aiex718/CCTV3.0-F407/MDK/CCTV3_F407_MDK_REV200/Web/img/constructive_bg_03.jpg

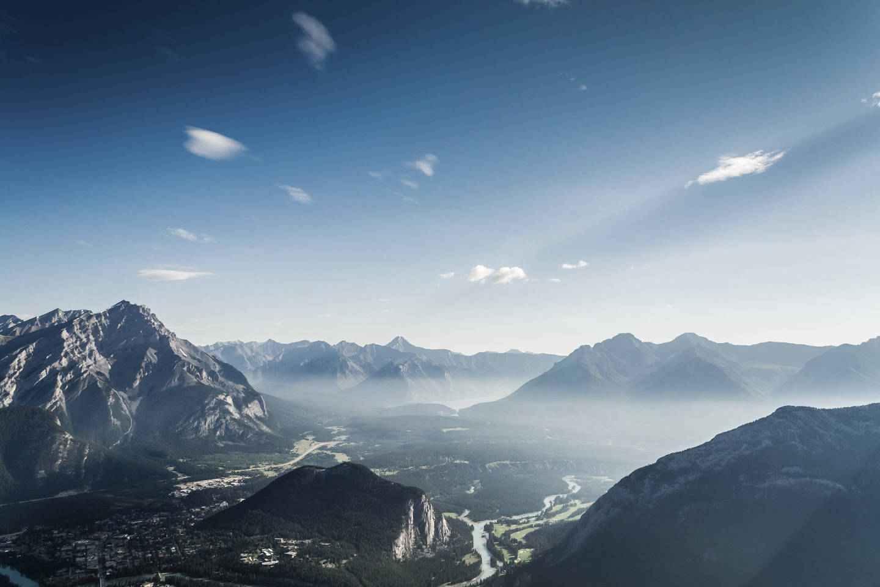
MDK/CCTV3_F407_MDK_REV200/Web/img/constructive_bg_03.jpg
