aiex718/CCTV3.0-F407/PCB/CCTV3_F407_REV200/CubeMX/CCTV3_F407_REV200.pdf

25/10/2022

CCTV3_F407_REV200 Project
Configuration Report

## 1. Description

### 1.1. Project

Project Name | CCTV3_F407_REV200
Board Name | custom
Generated with: | STM32CubeMX 6.5.0
Date | 10/25/2022

### 1.2. MCU

MCU Series | STM32F4
MCU Line | STM32F407/417
MCU name | STM32F407VETx
MCU Package | LQFP100
MCU Pin number | 100

### 1.3. Core(s) information

Core(s) | Arm Cortex-M4

## 2. Pinout Configuration

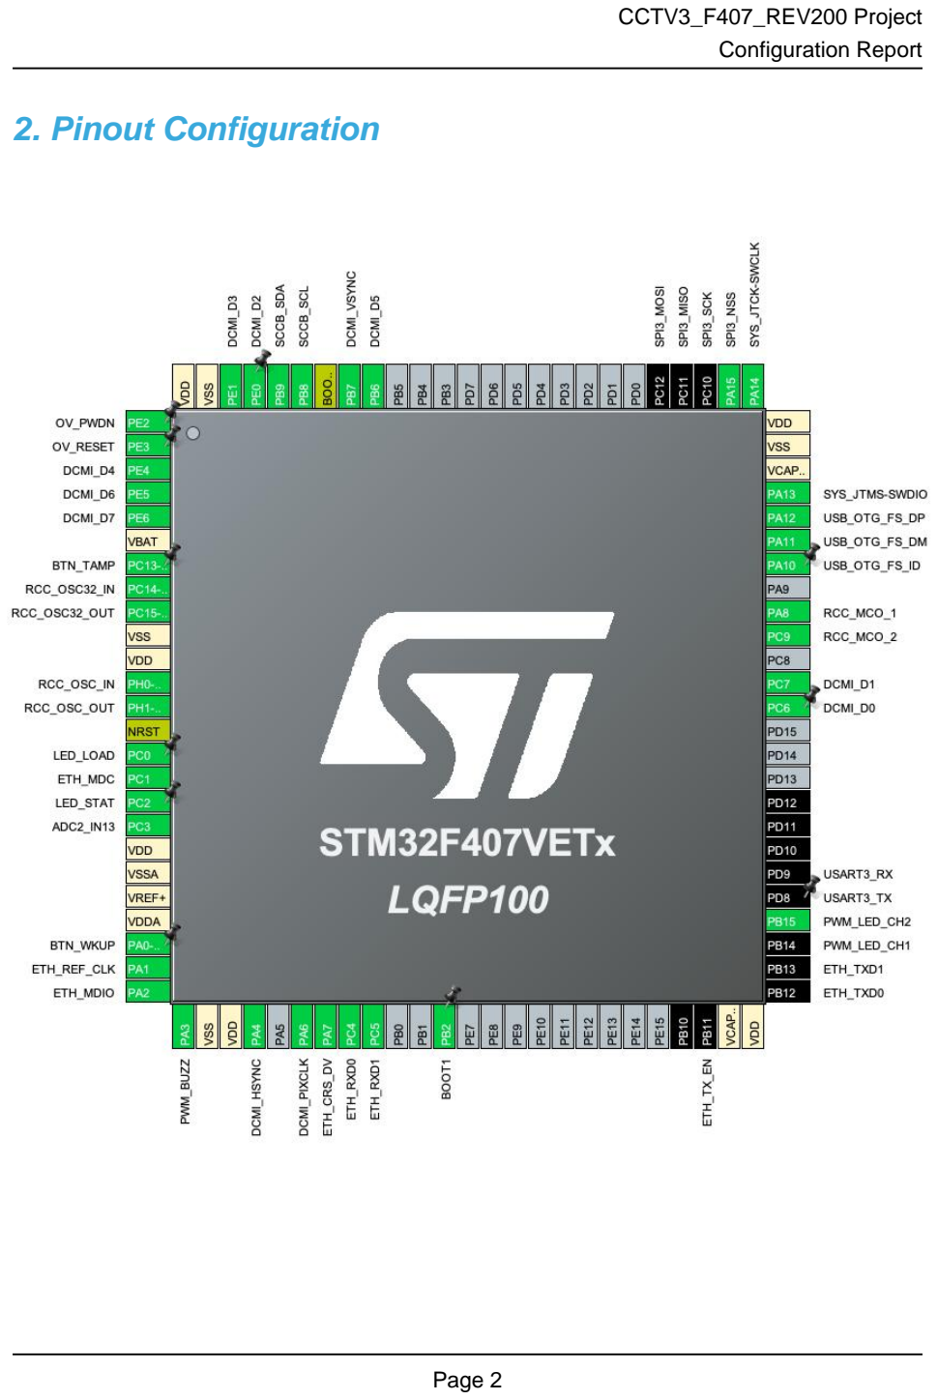
[picture p4: page 3]

## 3. Pins Configuration

Pin Number LQFP100 | Pin Name (function after reset) | Pin Type | Alternate Function(s) | Label
1 | PE2 * | I/O | GPIO_Output | OV_PWDN
2 | PE3 * | I/O | GPIO_Output | OV_RESET
3 | PE4 | I/O | DCMI_D4
4 | PE5 | I/O | DCMI_D6
5 | PE6 | I/O | DCMI_D7
6 | VBAT | Power
7 | PC13-ANTI_TAMP * | I/O | GPIO_Input | BTN_TAMP
8 | PC14-OSC32_IN | I/O | RCC_OSC32_IN
9 | PC15-OSC32_OUT | I/O | RCC_OSC32_OUT
10 | VSS | Power
11 | VDD | Power
12 | PH0-OSC_IN | I/O | RCC_OSC_IN
13 | PH1-OSC_OUT | I/O | RCC_OSC_OUT
14 | NRST | Reset
15 | PC0 * | I/O | GPIO_Output | LED_LOAD
16 | PC1 | I/O | ETH_MDC
17 | PC2 * | I/O | GPIO_Output | LED_STAT
18 | PC3 | I/O | ADC2_IN13
19 | VDD | Power
20 | VSSA | Power
21 | VREF+ | Power
22 | VDDA | Power
23 | PA0-WKUP * | I/O | GPIO_Input | BTN_WKUP
24 | PA1 | I/O | ETH_REF_CLK
25 | PA2 | I/O | ETH_MDIO
26 | PA3 | I/O | TIM9_CH2 | PWM_BUZZ
27 | VSS | Power
28 | VDD | Power
29 | PA4 | I/O | DCMI_HSYNC
31 | PA6 | I/O | DCMI_PIXCLK
32 | PA7 | I/O | ETH_CRS_DV
33 | PC4 | I/O | ETH_RXD0
34 | PC5 | I/O | ETH_RXD1
37 | PB2 * | I/O | GPIO_Input | BOOT1
48 | PB11 | I/O | ETH_TX_EN
49 | VCAP_1 | Power

Pin Number LQFP100 | Pin Name (function after reset) | Pin Type | Alternate Function(s) | Label
50 | VDD | Power
51 | PB12 | I/O | ETH_TXD0
52 | PB13 | I/O | ETH_TXD1
53 | PB14 | I/O | TIM12_CH1 | PWM_LED_CH1
54 | PB15 | I/O | TIM12_CH2 | PWM_LED_CH2
55 | PD8 | I/O | USART3_TX
56 | PD9 | I/O | USART3_RX
63 | PC6 | I/O | DCMI_D0
64 | PC7 | I/O | DCMI_D1
66 | PC9 | I/O | RCC_MCO_2
67 | PA8 | I/O | RCC_MCO_1
69 | PA10 * | I/O | GPIO_Input | USB_OTG_FS_ID
70 | PA11 | I/O | USB_OTG_FS_DM
71 | PA12 | I/O | USB_OTG_FS_DP
72 | PA13 | I/O | SYS_JTMS-SWDIO
73 | VCAP_2 | Power
74 | VSS | Power
75 | VDD | Power
76 | PA14 | I/O | SYS_JTCK-SWCLK
77 | PA15 | I/O | SPI3_NSS
78 | PC10 | I/O | SPI3_SCK
79 | PC11 | I/O | SPI3_MISO
80 | PC12 | I/O | SPI3_MOSI
92 | PB6 | I/O | DCMI_D5
93 | PB7 | I/O | DCMI_VSYNC
94 | BOOT0 | Boot
95 | PB8 | I/O | I2C1_SCL | SCCB_SCL
96 | PB9 | I/O | I2C1_SDA | SCCB_SDA
97 | PE0 | I/O | DCMI_D2
98 | PE1 | I/O | DCMI_D3
99 | VSS | Power
100 | VDD | Power

* The pin is affected with an I/O function

## 4. Clock Tree Configuration

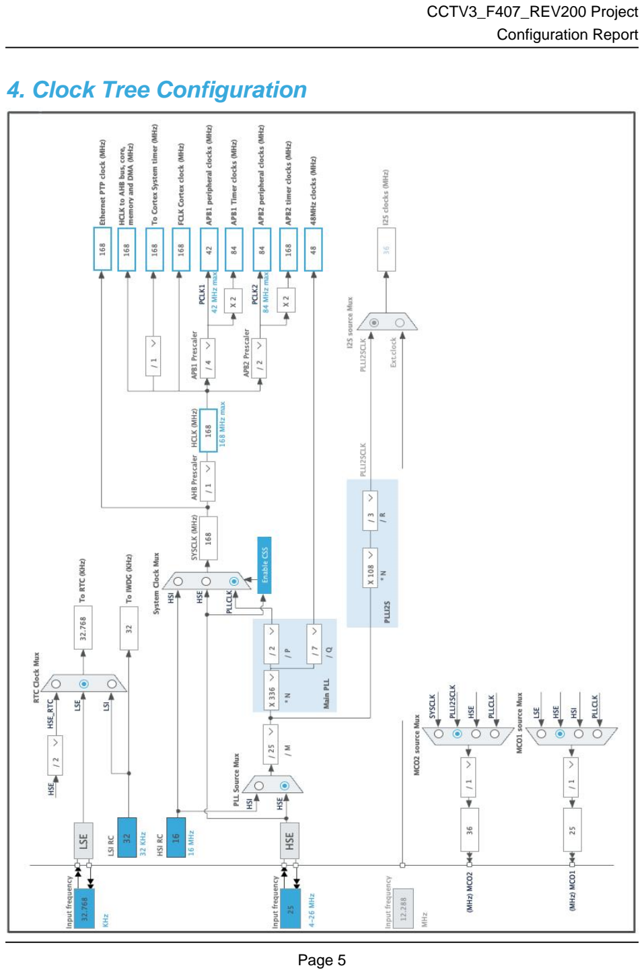
[picture p5: page 6]

## 5. Software Project

### 5.1. Project Settings

Name | Value
Project Name | CCTV3_F407_REV200
Project Folder | /Users/aiex718/Private/Workspace/CCTV3.0-
Toolchain / IDE | EWARM V8.50
Firmware Package Name and Version | STM32Cube FW_F4 V1.27.1
Application Structure | Advanced
Generate Under Root | No
Do not generate the main() | No
Minimum Heap Size | 0x200
Minimum Stack Size | 0x400

### 5.2. Code Generation Settings

Name | Value
STM32Cube MCU packages and embedded software | Copy all used libraries into the project folder
Generate peripheral initialization as a pair of '.c/.h' files | No
Backup previously generated files when re-generating | No
Keep User Code when re-generating | Yes
Delete previously generated files when not re-generated | Yes
Set all free pins as analog (to optimize the power consumption) | No
Enable Full Assert | No

### 5.3. Advanced Settings - Generated Function Calls

Rank | Function Name | Peripheral Instance Name
1 | SystemClock_Config | RCC
2 | MX_GPIO_Init | GPIO
3 | MX_ADC1_Init | ADC1
4 | MX_ADC2_Init | ADC2
5 | MX_DCMI_Init | DCMI
6 | MX_ETH_Init | ETH
7 | MX_I2C1_Init | I2C1
8 | MX_IWDG_Init | IWDG
9 | MX_RNG_Init | RNG
10 | MX_RTC_Init | RTC
11 | MX_SPI3_Init | SPI3

Rank | Function Name | Peripheral Instance Name
12 | MX_TIM9_Init | TIM9
13 | MX_TIM12_Init | TIM12
14 | MX_USART3_UART_Init | USART3
15 | MX_FATFS_Init | FATFS
16 | MX_USB_DEVICE_Init | USB_DEVICE

## 6. Power Consumption Calculator report

### 6.1. Microcontroller Selection

Series | STM32F4
Line | STM32F407/417
MCU | STM32F407VETx
Datasheet | DS8626_Rev8

### 6.2. Parameter Selection

Temperature | 25
Vdd | 3.3

### 6.3. Battery Selection

Battery | Li-SOCL2(A3400)
Capacity | 3400.0 mAh
Self Discharge | 0.08 %/month
Nominal Voltage | 3.6 V
Max Cont Current | 100.0 mA
Max Pulse Current | 200.0 mA
Cells in series | 1
Cells in parallel | 1

### 6.4. Sequence

Step | Step1 | Step2
Mode | RUN | STOP
Vdd | 3.3 | 3.3
Voltage Source | Battery | Battery
Range | Scale1-High | No Scale
Fetch Type | FLASH | n/a
CPU Frequency | 168 MHz | 0 Hz
Clock Configuration | HSE PLL | Regulator_LP Flash-PwrDwn
Clock Source Frequency | 4 MHz | 0 Hz
Peripherals
Additional Cons. | 0 mA | 0 mA
Average Current | 46 mA | 280 µA
Duration | 0.1 ms | 0.9 ms
DMIPS | 210.0 | 0.0
Ta Max | 98.47 | 104.96
Category | In DS Table | In DS Table

### 6.5. Results

Sequence Time | 1 ms | Average Current | 4.85 mA
Battery Life | 29 days, 4 hours | Average DMIPS | 210.0 DMIPS

### 6.6. Chart

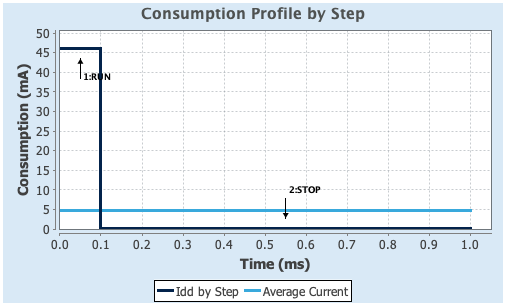
[picture p6: figure]

## 7. Peripherals and Middlewares Configuration

### 7.1. ADC1

mode: Temperature Sensor Channel
7.1.1. Parameter Settings:

ADCs_Common_Settings:

Mode | Independent mode
ADC_Settings:
Clock Prescaler | PCLK2 divided by 4
Resolution | 12 bits (15 ADC Clock cycles)
Data Alignment | Right alignment
Scan Conversion Mode | Disabled
Continuous Conversion Mode | Disabled
Discontinuous Conversion Mode | Disabled
DMA Continuous Requests | Disabled
End Of Conversion Selection | EOC flag at the end of single channel conversion
ADC_Regular_ConversionMode:
Number Of Conversion | 1
External Trigger Conversion Source | Regular Conversion launched by software
External Trigger Conversion Edge | None
Rank | 1
Channel | Channel Temperature Sensor
Sampling Time | 3 Cycles
ADC_Injected_ConversionMode:
Number Of Conversions | 0
WatchDog:
Enable Analog WatchDog Mode | false

### 7.2. ADC2

mode: IN13
7.2.1. Parameter Settings:

ADCs_Common_Settings:

Mode | Independent mode
ADC_Settings:
Clock Prescaler | PCLK2 divided by 4
Resolution | 12 bits (15 ADC Clock cycles)
Data Alignment | Right alignment

Scan Conversion Mode | Disabled
Continuous Conversion Mode | Disabled
Discontinuous Conversion Mode | Disabled
DMA Continuous Requests | Disabled
End Of Conversion Selection | EOC flag at the end of single channel conversion
ADC_Regular_ConversionMode:
Number Of Conversion | 1
External Trigger Conversion Source | Regular Conversion launched by software
External Trigger Conversion Edge | None
Rank | 1
Channel | Channel 13
Sampling Time | 3 Cycles
ADC_Injected_ConversionMode:
Number Of Conversions | 0
WatchDog:
Enable Analog WatchDog Mode | false

### 7.3. DCMI

DCMI: Slave 8 bits External Synchro
7.3.1. Parameter Settings:

Mode Config:

Pixel clock polarity | Active on Falling edge
Vertical synchronization polarity | Active Low
Horizontal synchronization polarity | Active Low
Frequency of frame capture | All frames are captured
JPEG mode | Disabled

### 7.4. ETH

Mode: RMII
7.4.1. Parameter Settings:

General : Ethernet Configuration:

Ethernet MAC Address | 00:80:E1:00:00:00
Rx Buffers Length | 1524
Ethernet Basic Configuration:
Rx Mode | Polling Mode

7.4.2. Advanced Parameters:

External PHY Configuration:

PHY | LAN8742A_PHY_ADDRESS
PHY Reset delay these values are based on a 1 ms Systick interrupt | 0x000000FF *
PHY Configuration delay | 0x00000FFF *
PHY Read TimeOut | 0x0000FFFF *
PHY Write TimeOut | 0x0000FFFF *
Common : External PHY Configuration:
Transceiver Basic Control Register | 0x00 *
Transceiver Basic Status Register | 0x01 *
PHY Reset | 0x8000 *
Select loop-back mode | 0x4000 *
Set the full-duplex mode at 100 Mb/s | 0x2100 *
Set the half-duplex mode at 100 Mb/s | 0x2000 *
Set the full-duplex mode at 10 Mb/s | 0x0100 *
Set the half-duplex mode at 10 Mb/s | 0x0000 *
Enable auto-negotiation function | 0x1000 *
Restart auto-negotiation function | 0x0200 *
Select the power down mode | 0x0800 *
Isolate PHY from MII | 0x0400 *
Auto-Negotiation process completed | 0x0020 *
Valid link established | 0x0004 *
Jabber condition detected | 0x0002 *
Extended : External PHY Configuration:
PHY special control/status register Offset | 0x10 *
PHY Speed mask | 0x0002 *
PHY Duplex mask | 0x0004 *
PHY Interrupt Source Flag register Offset | 0x001D *
PHY Link down inturrupt | 0x000B *

### 7.5. I2C1

I2C: I2C
7.5.1. Parameter Settings:

Master Features:

I2C Speed Mode | Standard Mode
I2C Clock Speed (Hz) | 100000
Slave Features:
Clock No Stretch Mode | Disabled
Primary Address Length selection | 7-bit
Dual Address Acknowledged | Disabled
Primary slave address | 0
General Call address detection | Disabled

### 7.6. IWDG

mode: Activated
7.6.1. Parameter Settings:

Clocking:

IWDG counter clock prescaler | 4
IWDG down-counter reload value | 4095

### 7.7. RCC

High Speed Clock (HSE): Crystal/Ceramic Resonator Low Speed Clock (LSE) : Crystal/Ceramic Resonator mode: Master Clock Output 1
mode: Master Clock Output 2
7.7.1. Parameter Settings:

System Parameters:

VDD voltage (V) | 3.3
Instruction Cache | Enabled
Prefetch Buffer | Enabled
Data Cache | Enabled
Flash Latency(WS) | 5 WS (6 CPU cycle)
RCC Parameters:
HSI Calibration Value | 16

HSE Startup Timout Value (ms) | 100
LSE Startup Timout Value (ms) | 5000
Power Parameters:
Power Regulator Voltage Scale | Power Regulator Voltage Scale 1

### 7.8. RNG

mode: Activated

### 7.9. RTC

mode: Activate Clock Source
7.9.1. Parameter Settings:

General:

Hour Format | Hourformat 24
Asynchronous Predivider value | 127
Synchronous Predivider value | 255

### 7.10. SPI3

Mode: Full-Duplex Master
Hardware NSS Signal: Hardware NSS Output Signal
7.10.1. Parameter Settings:

Basic Parameters:

Frame Format | Motorola
Data Size | 8 Bits
First Bit | MSB First
Clock Parameters:
Prescaler (for Baud Rate) | 2
Baud Rate | 21.0 MBits/s *
Clock Polarity (CPOL) | Low
Clock Phase (CPHA) | 1 Edge
Advanced Parameters:
CRC Calculation | Disabled
NSS Signal Type | Output Hardware

### 7.11. SYS

Debug: Serial Wire
Timebase Source: SysTick

### 7.12. TIM9

Channel2: PWM Generation CH2
7.12.1. Parameter Settings:

Counter Settings:

Prescaler (PSC - 16 bits value) | 0
Counter Mode | Up
Counter Period (AutoReload Register - 16 bits value ) | 65535
Internal Clock Division (CKD) | No Division
auto-reload preload | Disable
PWM Generation Channel 2:
Mode | PWM mode 1
Pulse (16 bits value) | 0
Output compare preload | Enable
Fast Mode | Disable
CH Polarity | High

### 7.13. TIM12

Channel1: PWM Generation CH1 Channel2: PWM Generation CH2
7.13.1. Parameter Settings:

Counter Settings:

Prescaler (PSC - 16 bits value) | 0
Counter Mode | Up
Counter Period (AutoReload Register - 16 bits value ) | 65535
Internal Clock Division (CKD) | No Division
auto-reload preload | Disable
PWM Generation Channel 1:
Mode | PWM mode 1
Pulse (16 bits value) | 0
Output compare preload | Enable
Fast Mode | Disable

CH Polarity | High
PWM Generation Channel 2:
Mode | PWM mode 1
Pulse (16 bits value) | 0
Output compare preload | Enable
Fast Mode | Disable
CH Polarity | High

### 7.14. USART3

Mode: Asynchronous
7.14.1. Parameter Settings:

Basic Parameters:

Baud Rate | 115200
Word Length | 8 Bits (including Parity)
Parity | None
Stop Bits | 1
Advanced Parameters:
Data Direction | Receive and Transmit
Over Sampling | 16 Samples

### 7.15. USB_OTG_FS

Mode: Device_Only
7.15.1. Parameter Settings:
Speed | Device Full Speed 12MBit/s
Low power | Disabled
Link Power Management | Disabled
VBUS sensing | Disabled
Signal start of frame | Disabled

### 7.16. FATFS

mode: User-defined
7.16.1. Set Defines:

Version:

FATFS version | R0.12c
Function Parameters:
FS_READONLY (Read-only mode) | Disabled
FS_MINIMIZE (Minimization level) | Disabled
USE_STRFUNC (String functions) | Enabled with LF -> CRLF conversion
USE_FIND (Find functions) | Disabled
USE_MKFS (Make filesystem function) | Enabled
USE_FASTSEEK (Fast seek function) | Enabled
USE_EXPAND (Use f_expand function) | Disabled
USE_CHMOD (Change attributes function) | Disabled
USE_LABEL (Volume label functions) | Disabled
USE_FORWARD (Forward function) | Disabled
Locale and Namespace Parameters:
CODE_PAGE (Code page on target) | Latin 1
USE_LFN (Use Long Filename) | Disabled
MAX_LFN (Max Long Filename) | 255
LFN_UNICODE (Enable Unicode) | ANSI/OEM
STRF_ENCODE (Character encoding) | UTF-8
FS_RPATH (Relative Path) | Disabled
Physical Drive Parameters:
VOLUMES (Logical drives) | 1
MAX_SS (Maximum Sector Size) | 512
MIN_SS (Minimum Sector Size) | 512
MULTI_PARTITION (Volume partitions feature) | Disabled
USE_TRIM (Erase feature) | Disabled
FS_NOFSINFO (Force full FAT scan) | 0
System Parameters:
FS_TINY (Tiny mode) | Disabled
FS_EXFAT (Support of exFAT file system) | Disabled
FS_NORTC (Timestamp feature) | Dynamic timestamp
FS_REENTRANT (Re-Entrancy) | Disabled
FS_TIMEOUT (Timeout ticks) | 1000
FS_LOCK (Number of files opened simultaneously) | 2

### 7.17. USB_DEVICE

Class For FS IP: Mass Storage Class
7.17.1. Parameter Settings:

Basic Parameters:

USBD_MAX_NUM_INTERFACES (Maximum number of supported interfaces) | 1

USBD_MAX_NUM_CONFIGURATION (Maximum number of supported configuration) | 1
USBD_MAX_STR_DESC_SIZ (Maximum size for the string descriptors) | 512
USBD_SELF_POWERED (Enabled self power) | Enabled
USBD_DEBUG_LEVEL (USBD Debug Level) | 0: No debug message
Class Parameters:
MSC_MEDIA_PACKET (Media I/O buffer Size) | 512
7.17.2. Device Descriptor:

Device Descriptor:

VID (Vendor IDentifier) | 1155
LANGID_STRING (Language Identifier) | English(United States)
MANUFACTURER_STRING (Manufacturer Identifier) | STMicroelectronics
Device Descriptor FS:
PID (Product IDentifier) | 22314
PRODUCT_STRING (Product Identifier) | STM32 Mass Storage
CONFIGURATION_STRING (Configuration Identifier) | MSC Config
INTERFACE_STRING (Interface Identifier) | MSC Interface

* User modified value

## 8. System Configuration

### 8.1. GPIO configuration

IP | Pin | Signal | GPIO mode | GPIO pull/up pull down

Max
Speed

User Label

ADC2 | PC3 | ADC2_IN13 | Analog mode | No pull-up and no pull-down | n/a
DCMI | PE4 | DCMI_D4 | Alternate Function Push Pull | No pull-up and no pull-down | Low
| PE5 | DCMI_D6 | Alternate Function Push Pull | No pull-up and no pull-down | Low
| PE6 | DCMI_D7 | Alternate Function Push Pull | No pull-up and no pull-down | Low
PA4 | DCMI_HSYNC Alternate Function Push Pull | No pull-up and no pull-down | Low
PA6 | DCMI_PIXCLK Alternate Function Push Pull | No pull-up and no pull-down | Low
| PC6 | DCMI_D0 | Alternate Function Push Pull | No pull-up and no pull-down | Low
| PC7 | DCMI_D1 | Alternate Function Push Pull | No pull-up and no pull-down | Low
| PB6 | DCMI_D5 | Alternate Function Push Pull | No pull-up and no pull-down | Low
PB7 | DCMI_VSYNC Alternate Function Push Pull | No pull-up and no pull-down | Low
| PE0 | DCMI_D2 | Alternate Function Push Pull | No pull-up and no pull-down | Low
| PE1 | DCMI_D3 | Alternate Function Push Pull | No pull-up and no pull-down | Low
ETH | PC1 | ETH_MDC | Alternate Function Push Pull | No pull-up and no pull-down | Very High
*
PA1 | ETH_REF_CLK Alternate Function Push Pull | No pull-up and no pull-down | Very High
*
| PA2 | ETH_MDIO | Alternate Function Push Pull | No pull-up and no pull-down | Very High
*
PA7 | ETH_CRS_DV Alternate Function Push Pull | No pull-up and no pull-down | Very High
*
| PC4 | ETH_RXD0 | Alternate Function Push Pull | No pull-up and no pull-down | Very High
*
| PC5 | ETH_RXD1 | Alternate Function Push Pull | No pull-up and no pull-down | Very High
*
| PB11 | ETH_TX_EN | Alternate Function Push Pull | No pull-up and no pull-down | Very High
*
| PB12 | ETH_TXD0 | Alternate Function Push Pull | No pull-up and no pull-down | Very High
*
| PB13 | ETH_TXD1 | Alternate Function Push Pull | No pull-up and no pull-down | Very High
*
I2C1 | PB8 | I2C1_SCL | Alternate Function Open Drain | No pull-up and no pull-down | Very High
*

SCCB_SCL

| PB9 | I2C1_SDA | Alternate Function Open Drain | No pull-up and no pull-down | Very High
*

SCCB_SDA

IP | Pin | Signal | GPIO mode | GPIO pull/up pull down

Max
Speed

User Label

RCC | PC14-
OSC32_IN
RCC_OSC32_IN | n/a | n/a | n/a

PC15-
OSC32_OU
T
RCC_OSC32_O UT | n/a | n/a | n/a

PH0-
OSC_IN
| | RCC_OSC_IN | n/a | n/a | n/a
| PH1- OSC_OUT | RCC_OSC_OUT | n/a | n/a | n/a
| PC9 | RCC_MCO_2 | Alternate Function Push Pull | No pull-up and no pull-down | Low
| PA8 | RCC_MCO_1 | Alternate Function Push Pull | No pull-up and no pull-down | Low
SPI3 | PA15 | SPI3_NSS | Alternate Function Push Pull | No pull-up and no pull-down | Very High
*
| PC10 | SPI3_SCK | Alternate Function Push Pull | No pull-up and no pull-down | Very High
*
| PC11 | SPI3_MISO | Alternate Function Push Pull | No pull-up and no pull-down | Very High
*
| PC12 | SPI3_MOSI | Alternate Function Push Pull | No pull-up and no pull-down | Very High
*
SYS | PA13 | SYS_JTMS- SWDIO | n/a | n/a | n/a
| PA14 | SYS_JTCK- SWCLK | n/a | n/a | n/a
TIM9 | PA3 | TIM9_CH2 | Alternate Function Push Pull | No pull-up and no pull-down | Low | PWM_BUZZ
TIM12 | PB14 | TIM12_CH1 | Alternate Function Push Pull | No pull-up and no pull-down | Low | PWM_LED_CH1
| PB15 | TIM12_CH2 | Alternate Function Push Pull | No pull-up and no pull-down | Low | PWM_LED_CH2
USART3 | PD8 | USART3_TX | Alternate Function Push Pull | No pull-up and no pull-down | Very High
*
| PD9 | USART3_RX | Alternate Function Push Pull | No pull-up and no pull-down | Very High
*
USB_OTG_ FS | PA11 | USB_OTG_FS_ DM | Alternate Function Push Pull | No pull-up and no pull-down | Very High
*
| PA12 | USB_OTG_FS_ DP | Alternate Function Push Pull | No pull-up and no pull-down | Very High
*
GPIO | PE2 | GPIO_Output | Output Push Pull | No pull-up and no pull-down | Low | OV_PWDN
| PE3 | GPIO_Output | Output Push Pull | No pull-up and no pull-down | Low | OV_RESET
| PC13- ANTI_TAMP | GPIO_Input | Input mode | No pull-up and no pull-down | n/a | BTN_TAMP
| PC0 | GPIO_Output | Output Push Pull | No pull-up and no pull-down | Low | LED_LOAD
| PC2 | GPIO_Output | Output Push Pull | No pull-up and no pull-down | Low | LED_STAT

IP | Pin | Signal | GPIO mode | GPIO pull/up pull down | Max Speed | User Label
| PA0-WKUP | GPIO_Input | Input mode | No pull-up and no pull-down | n/a | BTN_WKUP
| PB2 | GPIO_Input | Input mode | No pull-up and no pull-down | n/a | BOOT1
| PA10 | GPIO_Input | Input mode | No pull-up and no pull-down | n/a | USB_OTG_FS_ID

### 8.2. DMA configuration

nothing configured in DMA service

### 8.3. NVIC configuration

8.3.1. NVIC
Interrupt Table | Enable | Preenmption Priority | SubPriority
Non maskable interrupt | true | 0 | 0
Hard fault interrupt | true | 0 | 0
Memory management fault | true | 0 | 0
Pre-fetch fault, memory access fault | true | 0 | 0
Undefined instruction or illegal state | true | 0 | 0
System service call via SWI instruction | true | 0 | 0
Debug monitor | true | 0 | 0
Pendable request for system service | true | 0 | 0
System tick timer | true | 15 | 0
USB On The Go FS global interrupt | true | 0 | 0
PVD interrupt through EXTI line 16 | | unused
Flash global interrupt | | unused
RCC global interrupt | | unused
ADC1, ADC2 and ADC3 global interrupts | | unused
TIM1 break interrupt and TIM9 global interrupt | | unused
I2C1 event interrupt | | unused
I2C1 error interrupt | | unused
USART3 global interrupt | | unused
TIM8 break interrupt and TIM12 global interrupt | | unused
SPI3 global interrupt | | unused
Ethernet global interrupt | | unused
Ethernet wake-up interrupt through EXTI line 19 | | unused
DCMI global interrupt | | unused
HASH and RNG global interrupts | | unused
FPU global interrupt | | unused
8.3.2. NVIC Code generation

Enabled interrupt Table Select for init
sequence ordering
| | Generate IRQ
| | handler | Call HAL handler
Non maskable interrupt | false | true | false
Hard fault interrupt | false | true | false
Memory management fault | false | true | false
Pre-fetch fault, memory access fault | false | true | false
Undefined instruction or illegal state | false | true | false
System service call via SWI instruction | false | true | false
Debug monitor | false | true | false
Pendable request for system service | false | true | false

Enabled interrupt Table | Select for init sequence ordering | Generate IRQ handler | Call HAL handler
System tick timer | false | true | true
USB On The Go FS global interrupt | false | true | true

* User modified value

## 9. System Views

9.1. Category view
9.1.1. Current

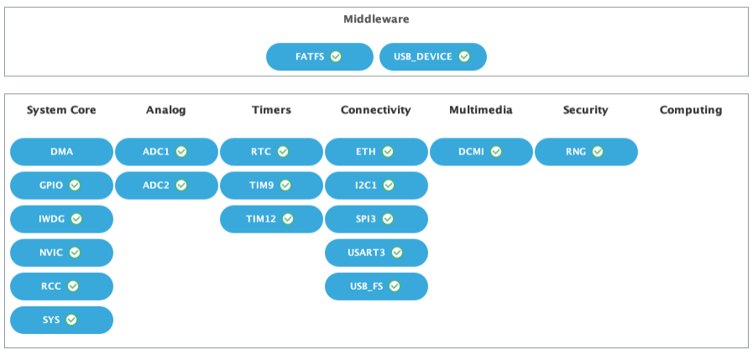
[picture p7: figure]

## 10. Docs & Resources

Type | Link
Presentations | https://www.st.com/resource/en/product_presentation/stm32-stm8_embedded_software_solutions.pdf
Presentations | https://www.st.com/resource/en/product_presentation/stm32_eval-tools_portfolio.pdf
Presentations | https://www.st.com/resource/en/product_presentation/stm32_stm8_functi onal-safety-packages.pdf
Presentations | https://www.st.com/resource/en/product_presentation/stm32-stm8_software_development_tools.pdf
Training Material | https://www.st.com/resource/en/sales_guide/sg_sc2154.pdf
Flyers | https://www.st.com/resource/en/flyer/flnucleolrwan.pdf
Flyers | https://www.st.com/resource/en/flyer/flstm32nucleo.pdf
Flyers | https://www.st.com/resource/en/flyer/flstmcsuite.pdf
Flyers | https://www.st.com/resource/en/flyer/flstm32trust.pdf
Product Certifications | https://www.st.com/resource/en/certification_document/stm32_authentication_can.pdf
Application Notes | https://www.st.com/resource/en/application_note/an1181-electrostatic-discharge-sensitivity-measurement-stmicroelectronics.pdf
Application Notes | https://www.st.com/resource/en/application_note/an1709-emc-design-guide-for-stm8-stm32-and-legacy-mcus-stmicroelectronics.pdf
Application Notes | https://www.st.com/resource/en/application_note/an2606-stm32-microcontroller-system-memory-boot-mode-stmicroelectronics.pdf
Application Notes | https://www.st.com/resource/en/application_note/an2639-soldering-recommendations-and-package-information-for-leadfree-ecopack-mcus-and-mpus-stmicroelectronics.pdf
Application Notes | https://www.st.com/resource/en/application_note/an2834-how-to-get-the-best-adc-accuracy-in-stm32-microcontrollers-stmicroelectronics.pdf
Application Notes | https://www.st.com/resource/en/application_note/an2867-oscillator-design-guide-for-stm8afals-stm32-mcus-and-mpus-stmicroelectronics.pdf
Application Notes | https://www.st.com/resource/en/application_note/an2945-stm8s-and-

| stm32-mcus-a-consistent-832bit-product-line-for-painless-migration-stmicroelectronics.pdf
Application Notes | https://www.st.com/resource/en/application_note/an3070-managing-the-driver-enable-signal-for-rs485-and-iolink-communications-with-the-stm32s-usart-stmicroelectronics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
Application Notes | https://www.st.com/resource/en/application_note/an3126-audio-and-waveform-generation-using-the-dac-in-stm32-products-stmicroelectronics.pdf
Application Notes | https://www.st.com/resource/en/application_note/an3154-can-protocol-used-in-the-stm32-bootloader-stmicroelectronics.pdf
Application Notes | https://www.st.com/resource/en/application_note/an3155-usart-protocol-used-in-the-stm32-bootloader-stmicroelectronics.pdf
Application Notes | https://www.st.com/resource/en/application_note/an3156-usb-dfu-protocol-used-in-the-stm32-bootloader-stmicroelectronics.pdf
Application Notes | https://www.st.com/resource/en/application_note/an3364-migration-and-compatibility-guidelines-for-stm32-microcontroller-applications-stmicroelectronics.pdf
Application Notes | https://www.st.com/resource/en/application_note/an3371-using-the-hardware-realtime-clock-rtc-in-stm32-f0-f2-f3-f4-and-l1-series-of-mcus-stmicroelectronics.pdf
Application Notes | https://www.st.com/resource/en/application_note/an3997-audio-playback-and-recording-using-the-stm32f4discovery-stmicroelectronics.pdf
Application Notes | https://www.st.com/resource/en/application_note/an3998-pdm-audio-software-decoding-on-stm32-microcontrollers-stmicroelectronics.pdf
Application Notes | https://www.st.com/resource/en/application_note/an4013-stm32-crossseries-timer-overview-stmicroelectronics.pdf
Application Notes | https://www.st.com/resource/en/application_note/an4031-using-the-stm32f2-stm32f4-and-stm32f7-series-dma-controller-stmicroelectronics.pdf
Application Notes | https://www.st.com/resource/en/application_note/an4073-how-to-improve-adc-accuracy-when-using-stm32f2xx-and-stm32f4xx-microcontrollers-stmicroelectronics.pdf
Application Notes | https://www.st.com/resource/en/application_note/an4076-two-or-three-

| shunt-resistor-based-current-sensing-circuit-design-in-3phase-inverters-stmicroelectronics.pdf
Application Notes | https://www.st.com/resource/en/application_note/an4221-i2c-protocol-used-in-the-stm32-bootloader-stmicroelectronics.pdf
Application Notes | https://www.st.com/resource/en/application_note/an4229-how-to-implement-a-vocoder-solution-using-stm32-microcontrollers-stmicroelectronics.pdf
Application Notes | https://www.st.com/resource/en/application_note/an4230-stm32-microcontroller-random-number-generation-validation-using-the-nist-statistical-test-suite-stmicroelectro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
Application Notes | https://www.st.com/resource/en/application_note/an4277-using-stm32-device-pwm-shutdown-features-for-motor-control-and-digital-power-conversion-stmicroelectronics.pdf
Application Notes | https://www.st.com/resource/en/application_note/an4286-spi-protocol-used-in-the-stm32-bootloader-stmicroelectronics.pdf
Application Notes | https://www.st.com/resource/en/application_note/an4488-getting-started-with-stm32f4xxxx-mcu-hardware-development-stmicroelectronics.pdf
Application Notes | https://www.st.com/resource/en/application_note/an4547-migrating-from-stm32f407xx417xx-to-stm32f427xx429xx437xx439xx-stmicroelectronics.pdf
Application Notes | https://www.st.com/resource/en/application_note/an4566-extending-the-dac-performance-of-stm32-microcontrollers-stmicroelectronics.pdf
Application Notes | https://www.st.com/resource/en/application_note/an4640-peripherals-interconnections-on-stm32f4057xx-stm32f4157xx-stm32f42xxx-stm32f43xxx-stm32f446xx-and-stm32f469479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
Application Notes | https://www.st.com/resource/en/application_note/an4655-virtually-increasing-the-number-of-serial-communication-peripherals-in-stm32-applications-stmicroelectronics.p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
Application Notes | https://www.st.com/resource/en/application_note/an4739-stm32cube-firmware-examples-for-stm32f4-series-stmicroelectronics.pdf
Application Notes | https://www.st.com/resource/en/application_note/an4750-handling-of-soft-errors-in-stm32-applications-stmicroelectronics.pdf
Application Notes | https://www.st.com/resource/en/application_note/an4759-using-the-

| hardware-realtime-clock-rtc-and-the-tamper-management-unit-tamp-with-stm32-microcontrollers-stmicroelectronics.pdf
Application Notes | https://www.st.com/resource/en/application_note/an4776-generalpurpose-timer-cookbook-for-stm32-microcontrollers-stmicroelectronics.pdf
Application Notes | https://www.st.com/resource/en/application_note/an4803-highspeed-si-simulations-using-ibis-and-boardlevel-simulations-using-hyperlynx-si-on-stm32-mcus-and-mpus-stmic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
Application Notes | https://www.st.com/resource/en/application_note/an4821-migrating-from-stm32f405415-line-and-stm32f407417-line-to-stm32l4-series-and-stm32l4-series-microcontrollers-s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
Application Notes | https://www.st.com/resource/en/application_note/an4838-managing-memory-protection-unit-in-stm32-mcus-stmicroelectronics.pdf
Application Notes | https://www.st.com/resource/en/application_note/an4850-stm32-mcus-spreadspectrum-clock-generation-principles-properties-and-implementation-stmicroelectronics.pdf
Application Notes | https://www.st.com/resource/en/application_note/an4879-usb-hardware-and-pcb-guidelines-using-stm32-mcus-stmicroelectronics.pdf
Application Notes | https://www.st.com/resource/en/application_note/an4908-stm32-usart-automatic-baud-rate-detection-stmicroelectronics.pdf
Application Notes | https://www.st.com/resource/en/application_note/an4989-stm32-microcontroller-debug-toolbox-stmicroelectronics.pdf
Application Notes | https://www.st.com/resource/en/application_note/an4995-using-an-electromyogram-technique-to-detect-muscle-activity-stmicroelectronics.pdf
Application Notes | https://www.st.com/resource/en/application_note/an5020-digital-camera-interface-dcmi-on-stm32-mcus-stmicroelectronics.pdf
Application Notes | https://www.st.com/resource/en/application_note/an5027-interfacing-pdm-digital-microphones-using-stm32-mcus-and-mpus-stmicroelectronics.pdf
Application Notes | https://www.st.com/resource/en/application_note/an5036-thermal-management-guidelines-for-stm32-applications-stmicroelectronics.pdf
Application Notes | https://www.st.com/resource/en/application_note/an5073-receiving-spdif-audio-stream-with-the-stm32f4f7h7-series-stmicroelectronics.pdf
Application Notes | https://www.st.com/resource/en/application_note/an5156-introduction-to-

| stm32-microcontrollers-security-stmicroelectronics.pdf
Application Notes | https://www.st.com/resource/en/application_note/an5225-usb-typec-power-delivery-using-stm32-mcus-and-mpus-stmicroelectronics.pdf
Application Notes | https://www.st.com/resource/en/application_note/an5543-enhanced-methods-to-handle-spi-communication-on-stm32-devices-stmicroelectronics.pdf
Application Notes | https://www.st.com/resource/en/application_note/an4899-stm32-microcontroller-gpio-hardware-settings-and-lowpower-consumption-stmicroelectronics.pdf
Application Notes for related Tools & Software | https://www.st.com/resource/en/application_note/an1202_freertos_guide-freertos-guide-stmicroelectronics.pdf
Application Notes for related Tools & Software | https://www.st.com/resource/en/application_note/an1602_semihosting_in_truestudio-how-to-do-semihosting-in-truestudio-stmicroelectronics.pdf
Application Notes for related Tools & Software | https://www.st.com/resource/en/application_note/an1801_stm32cubeprogrammer_in_truestudio-installing-stm32cubeprogrammer-in-truestudio-stmicroelectronics.pdf
Application Notes for related Tools & Software | https://www.st.com/resource/en/application_note/atollic_editing_keyboard_shortcuts-atollic-editing-keyboard-shortcuts-stmicroelectronics.pdf
Application Notes for related Tools & Software | https://www.st.com/resource/en/application_note/iar_to_atollic_truestudio_migration_guide-truestudio-for-arm-migration-guide-iar-embedded-workbench-to-truestudio-stm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
Application Notes for related Tools & Software | https://www.st.com/resource/en/application_note/stm32cubemx_installation_in_truestudio-stm32cubemx-installation-in-truestudio-stmicroelectronics.pdf
Application Notes for related Tools & Software | https://www.st.com/resource/en/application_note/an2656-stm32f10xxx-lcd-glass-driver-firmware-stmicroelectronics.pdf
Application Notes for related Tools & Software | https://www.st.com/resource/en/application_note/an2790-tft-lcd-interfacing-with-the-highdensity-stm32f10xxx-fsmc-stmicroelectronics.pdf
Application Notes | https://www.st.com/resource/en/application_note/an3078-stm32-

for related Tools & Software | inapplication-programming-over-the-ic-bus-stmicroelectronics.pdf
Application Notes for related Tools & Software | https://www.st.com/resource/en/application_note/an3116-stm32s-adc-modes-and-their-applications-stmicroelectronics.pdf
Application Notes for related Tools & Software | https://www.st.com/resource/en/application_note/an3174-implementing-receivers-for-infrared-remote-control-protocols-using-stm32f10xxx-microcontrollers-stmicroelectro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
Application Notes for related Tools & Software | https://www.st.com/resource/en/application_note/an3241-qvga-tftlcd-direct-drive-using-the-stm32f10xx-fsmc-peripheral-stmicroelectronics.pdf
Application Notes for related Tools & Software | https://www.st.com/resource/en/application_note/an3307-guidelines-for-obtaining-iec-60335-class-b-certification-for-any-stm32-application-stmicroelectronics.pdf
Application Notes for related Tools & Software | https://www.st.com/resource/en/application_note/an3364-migration-and-compatibility-guidelines-for-stm32-microcontroller-applications-stmicroelectronics.pdf
Application Notes for related Tools & Software | https://www.st.com/resource/en/application_note/an3965-stm32f40xstm32f41x-inapplication-programming-using-the-usart-stmicroelectronics.pdf
Application Notes for related Tools & Software | https://www.st.com/resource/en/application_note/an3966-lwip-tcpip-stack-demonstration-for-stm32f4x7-microcontrollers-stmicroelectronics.pdf
Application Notes for related Tools & Software | https://www.st.com/resource/en/application_note/an3968-stm32f407stm32f417-inapplication-programming-iap-over-ethernet-stmicroelectronics.pdf
Application Notes for related Tools & Software | https://www.st.com/resource/en/application_note/an3969-eeprom-emulation-in-stm32f40xstm32f41x-microcontrollers-stmicroelectronics.pdf
Application Notes for related Tools & Software | https://www.st.com/resource/en/application_note/an3988-clock-configuration-tool-for-stm32f40xx41xx427x437x-microcontrollers-stmicroelectronics.pdf

Application Notes
for related Tools

https://www.st.com/resource/en/application_note/an3990-upgradingstm32f4discovery-board-firmware-using-a-usb-key-stmicroelectronics.pdf

& Software
Application Notes for related Tools & Software | https://www.st.com/resource/en/application_note/an3997-audio-playback-and-recording-using-the-stm32f4discovery-stmicroelectronics.pdf
Application Notes for related Tools & Software | https://www.st.com/resource/en/application_note/an3998-pdm-audio-software-decoding-on-stm32-microcontrollers-stmicroelectronics.pdf
Application Notes for related Tools & Software | https://www.st.com/resource/en/application_note/an4044-floating-point-unit-demonstration-on-stm32-microcontrollers-stmicroelectronics.pdf
Application Notes for related Tools & Software | https://www.st.com/resource/en/application_note/an4187-using-the-crc-peripheral-in-the-stm32-family-stmicroelectronics.pdf
Application Notes for related Tools & Software | https://www.st.com/resource/en/application_note/an4323-getting-started-with-stemwin-library-stmicroelectronics.pdf
Application Notes for related Tools & Software | https://www.st.com/resource/en/application_note/an4365-using-stm32f4-mcu-power-modes-with-best-dynamic-efficiency-stmicroelectronics.pdf
Application Notes for related Tools & Software | https://www.st.com/resource/en/application_note/an4435-guidelines-for-obtaining-ulcsaiec-607301603351-class-b-certification-in-any-stm32-application-stmicroelectroni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
Application Notes for related Tools & Software | https://www.st.com/resource/en/application_note/an4457-implementing-an-emulated-uart-on-stm32f4-microcontrollers-stmicroelectronics.pdf
Application Notes for related Tools & Software | https://www.st.com/resource/en/application_note/an4499-stm32--nrf51822-bluetooth-low-energy-system-solution-stmicroelectronics.pdf
Application Notes for related Tools & Software | https://www.st.com/resource/en/application_note/an4502-stm32-smbuspmbus-embedded-software-expansion-for-stm32cube-stmicroelectronics.pdf
Application Notes for related Tools & Software | https://www.st.com/resource/en/application_note/an4657-stm32-inapplication-programming-iap-using-the-usart-stmicroelectronics.pdf

Application Notes for related Tools & Software | https://www.st.com/resource/en/application_note/an4666-parallel-synchronous-transmission-using-gpio-and-dma-stmicroelectronics.pdf
Application Notes for related Tools & Software | https://www.st.com/resource/en/application_note/an4678-full-duplex-spi-emulation-for-stm32f4-microcontrollers-stmicroelectronics.pdf
Application Notes for related Tools & Software | https://www.st.com/resource/en/application_note/an4701-proprietary-code-readout-protection-on-microcontrollers-of-the-stm32f4-series-stmicroelectronics.pdf
Application Notes for related Tools & Software | https://www.st.com/resource/en/application_note/an4739-stm32cube-firmware-examples-for-stm32f4-series-stmicroelectronics.pdf
Application Notes for related Tools & Software | https://www.st.com/resource/en/application_note/an4758-proprietary-code-readout-protection-on-stm32l4-stm32l4-stm32g4-and-stm32wb-series-mcus-stmicroelectronics.pdf
Application Notes for related Tools & Software | https://www.st.com/resource/en/application_note/an4759-using-the-hardware-realtime-clock-rtc-and-the-tamper-management-unit-tamp-with-stm32-microcontrollers-stmicroe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
Application Notes for related Tools & Software | https://www.st.com/resource/en/application_note/an4841-digital-signal-processing-for-stm32-microcontrollers-using-cmsis-stmicroelectronics.pdf
Application Notes for related Tools & Software | https://www.st.com/resource/en/application_note/an4968-proprietary-code-read-out-protection-pcrop-on-stm32f72xxx-and-stm32f73xxx-microcontrollers-stmicroelectronics.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
Application Notes for related Tools & Software | https://www.st.com/resource/en/application_note/an5054-secure-programming-using-stm32cubeprogrammer-stmicroelectronics.pdf
Application Notes for related Tools & Software | https://www.st.com/resource/en/application_note/an5056-integration-guide-for-the-xcubesbsfu-stm32cube-expansion-package-stmicroelectronics.pdf
Application Notes for related Tools & Software | https://www.st.com/resource/en/application_note/an5360-getting-started-with-projects-based-on-the-stm32mp1-series-in-stm32cubeide-stmicroelectronics.pdf
Application Notes | https://www.st.com/resource/en/application_note/an5361-getting-started-

for related Tools & Software | with-projects-based-on-dualcore-stm32h7-microcontrollers-in-stm32cubeide-stmicroelectronics.pdf
Application Notes for related Tools & Software | https://www.st.com/resource/en/application_note/an5394-getting-started-with-projects-based-on-the-stm32l5-series-in-stm32cubeide-stmicroelectronics.pdf
Application Notes for related Tools & Software | https://www.st.com/resource/en/application_note/an5418-how-to-build-a-simple-usbpd-sink-application-with-stm32cubemx-stmicroelectronics.pdf
Application Notes for related Tools & Software | https://www.st.com/resource/en/application_note/an5426-migrating-graphics-middleware-projects-from-stm32cubemx-540-to-stm32cubemx-550-stmicroelectronics.pdf
Application Notes for related Tools & Software | https://www.st.com/resource/en/application_note/an5464-position-control-of-a-threephase-permanent-magnet-motor-using-xcubemcsdk-or-xcubemcsdkful-stmicroelectronics.p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
Application Notes for related Tools & Software | https://www.st.com/resource/en/application_note/an5564-getting-started-with-projects-based-on-dualcore-stm32wl-microcontrollers-in-stm32cubeide-stmicroelectronics.pd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
Application Notes for related Tools & Software | https://www.st.com/resource/en/application_note/an5698-adapting-the-xcubestl-functional-safety-package-for-stm32-iec-61508-compliant-to-other-safety-standards-stmicr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
Application Notes for related Tools & Software | https://www.st.com/resource/en/application_note/an5731-stm32cubemx-and-stm32cubeide-threadsafe-solution-stmicroelectronics.pdf
Errata Sheets | https://www.st.com/resource/en/errata_sheet/es0182-stm32f405407xx-and-stm32f415417xx-device-limitations-stmicroelectronics.pdf
Datasheet | https://www.st.com/resource/en/datasheet/dm00037051.pdf
Programming Manuals | https://www.st.com/resource/en/programming_manual/pm0214-stm32-cortexm4-mcus-and-mpus-programming-manual-stmicroelectronics.pdf
Reference Manuals | https://www.st.com/resource/en/reference_manual/rm0090-stm32f405415-stm32f407417-stm32f427437-and-stm32f429439-advanced-armbased-32bit-mcus-stmicroelectronics.pdf
Technical Notes & Articles | https://www.st.com/resource/en/technical_note/tn0516-overview-of-the-stm32f0xf100xxf103xx-and-stm32f2xxf30xf4xx-mcus-pmsm-singledual-foc-sdk-v40-stmicroelectronics.p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

Technical Notes & Articles | https://www.st.com/resource/en/technical_note/tn1163-description-of-wlcsp-for-microcontrollers-and-recommendations-for-its-use-stmicroelectronics.pdf
Technical Notes & Articles | https://www.st.com/resource/en/technical_note/tn1204-tape-and-reel-shipping-media-for-stm32-microcontrollers-in-bga-packages-stmicroelectronics.pdf
Technical Notes & Articles | https://www.st.com/resource/en/technical_note/tn1205-tape-and-reel-shipping-media-for-stm8-and-stm32-microcontrollers-in-fpn-packages-stmicroelectronics.pdf
Technical Notes & Articles | https://www.st.com/resource/en/technical_note/tn1206-tape-and-reel-shipping-media-for-stm8-and-stm32-microcontrollers-in-qfp-packages-stmicroelectronics.pdf
Technical Notes & Articles | https://www.st.com/resource/en/technical_note/tn1207-tape-and-reel-shipping-media-for-stm8-and-stm32-microcontrollers-in-so-packages-stmicroelectronics.pdf
Technical Notes & Articles | https://www.st.com/resource/en/technical_note/tn1208-tape-and-reel-shipping-media-for-stm8-and-stm32-microcontrollers-in-tssop-and-ssop-packages-stmicroelectronics.p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
