aiex718/CCTV3.0-F407/PCB/CCTV3_POE_REV100/Note/eurofast_m12_conn.png

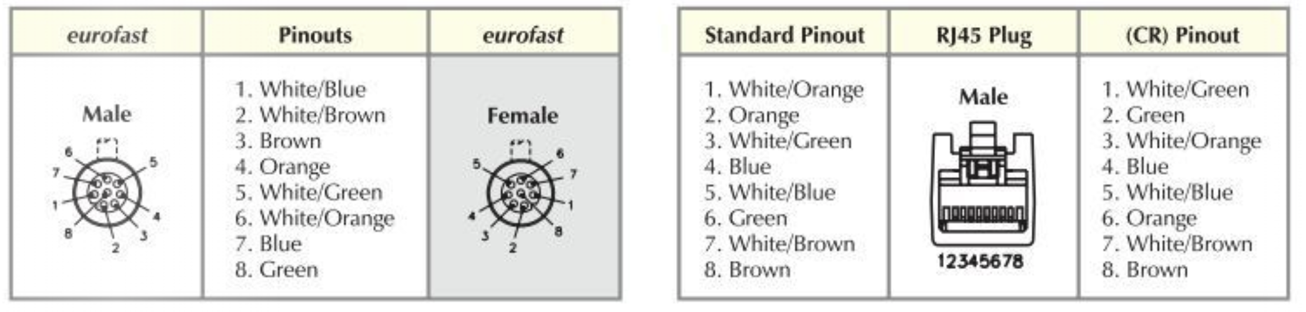
PCB/CCTV3_POE_REV100/Note/eurofast_m12_conn.png
