aiex718/CCTV3.0-F407/PCB/CCTV3_POE_REV100/Note/M12_8p_3d.jpg

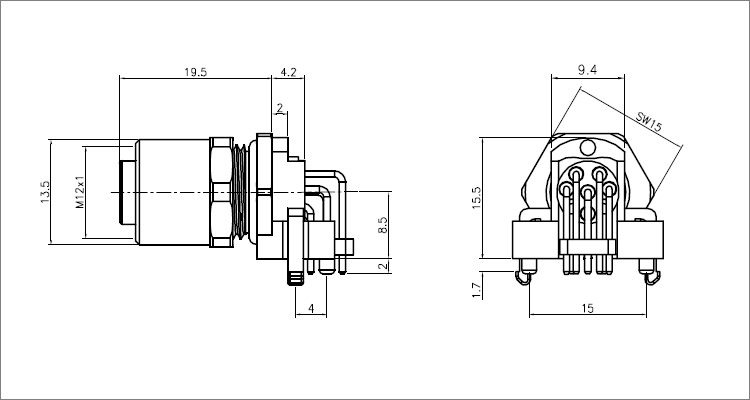
PCB/CCTV3_POE_REV100/Note/M12_8p_3d.jpg
