aiex718/CCTV3.0-F407/PCB/CCTV3_POE_REV100/Note/m12_eth_pinout.png

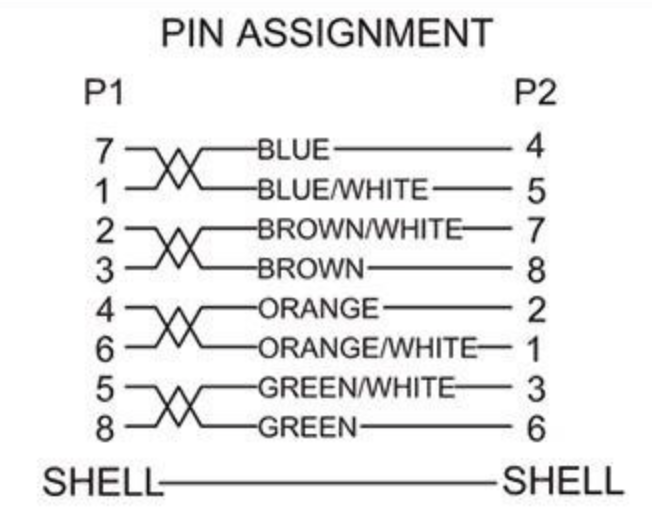
PCB/CCTV3_POE_REV100/Note/m12_eth_pinout.png
