aiex718/CCTV3.0-F407/PCB/CCTV3_F407_REV200/CCTV3_F407_REV200.pdf

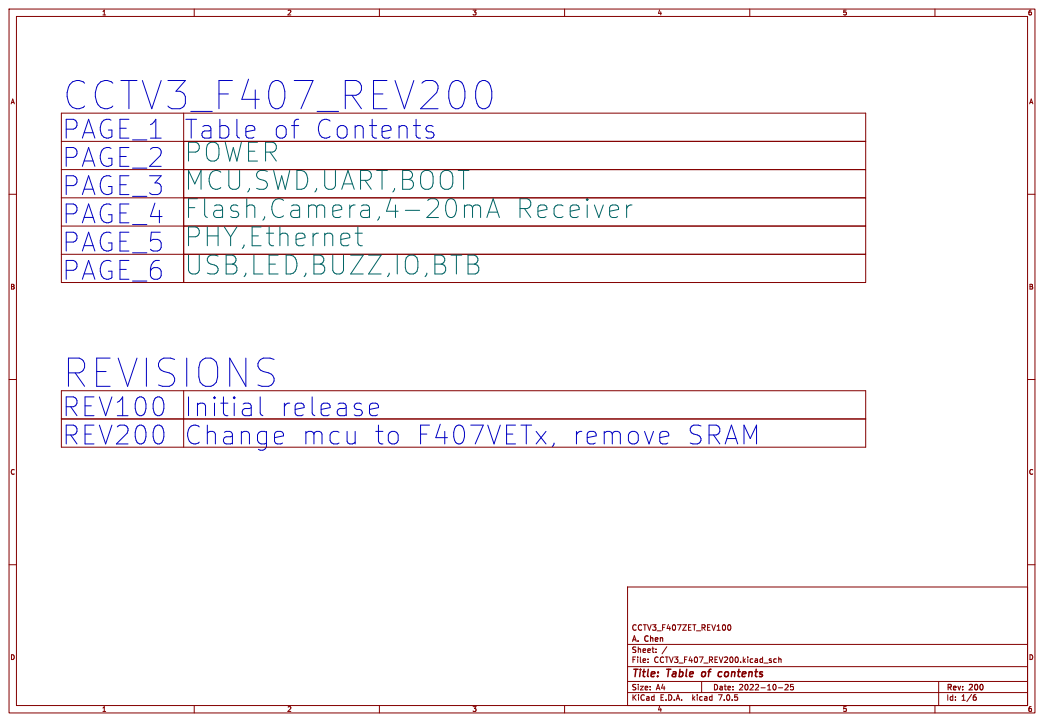
[picture p16: page 1]

PAGE_1
PAGE_2 | POWER
PAGE_3 | MCU,SWD,UART,BOOT
PAGE_4
PAGE_5
PAGE_6

PHY,Ethernet
USB,LED,BUZZ,IO,BTB

REV100
REV200

Id: 1/6 Title: Table of contents

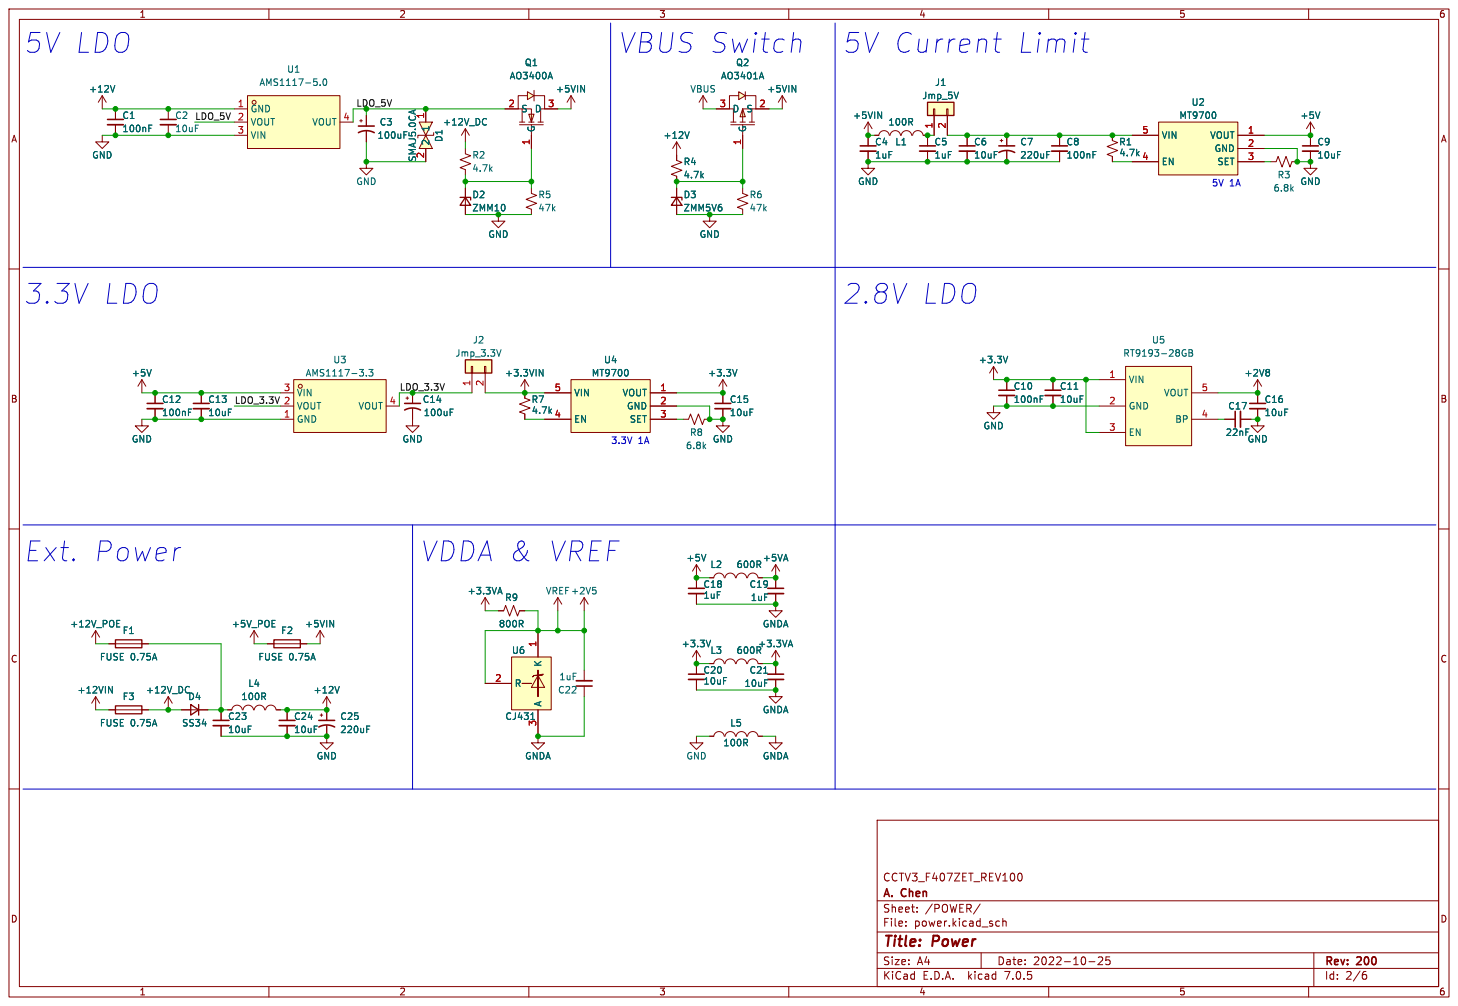
[picture p17: page 2]

Id: 2/6 Title: Power File: power.kicad_sch Sheet: /POWER/ A. Chen CCTV3_F407ZET_REV100

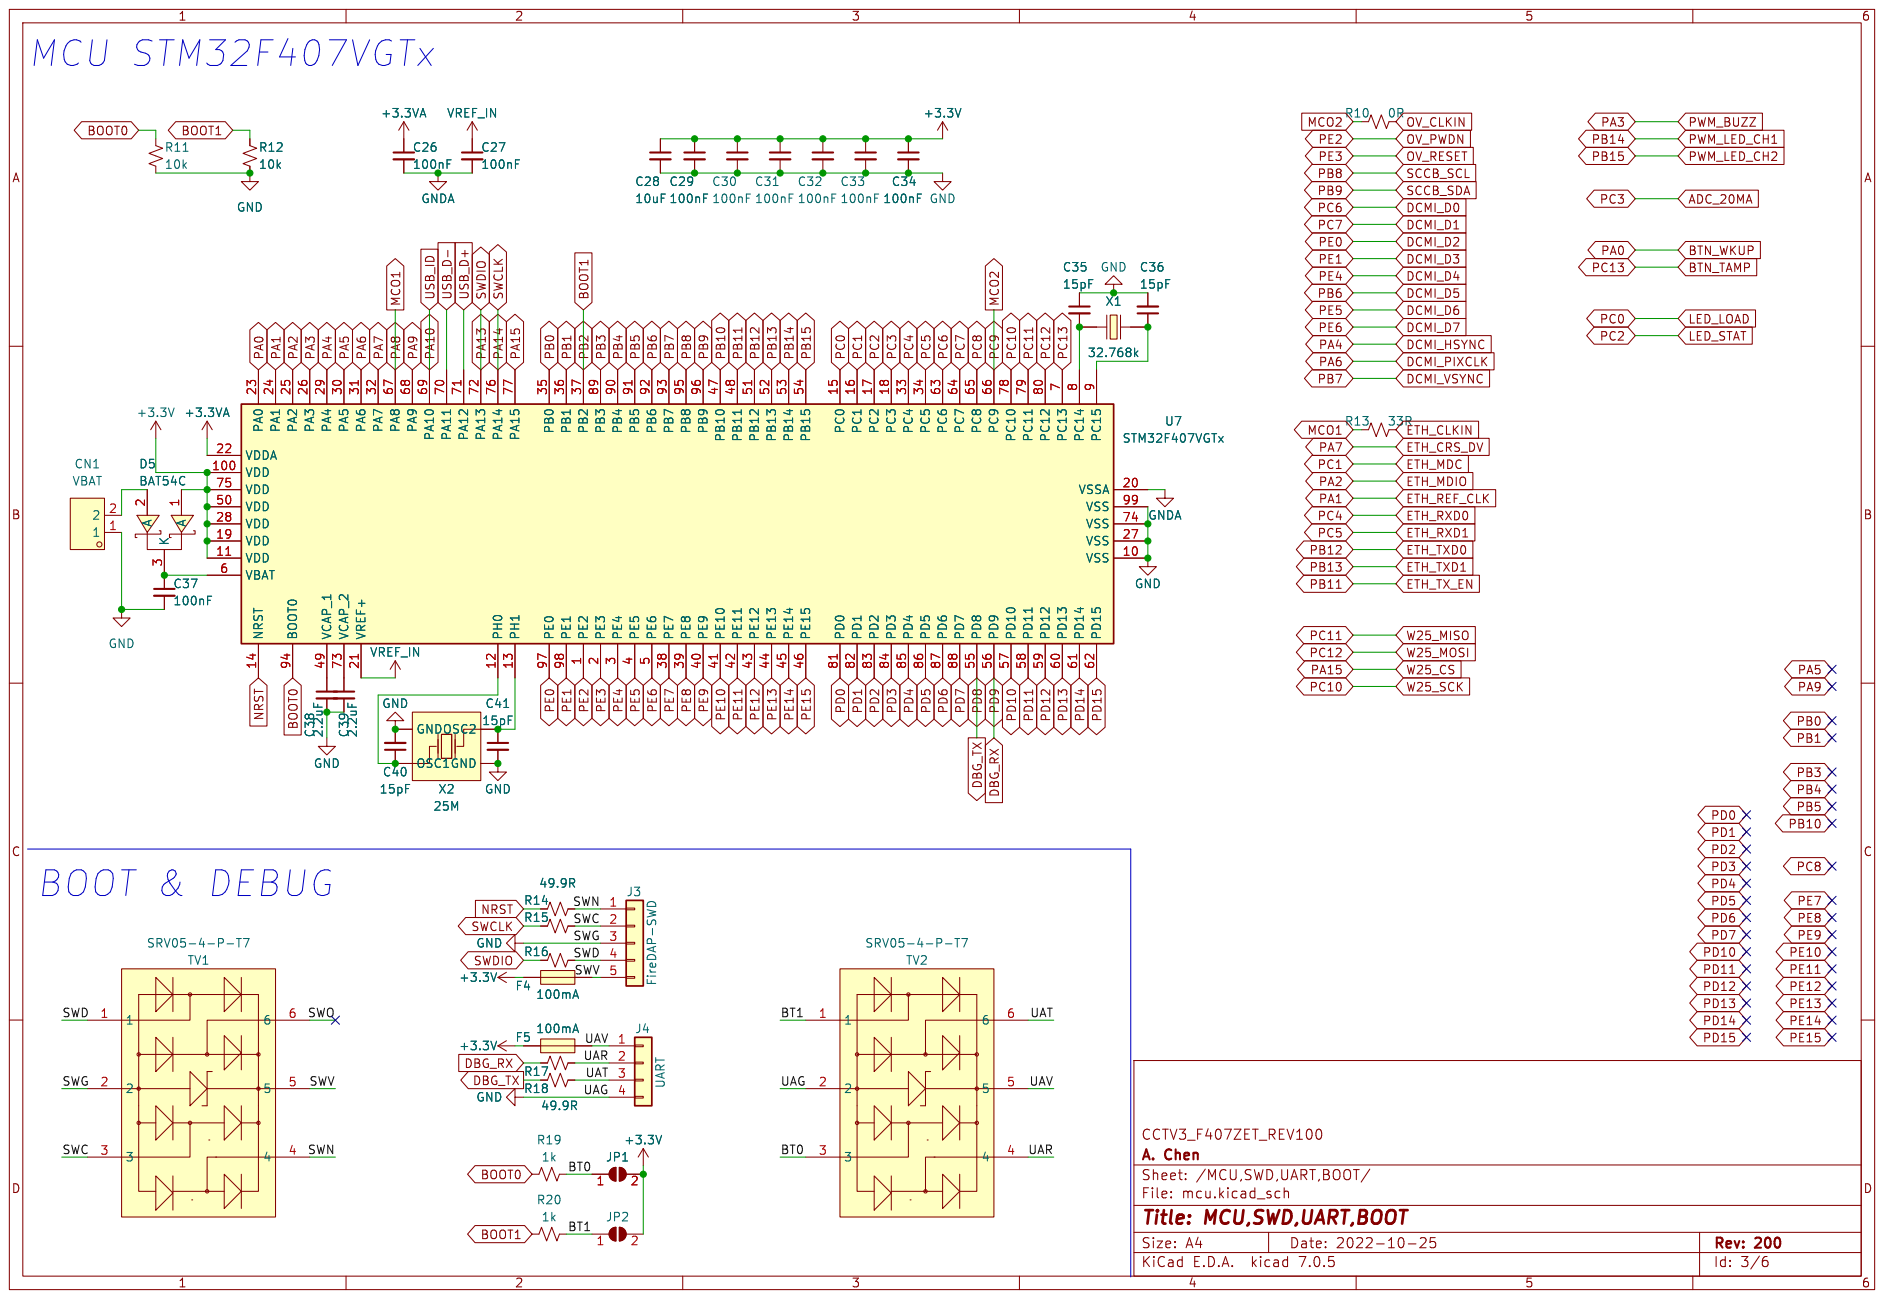
[picture p18: page 3]

1 VSS 10 VDD 100 VDD 11 PH0 12 PH1 13 NRST 14 PC0 15 PC1 16 PC2 17 PC3 18

2 VSSA 20 VREF+ 21 VDDA 22 PA0 23 PA1 24 PA2 25 PA3 26 VSS 27 VDD 28 PA4 29 PE4

File: mcu.kicad_sch Sheet: /MCU,SWD,UART,BOOT/ A. Chen CCTV3_F407ZET_REV100 C40

Id: 3/6 Title: MCU,SWD,UART,BOOT

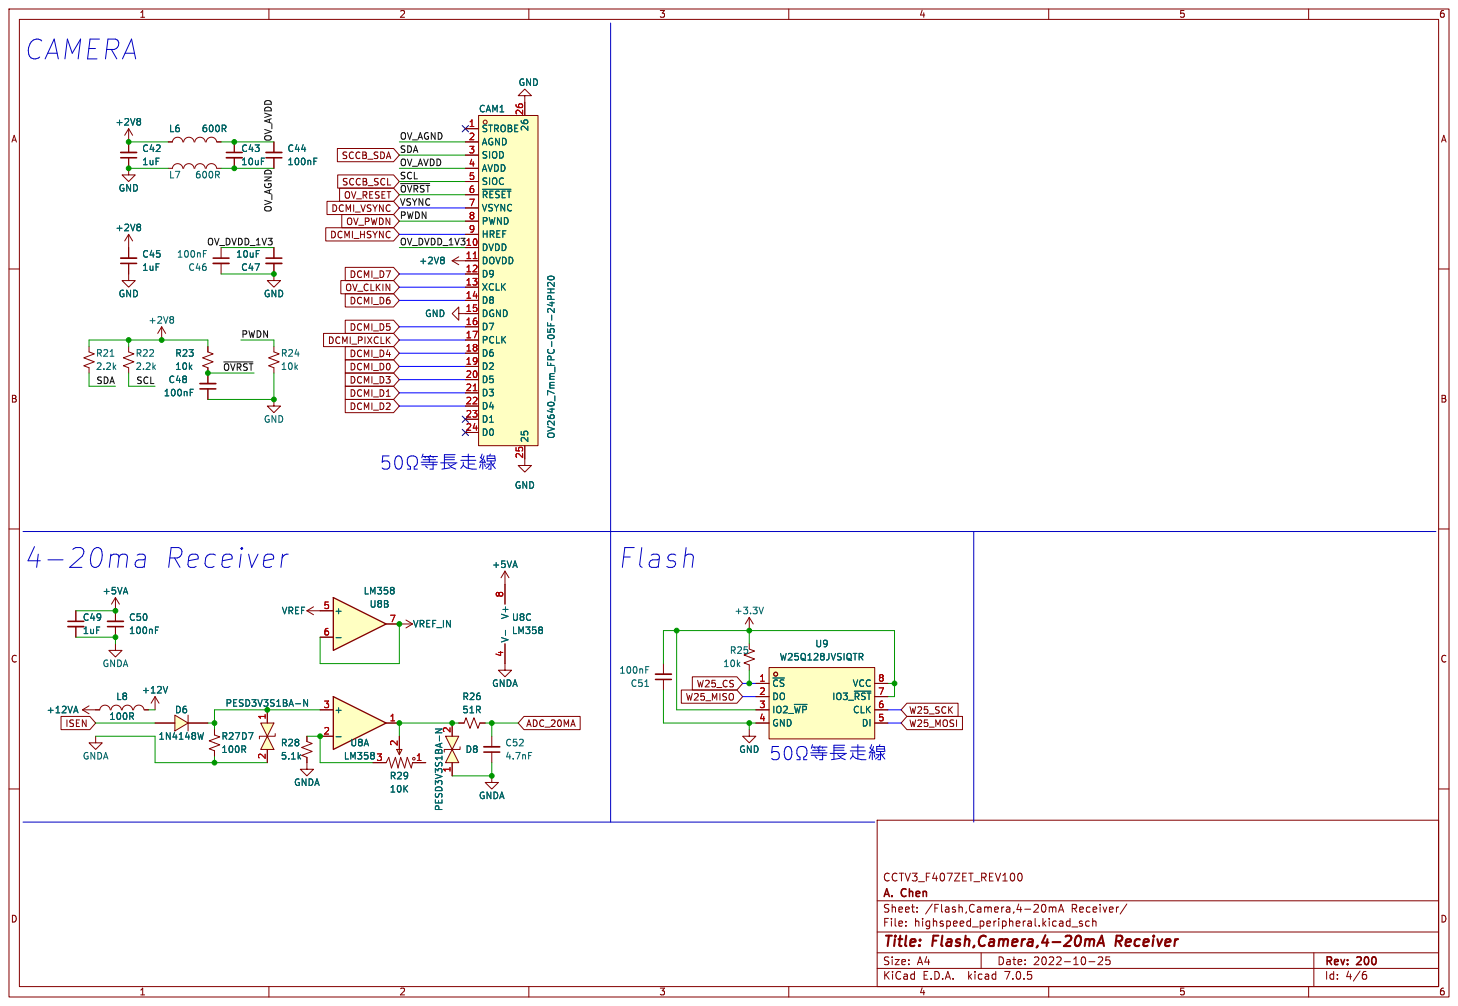
[picture p19: page 4]

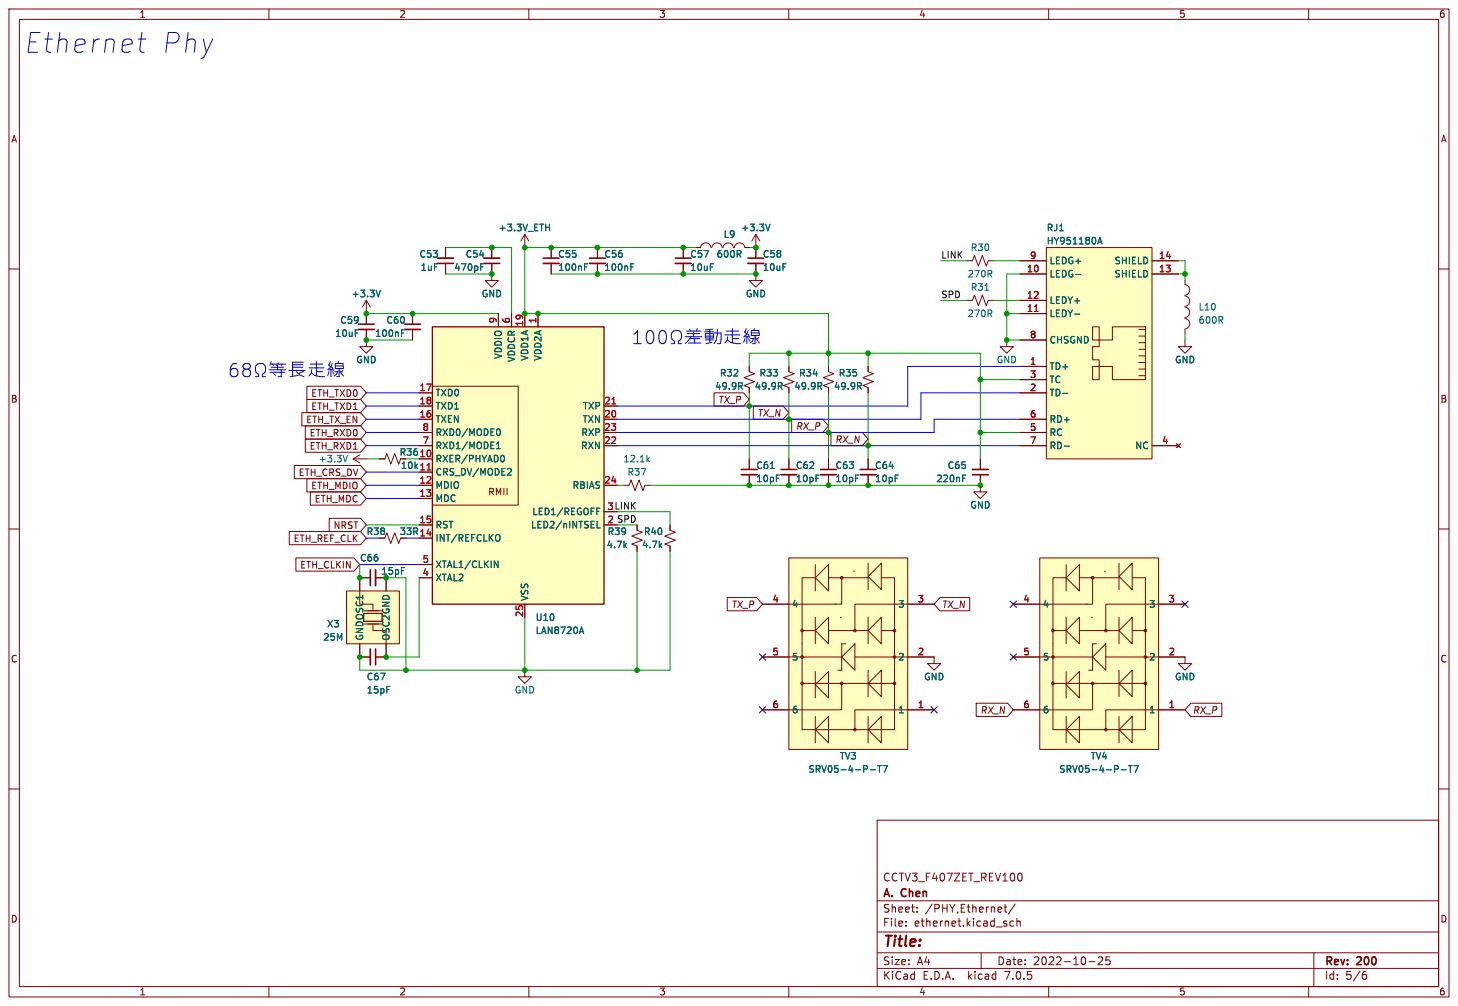
[picture p20: page 5]

Id: 5/6 Title: File: ethernet.kicad_sch Sheet: /PHY,Ethernet/ A. Chen CCTV3_F407ZET_REV100

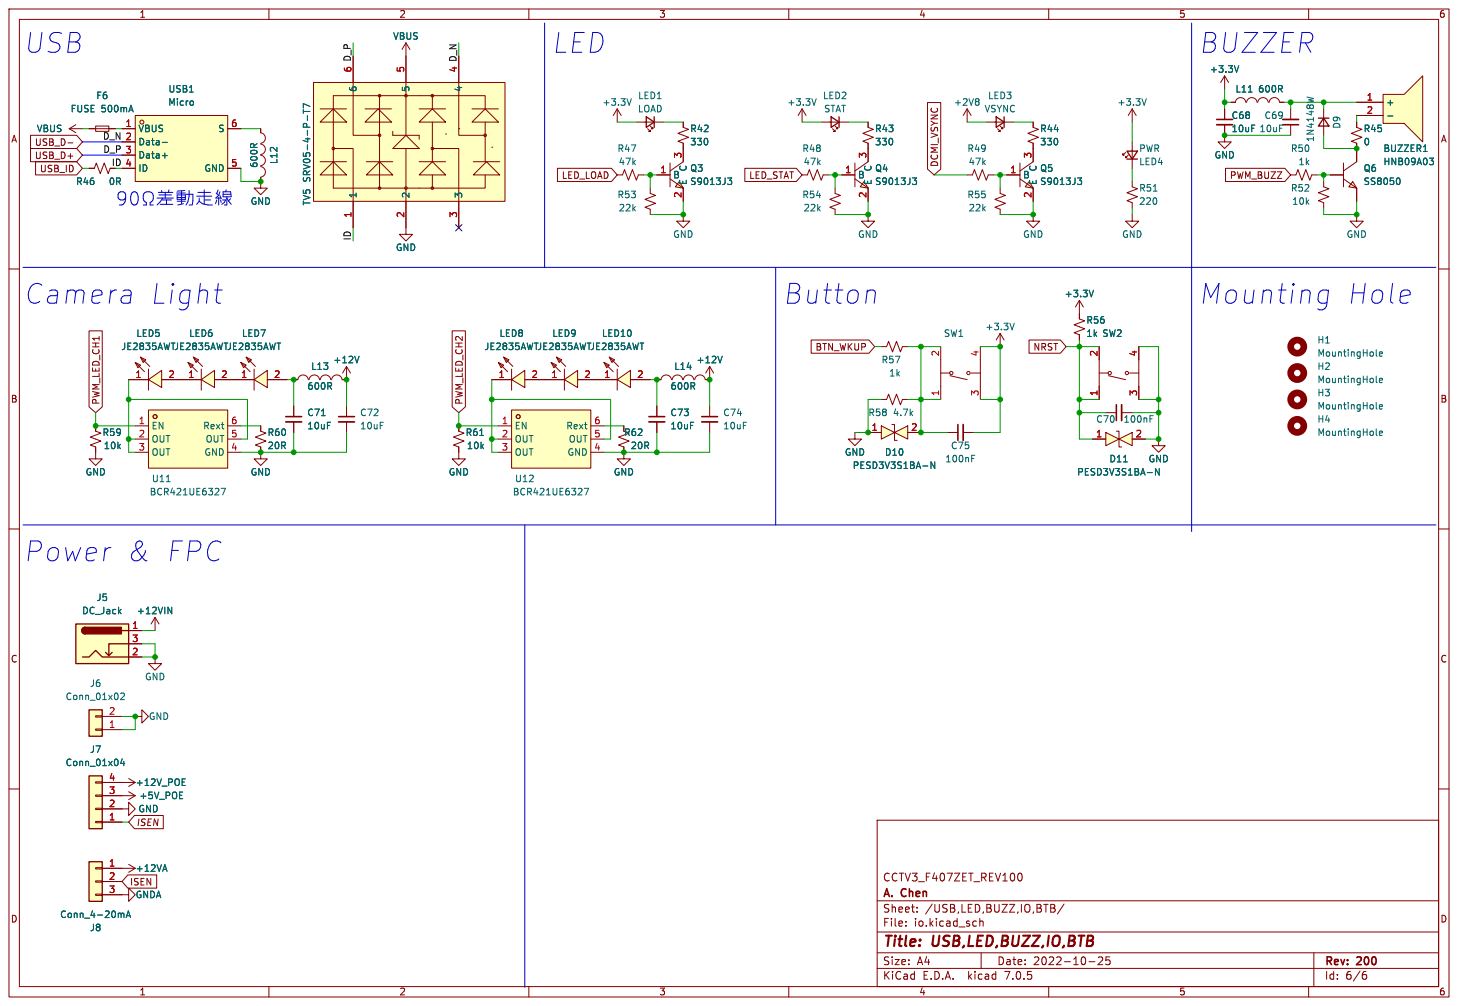
[picture p21: page 6]

File: io.kicad_sch Sheet: /USB,LED,BUZZ,IO,BTB/ A. Chen CCTV3_F407ZET_REV100

Id: 6/6 Title: USB,LED,BUZZ,IO,BTB
