aiex718/CCTV3.0-F407/PCB/CCTV3_POE_REV100/CCTV3_POE_REV100.pdf

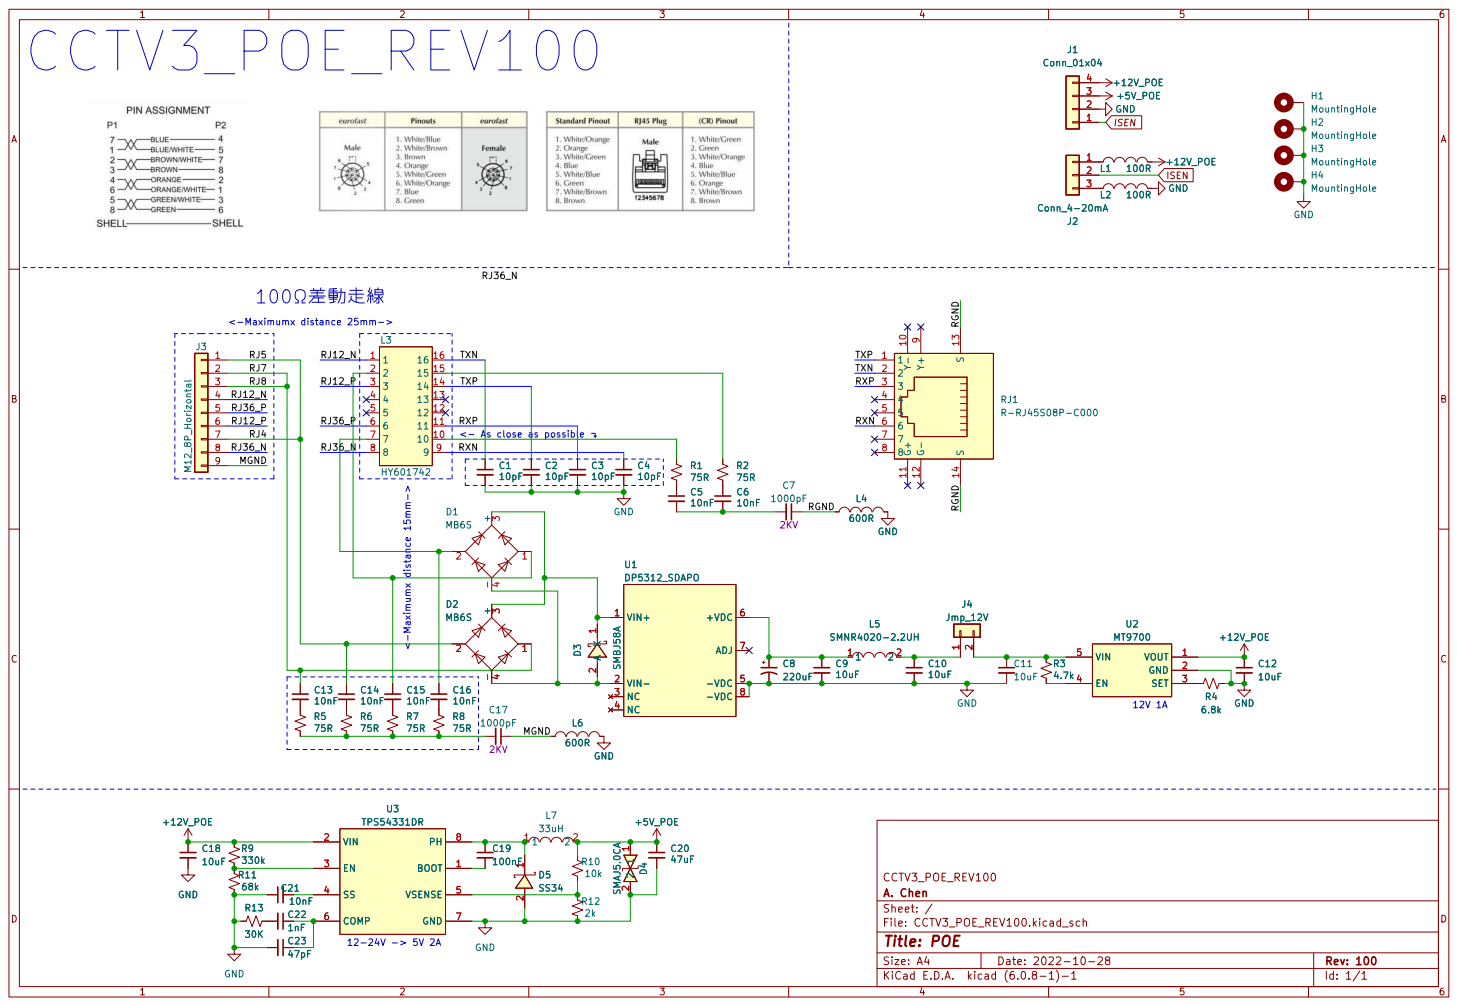
[picture p22: page 1]
