aiex718/CCTV3.0-F407/PCB/CCTV3_F407_REV200/CCTV3_F407_REV200.kicad_pcb

## KiCad design PCB/CCTV3_F407_REV200/CCTV3_F407_REV200.kicad_pcb (continued)

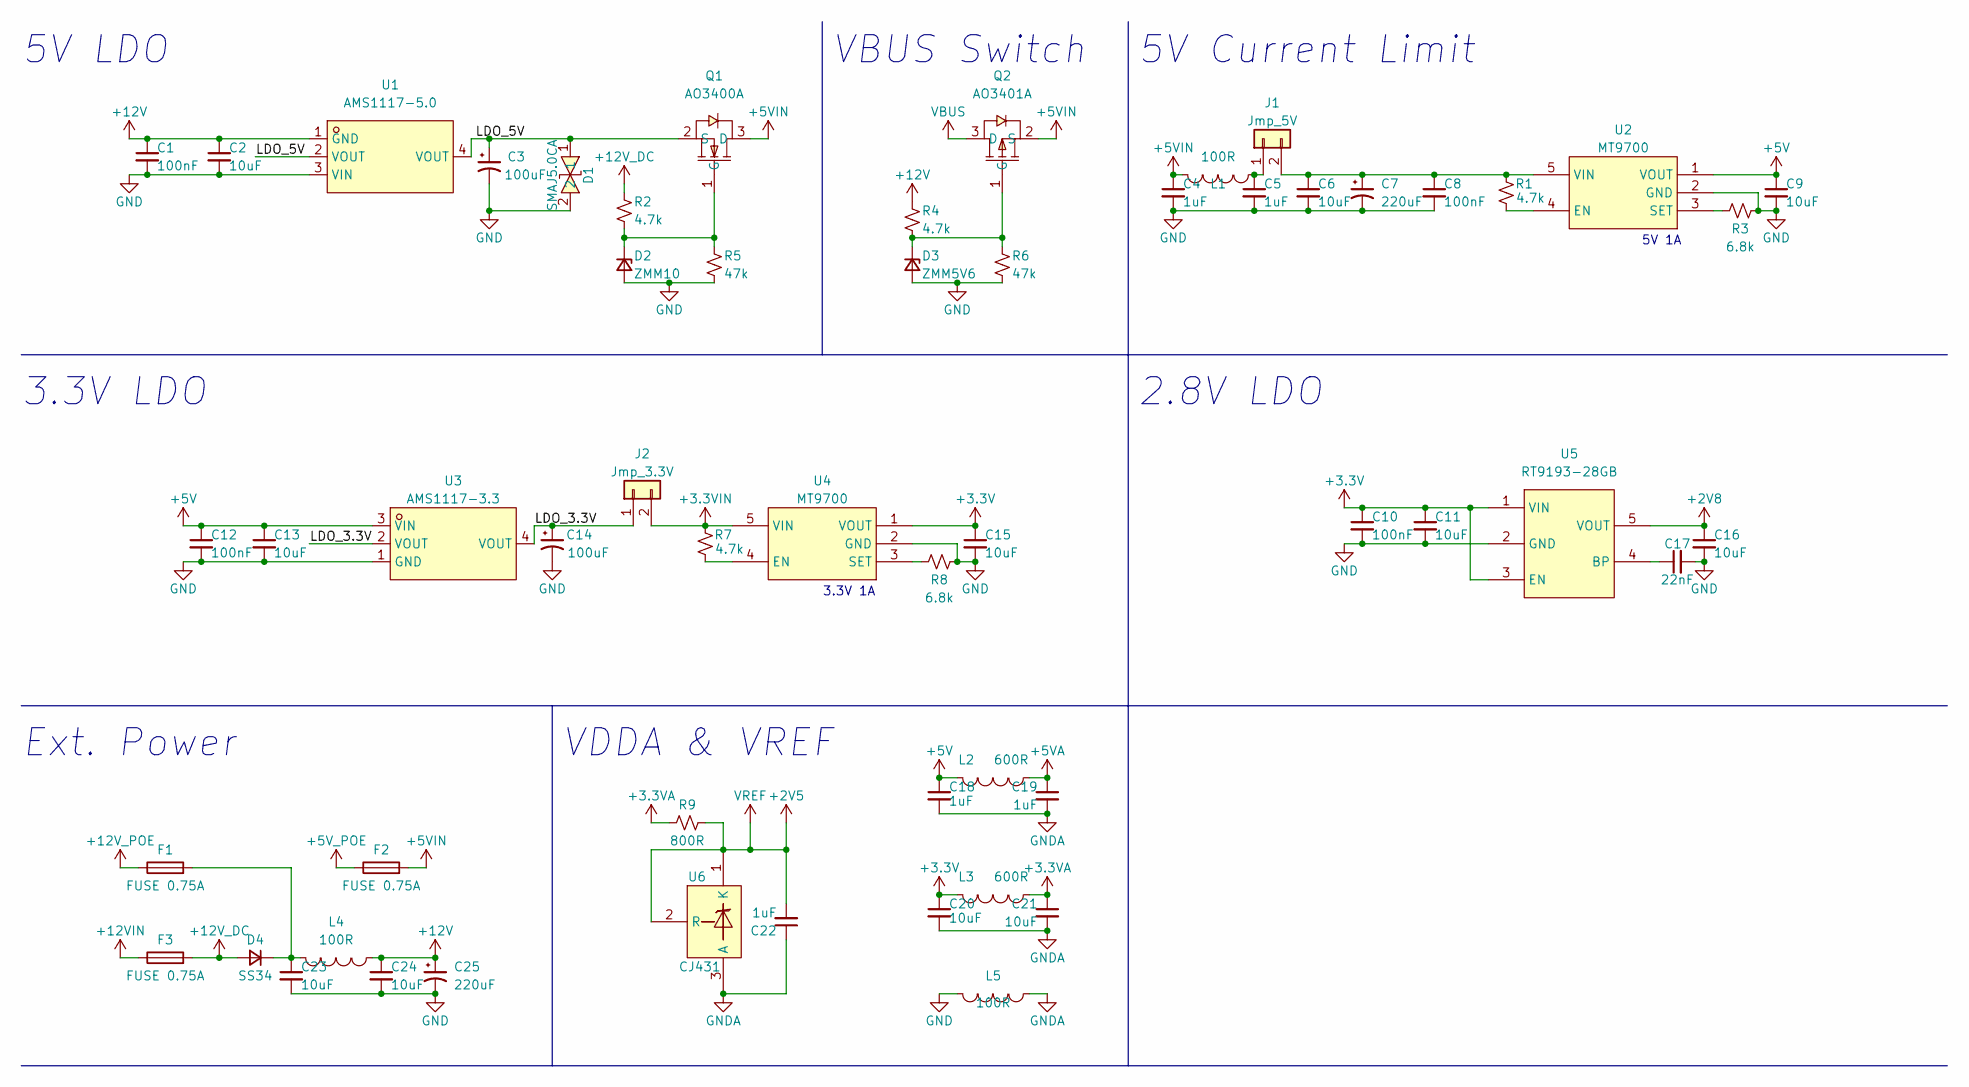
[picture p28: schematic power.kicad_sch]

Parts:
C1, C8, C12: 100nF; C_0603_1608Metric; Voltage 50V; LCSC Part TBD
C2, C6, C9, C13, C15: 10uF; C_0603_1608Metric; Voltage 25V; LCSC Part TBD
C3, C14: 100uF; CAP-SMD_L3.5-W2.8; Voltage 6.3V Tantalum; LCSC Part TBD
C4, C5: 1uF; C_0603_1608Metric; Voltage 25V; LCSC Part TBD
C7, C25: 220uF; CAP-SMD_BD6.3-L6.6-W6.6-LS7.2-R-RD; Voltage 25V; LCSC Part C371974
C10: 100nF; C_0402_1005Metric; Voltage 16V; LCSC Part TBD
C11, C16: 10uF; C_0402_1005Metric; Voltage 6.3V; LCSC Part TBD
C17: 22nF; C_0402_1005Metric; Voltage 50V; LCSC Part TBD
C18, C19: 1uF; C_0402_1005Metric; Voltage 50V; LCSC Part TBD
C20, C21: 10uF; C_0402_1005Metric; Voltage 50V; LCSC Part TBD
C22: 1uF; C_0603_1608Metric; Voltage 16V; LCSC Part TBD
C23, C24: 10uF; C_1206_3216Metric; Voltage 50V; LCSC Part TBD
D1: SMAJ5.0CA; D_SMA; LCSC Part C83324
D2: ZMM10; LL-34_L3.5-W1.5-RD; LCSC Part C707201
D3: ZMM5V6; LL-34_L3.5-W1.5-RD; LCSC Part C8062
D4: SS34; D_SMA; LCSC Part C8678
F1, F2, F3: FUSE 0.75A; Fuse_1812_4532Metric; Voltage 33V
J1: Jmp_5V; PinHeader_2x01_P2.54mm_Vertical
J2: Jmp_3.3V; PinHeader_2x01_P2.54mm_Vertical
L1, L4, L5: 100R; L_0805_2012Metric; LCSC Part C1015
L2, L3: 600R; L_0603_1608Metric; LCSC Part C1002
Q1: AO3400A; SOT-23-3_L2.9-W1.6-P1.90-LS2.8-BR; LCSC Part C20917
Q2: AO3401A; SOT-23_L2.9-W1.3-P1.90-LS2.4-BR; LCSC Part C15127
R1, R7: 4.7k; R_0402_1005Metric; LCSC Part TBD
R2, R4: 4.7k; R_0603_1608Metric; LCSC Part TBD
R3, R8: 6.8k; R_0402_1005Metric; LCSC Part TBD
R5, R6: 47k; R_0603_1608Metric; LCSC Part TBD
R9: 800R; R_0603_1608Metric; LCSC Part TBD
U1: AMS1117-5.0; SOT-223_L6.5-W3.5-P2.30-LS7.0-BR; LCSC Part C6187
U2, U4: MT9700; SOT-23-5_L3.0-W1.7-P0.95-LS2.8-BR; LCSC Part C89855
U3: AMS1117-3.3; SOT-223-3_L6.5-W3.4-P2.30-LS7.0-BR; LCSC Part C6186
U5: RT9193-28GB; SOT-23-5_L3.0-W1.7-P0.95-LS2.8-BR; LCSC Part C56731
U6: CJ431; SOT-23-3_L2.9-W1.6-P1.90-LS2.8-BR; LCSC Part C3113

Connections:
+2V5: C22.2, R9.1, U6.1 (K), U6.2 (R); also elsewhere on the board
+2V8: C16.1, U5.5 (VOUT); also elsewhere on the board
+3.3V: C10.1, C11.1, C15.1, C20.1, L3.1, U4.1 (VOUT), U5.1 (VIN), U5.3 (EN); also elsewhere on the board
+3.3VA: C21.1, L3.2, R9.2; also elsewhere on the board
+3.3VIN: J2.2, R7.1, U4.5 (VIN)
+5V: C9.1, C12.1, C13.1, C18.1, L2.1, U2.1 (VOUT), U3.3 (VIN)
+5VA: C19.1, L2.2; also elsewhere on the board
+5VIN: C4.1, F2.2, L1.1, Q1.3 (D), Q2.2 (S)
+5V_POE: F2.1; also elsewhere on the board
+12V: C1.1, C2.1, C24.1, C25.1, L4.2, R4.2, U1.1 (GND); also elsewhere on the board
+12VIN: F3.1; also elsewhere on the board
+12V_DC: D4.2 (A), F3.2, R2.2
+12V_POE: F1.1; also elsewhere on the board
/POWER/LDO_3.3V: C14.1, J2.1, U3.2 (VOUT), U3.4 (VOUT)
/POWER/LDO_5V: C3.1, D1.1, Q1.2 (S), U1.2 (VOUT), U1.4 (VOUT)
GND: C1.2, C2.2, C3.2, C4.2, C5.2, C6.2, C7.2, C8.2, C9.2, C10.2, C11.2, C12.2, C13.2, C14.2, C15.2, C16.2, C17.2, C23.2, C24.2, C25.2, D1.2, D2.2 (A), D3.2 (A), L5.1, R3.2, R5.1, R6.1, R8.2, U1.3 (VIN), U2.2 (GND), U3.1 (GND), U4.2 (GND), U5.2 (GND); also elsewhere on the board
GNDA: C18.2, C19.2, C20.2, C21.2, C22.1, L5.2, U6.3 (A); also elsewhere on the board
unnamed: C5.1, J1.1, L1.2
unnamed: C6.1, C7.1, C8.1, J1.2, R1.1, U2.5 (VIN)
unnamed: C17.1, U5.4 (BP)
unnamed: C23.1, D4.1 (K), F1.2, L4.1
unnamed: D2.1 (K), Q1.1 (G), R2.1, R5.2
unnamed: D3.1 (K), Q2.1 (G), R4.1, R6.2
unnamed: R1.2, U2.4 (EN)
unnamed: R3.1, U2.3 (SET)
unnamed: R7.2, U4.4 (EN)
unnamed: R8.1, U4.3 (SET)
VBUS: Q2.3 (D); also elsewhere on the board

Notes on the sheet:
5V Current Limit
2.8V LDO
3.3V 1A
5V LDO
VBUS Switch
VDDA & VREF
3.3V LDO
Ext. Power
5V 1A

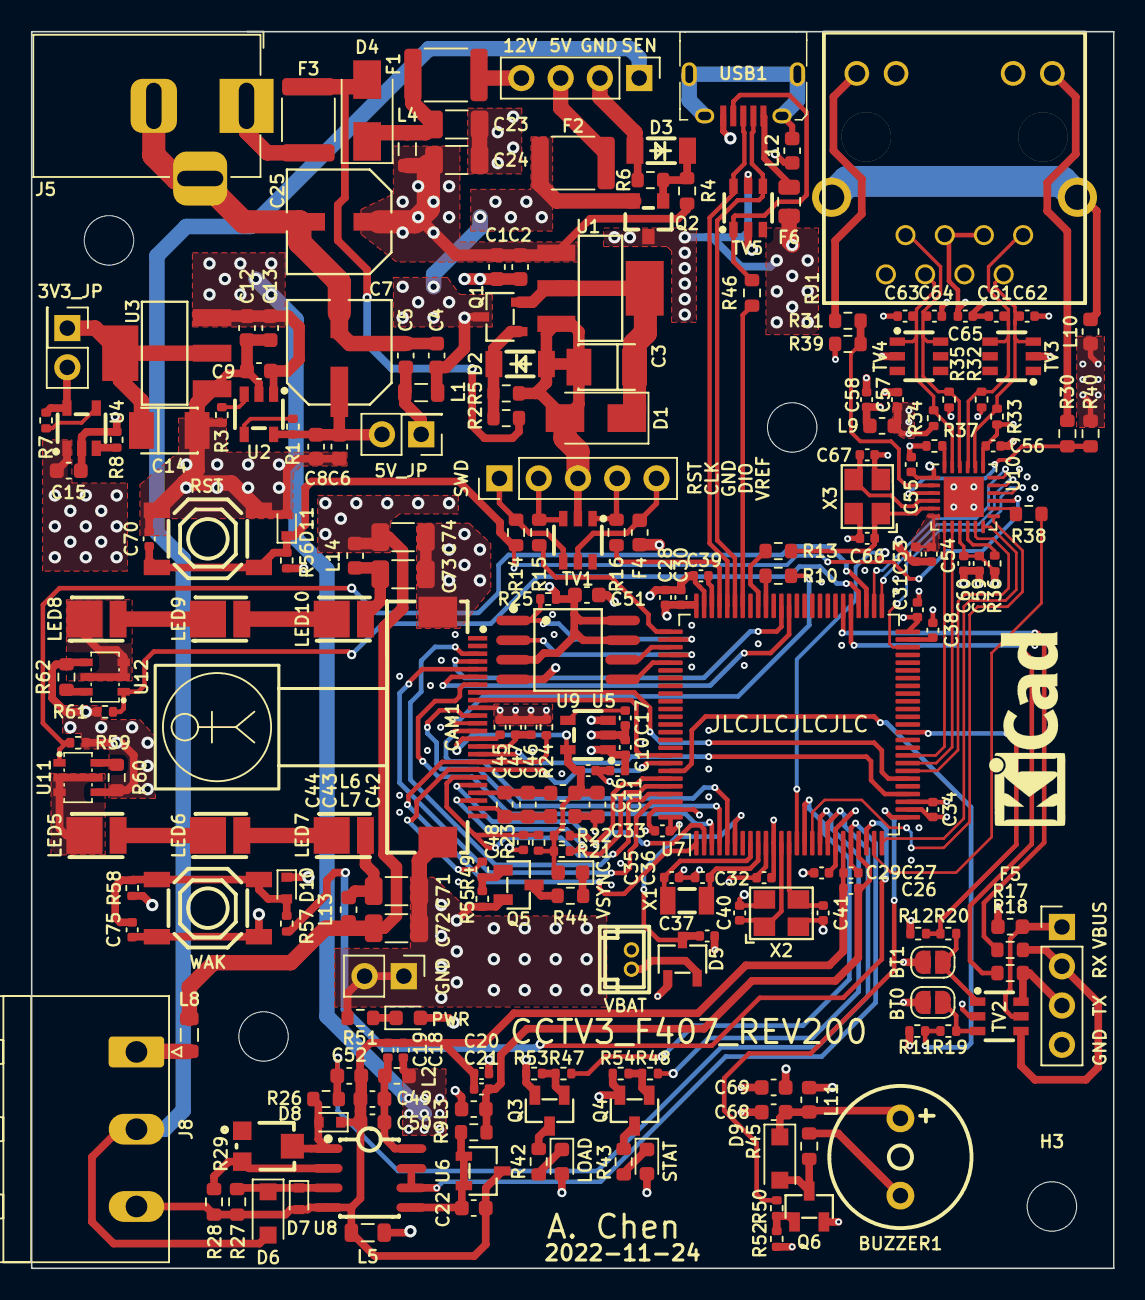
[picture p29: board CCTV3_F407_REV200.kicad_pcb from above]

Board: 4 copper layers, 70.0 x 80.0 mm, 224 parts (0 on the bottom side), 146 nets.
