aiex718/CCTV3.0-F407/PCB/CCTV3_F407_REV100/CCTV3_F407_REV100.kicad_pcb

## KiCad design PCB/CCTV3_F407_REV100/CCTV3_F407_REV100.kicad_pcb (2023-03-06, an earlier design)

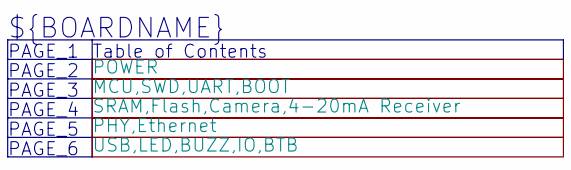
[picture p30: schematic CCTV3_F407_REV100.kicad_sch, Table of contents]

Notes on the sheet:
PAGE_5
PAGE_1
PAGE_2
PAGE_3
${BOARDNAME}
Table of Contents
PAGE_6
PAGE_4

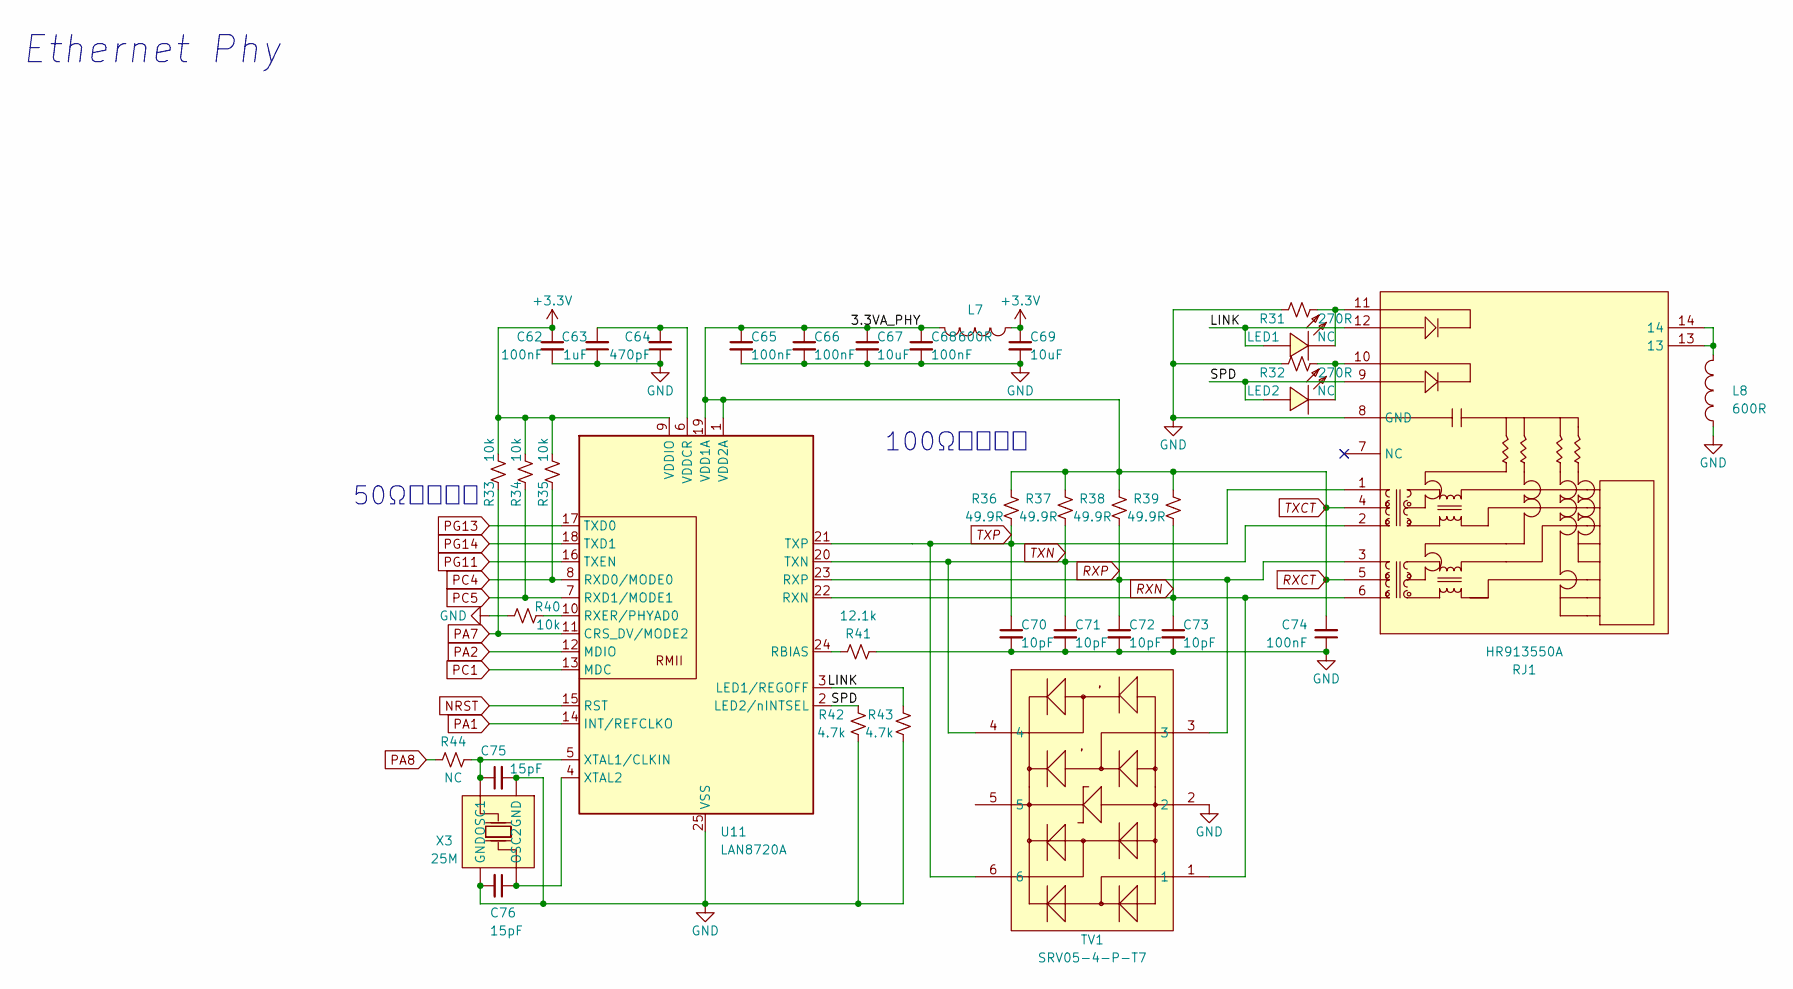
[picture p31: schematic ethernet.kicad_sch]

Parts:
C62, C65, C66, C68, C74: 100nF; C0603; Voltage 50V; LCSC Part TBD
C63: 1uF; C0603; Voltage 50V; LCSC Part TBD
C64: 470pF; C0603; Voltage 50V; LCSC Part TBD
C67, C69: 10uF; C0603; Voltage 25V; LCSC Part TBD
C70, C71, C72, C73: 10pF; C0603; Voltage 50V; LCSC Part TBD
C75, C76: 15pF; C0603; Voltage 50V; LCSC Part TBD
L7, L8: 600R; L0603; LCSC Part C1002
LED1, LED2: NC; LED0603-R-RD_WHITE
R31, R32: 270R; R0603; LCSC Part TBD
R33, R34, R35, R40: 10k; R0603; Tolerance 1%; LCSC Part TBD
R36, R37, R38, R39: 49.9R; R0603; LCSC Part TBD
R41: 12.1k; R0603; Tolerance 1%; LCSC Part TBD
R42, R43: 4.7k; R0603; LCSC Part TBD
R44: NC; R0603; LCSC Part TBD
RJ1: HR913550A; RJ45-TH_HR913550A; LCSC Part C163507
TV1: SRV05-4-P-T7; SOT-23-6_L2.9-W1.6-P0.95-LS2.8-BR; LCSC Part C85364
U11: LAN8720A; QFN-24-1EP_4x4mm_P0.5mm_EP2.6x2.6mm
X3: 25M; OSC-SMD_4P-L3.2-W2.5-BL; LCSC Part C9006

Connections:
+3.3V: C62.1, C69.1, L7.2, R33.1, R34.1, R35.1, U11.9 (VDDIO); also elsewhere on the board
/PHY,Ethernet/LINK: LED1.1 (A), R43.2, RJ1.12, U11.3 (LED1/REGOFF)
/PHY,Ethernet/SPD: LED2.1 (A), R42.2, RJ1.9, U11.2 (LED2/nINTSEL)
GND: C62.2, C63.1, C64.1, C65.2, C66.2, C67.2, C68.2, C69.2, C70.2, C71.2, C72.2, C73.2, C74.1, C75.2, C76.2, L8.2, R31.2, R32.2, R40.2, R41.1, R42.1, R43.1, RJ1.8 (GND), TV1.2, U11.25 (VSS), X3.2 (GND), X3.4 (GND); also elsewhere on the board
MCO1: R44.1; also elsewhere on the board
NRST: U11.15 (RST); also elsewhere on the board
unnamed: C63.2, C64.2, U11.6 (VDDCR)
unnamed: C75.1, R44.2, U11.5 (XTAL1/CLKIN), X3.1 (OSC1)
unnamed: C76.1, U11.4 (XTAL2), X3.3 (OSC2)
unnamed: L8.1, RJ1.13, RJ1.14
unnamed: LED1.2 (K), R31.1, RJ1.11
unnamed: LED2.2 (K), R32.1, RJ1.10
unnamed: R40.1, U11.10 (RXER/PHYAD0)
unnamed: R41.2, U11.24 (RBIAS)
PA1: U11.14 (INT/REFCLKO); also elsewhere on the board
PA2: U11.12 (MDIO); also elsewhere on the board
PA7: R33.2, U11.11 (CRS_DV/MODE2); also elsewhere on the board
PC1: U11.13 (MDC); also elsewhere on the board
PC4: R35.2, U11.8 (RXD0/MODE0); also elsewhere on the board
PC5: R34.2, U11.7 (RXD1/MODE1); also elsewhere on the board
PG11: U11.16 (TXEN); also elsewhere on the board
PG13: U11.17 (TXD0); also elsewhere on the board
PG14: U11.18 (TXD1); also elsewhere on the board
RXCT: C65.1, C66.1, C67.1, C68.1, C74.2, L7.1, R36.1, R37.1, R38.1, R39.1, RJ1.4, RJ1.5, U11.1 (VDD2A), U11.19 (VDD1A); also elsewhere on the board
RXN: C73.1, R39.2, RJ1.6, TV1.1, U11.22 (RXN); also elsewhere on the board
RXP: C72.1, R38.2, RJ1.3, TV1.3, U11.23 (RXP); also elsewhere on the board
TXN: C71.1, R37.2, RJ1.2, TV1.4, U11.20 (TXN); also elsewhere on the board
TXP: C70.1, R36.2, RJ1.1, TV1.6, U11.21 (TXP); also elsewhere on the board

Notes on the sheet:
Ethernet Phy
100Ω差動走線
50Ω等長走線

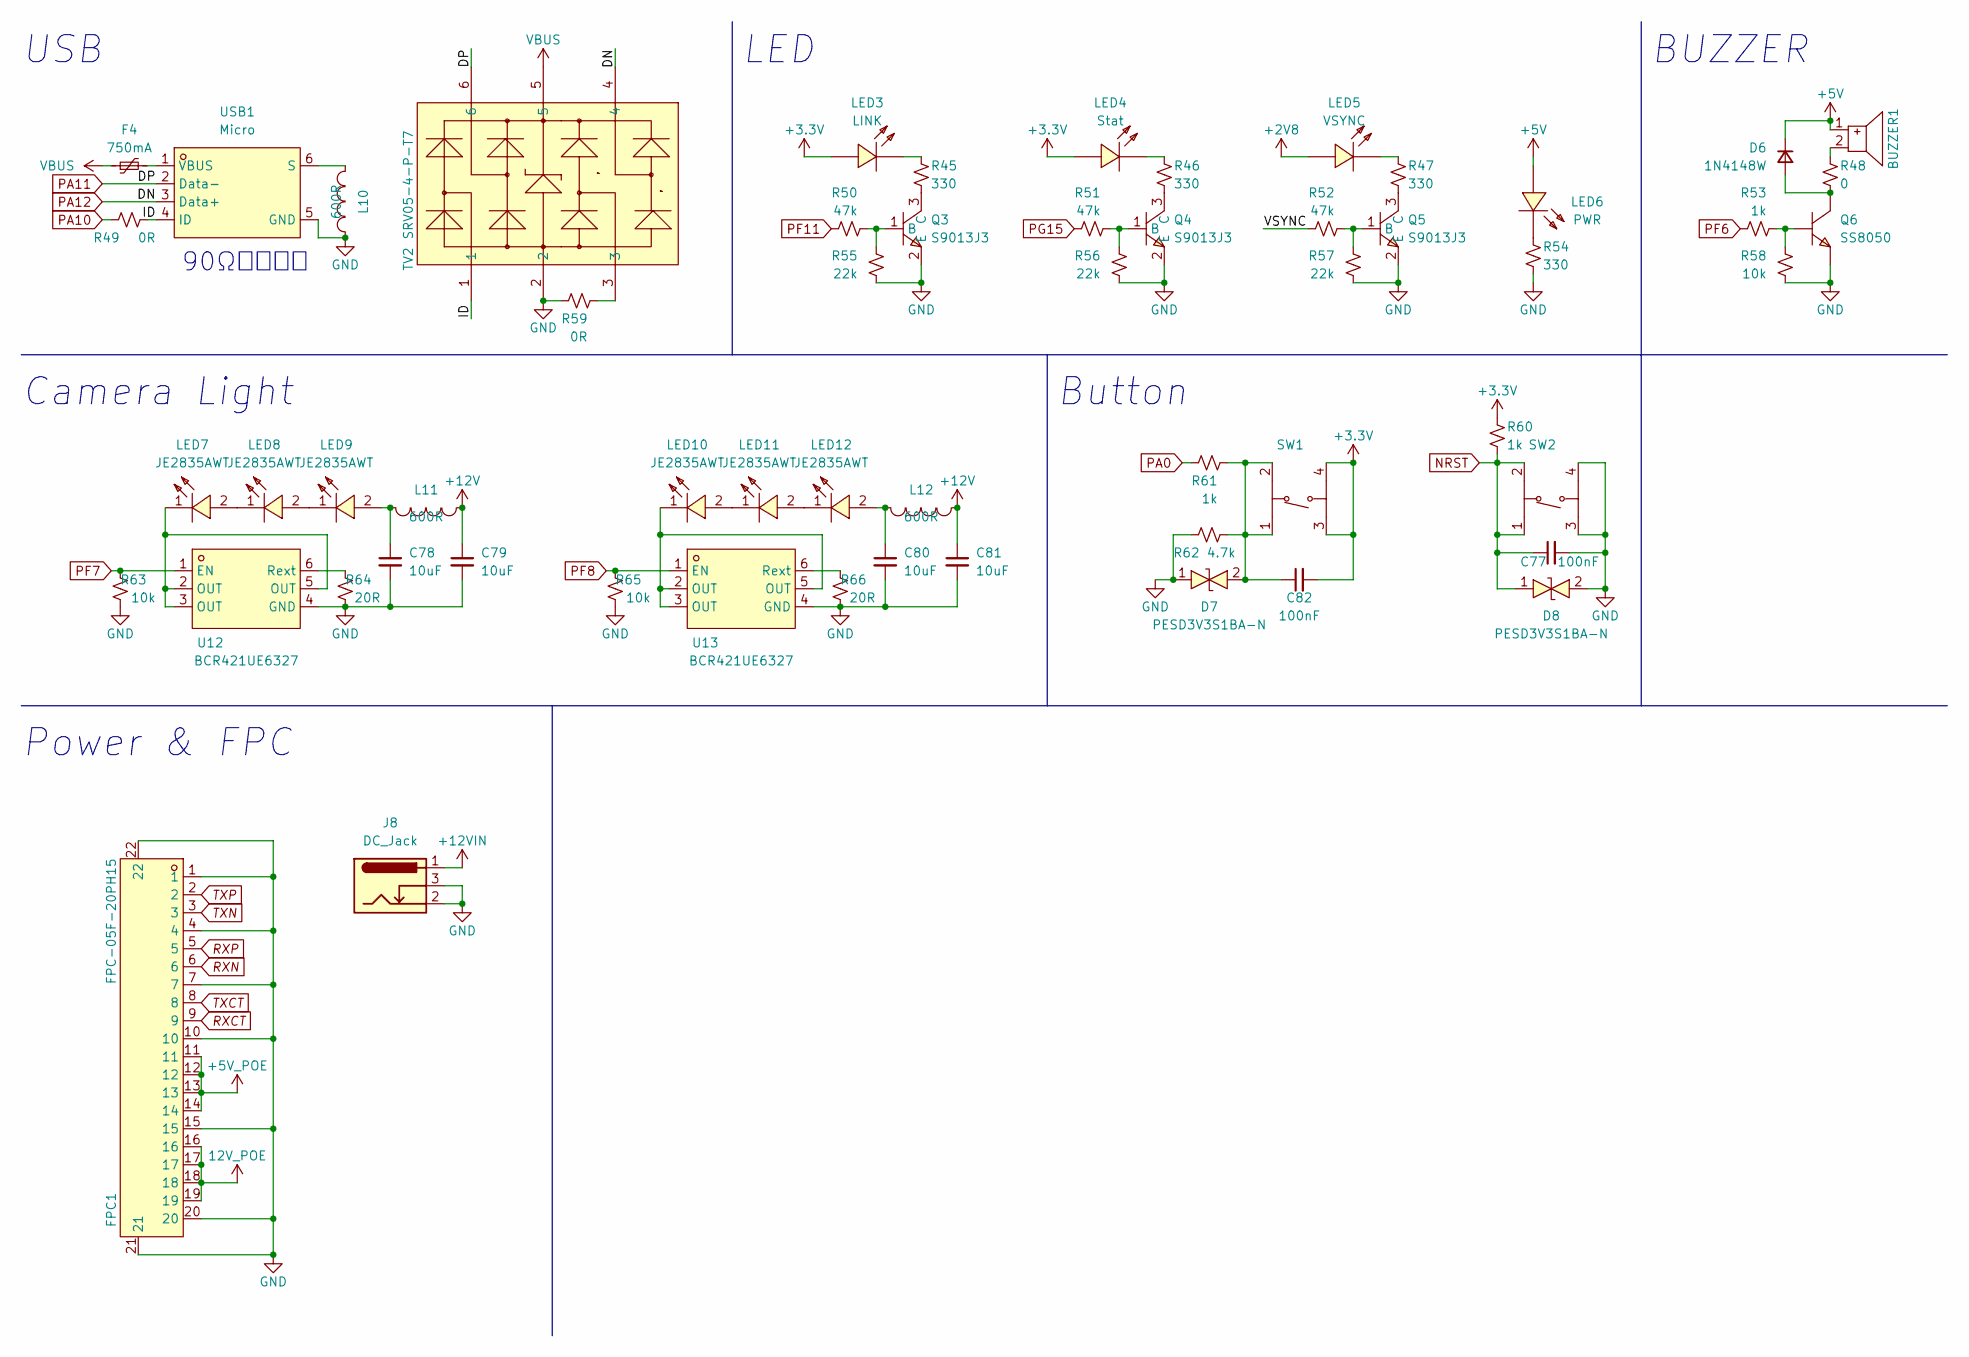
[picture p32: schematic io.kicad_sch, USB,LED,BUZZ,IO,BTB]

Parts:
BUZZER1: HNB09A05; BUZ-TH_BD9.6-P5.00-D0.7-FD; LCSC Part C96493
C77, C82: 100nF; C0603; Voltage 50V; LCSC Part TBD
C78, C79, C80, C81: 10uF; C1206; Voltage 50V; LCSC Part TBD
D6: 1N4148W; SOD-123F_L2.7-W1.6-LS3.8-RD; LCSC Part C81598
D7, D8: PESD3V3S1BA-N; SOD-523_L1.2-W0.8-LS1.6-BI; LCSC Part C316037
F4: 750mA; F1812; LCSC Part C151170
FPC1: FPC-05F-20PH15; FPC-SMD_20P-P0.50_XUNPU_FPC-05F-20PH15; LCSC Part C2856820
J8: DC_Jack; BarrelJack_Horizontal
L10, L11, L12: 600R; L0603; LCSC Part C1002
LED3, LED4, LED5, LED6: 0603; LED0603-R-RD_WHITE; LCSC Part TBD
LED7, LED8, LED9, LED10, LED11, LED12: JE2835AWT; LED-SMD_L3.3-W2.8-RD; LCSC Part TBD
Q3, Q4, Q5: S9013J3; SOT-23-3_L2.9-W1.3-P1.90-LS2.4-BR; LCSC Part C6749
Q6: SS8050; SOT-23-3_L2.9-W1.3-P1.90-LS2.4-BR; LCSC Part C2150
R45, R46, R47, R54: 330; R0603; LCSC Part TBD
R48: 0; R0603; LCSC Part TBD
R49, R59: 0R; R0603; LCSC Part TBD
R50, R51, R52: 47k; R0603; LCSC Part TBD
R53, R60, R61: 1k; R0603; LCSC Part TBD
R55, R56, R57: 22k; R0603; LCSC Part TBD
R58, R63, R65: 10k; R0603; LCSC Part TBD
R62: 4.7k; R0603; LCSC Part TBD
R64, R66: 20R; R0603; Tolerance 1%; LCSC Part TBD
SW1, SW2: BTN-TS-1187A-B-A-B; SW-SMD_4P-L5.1-W5.1-P3.70-LS6.5-TL-2; LCSC Part C318884
TV2: SRV05-4-P-T7; SOT-23-6_L2.9-W1.6-P0.95-LS2.8-BR; LCSC Part C85364
U12, U13: BCR421UE6327; SC-74-6_L2.9-W1.6-P0.95-LS2.5-BR; LCSC Part C112923
USB1: Micro; MICRO-USB-SMD_10118194-0001LF; LCSC Part C132563

Connections:
+2V8: LED5.1 (A); also elsewhere on the board
+3.3V: C82.2, LED3.1 (A), LED4.1 (A), R60.1, SW1.3 (C), SW1.4 (D); also elsewhere on the board
/USB,LED,BUZZ,IO,BTB/ID: R49.2, TV2.1, USB1.4 (ID)
/USB,LED,BUZZ,IO,BTB/VSYNC: R52.1
GND: C77.2, C78.2, C79.2, C80.2, C81.2, D7.1, D8.2, FPC1.1, FPC1.4, FPC1.7, FPC1.10, FPC1.15, FPC1.20, FPC1.21, FPC1.22, J8.2, J8.3, L10.2, Q3.2 (E), Q4.2 (E), Q5.2 (E), Q6.2 (E), R54.2, R55.1, R56.1, R57.1, R58.1, R59.1, R62.1, R63.1, R64.1, R65.1, R66.1, SW2.3 (C), SW2.4 (D), TV2.2, U12.4 (GND), U13.4 (GND), USB1.5 (GND); also elsewhere on the board
NRST: C77.1, D8.1, R60.2, SW2.1 (A), SW2.2 (B); also elsewhere on the board
unnamed: BUZZER1.2, R48.1
unnamed: C78.1, L11.1, LED9.2 (A)
unnamed: C80.1, L12.1, LED12.2 (A)
unnamed: C82.1, D7.2, R61.2, R62.2, SW1.1 (A), SW1.2 (B)
unnamed: D6.2 (A), Q6.3 (C), R48.2
unnamed: F4.2, USB1.1 (VBUS)
unnamed: L10.1, USB1.6 (S)
unnamed: LED3.2 (K), R45.1
unnamed: LED4.2 (K), R46.1
unnamed: LED5.2 (K), R47.1
unnamed: LED6.2 (K), R54.1
unnamed: LED7.1 (K), U12.2 (OUT), U12.3 (OUT), U12.5 (OUT)
unnamed: LED7.2 (A), LED8.1 (K)
unnamed: LED8.2 (A), LED9.1 (K)
unnamed: LED10.1 (K), U13.2 (OUT), U13.3 (OUT), U13.5 (OUT)
unnamed: LED10.2 (A), LED11.1 (K)
unnamed: LED11.2 (A), LED12.1 (K)
unnamed: Q3.1 (B), R50.2, R55.2
unnamed: Q3.3 (C), R45.2
unnamed: Q4.1 (B), R51.2, R56.2
unnamed: Q4.3 (C), R46.2
unnamed: Q5.1 (B), R52.2, R57.2
unnamed: Q5.3 (C), R47.2
unnamed: Q6.1 (B), R53.2, R58.2
unnamed: R59.2, TV2.3
unnamed: R64.2, U12.6 (Rext)
unnamed: R66.2, U13.6 (Rext)
PA0: R61.1; also elsewhere on the board
PA10: R49.1; also elsewhere on the board
PA11: TV2.6, USB1.2 (Data-); also elsewhere on the board
PA12: TV2.4, USB1.3 (Data+); also elsewhere on the board
PF6: R53.1; also elsewhere on the board
PF7: R63.2, U12.1 (EN); also elsewhere on the board
PF8: R65.2, U13.1 (EN); also elsewhere on the board
PF11: R50.1; also elsewhere on the board
PG15: R51.1; also elsewhere on the board
RXCT: FPC1.8, FPC1.9; also elsewhere on the board
RXN: FPC1.6; also elsewhere on the board
RXP: FPC1.5; also elsewhere on the board
TXN: FPC1.3; also elsewhere on the board
TXP: FPC1.2; also elsewhere on the board
VBUS: F4.1, TV2.5; also elsewhere on the board

Notes on the sheet:
90Ω差動走線
BUZZER
Button
Camera Light
Power & FPC
LED
USB

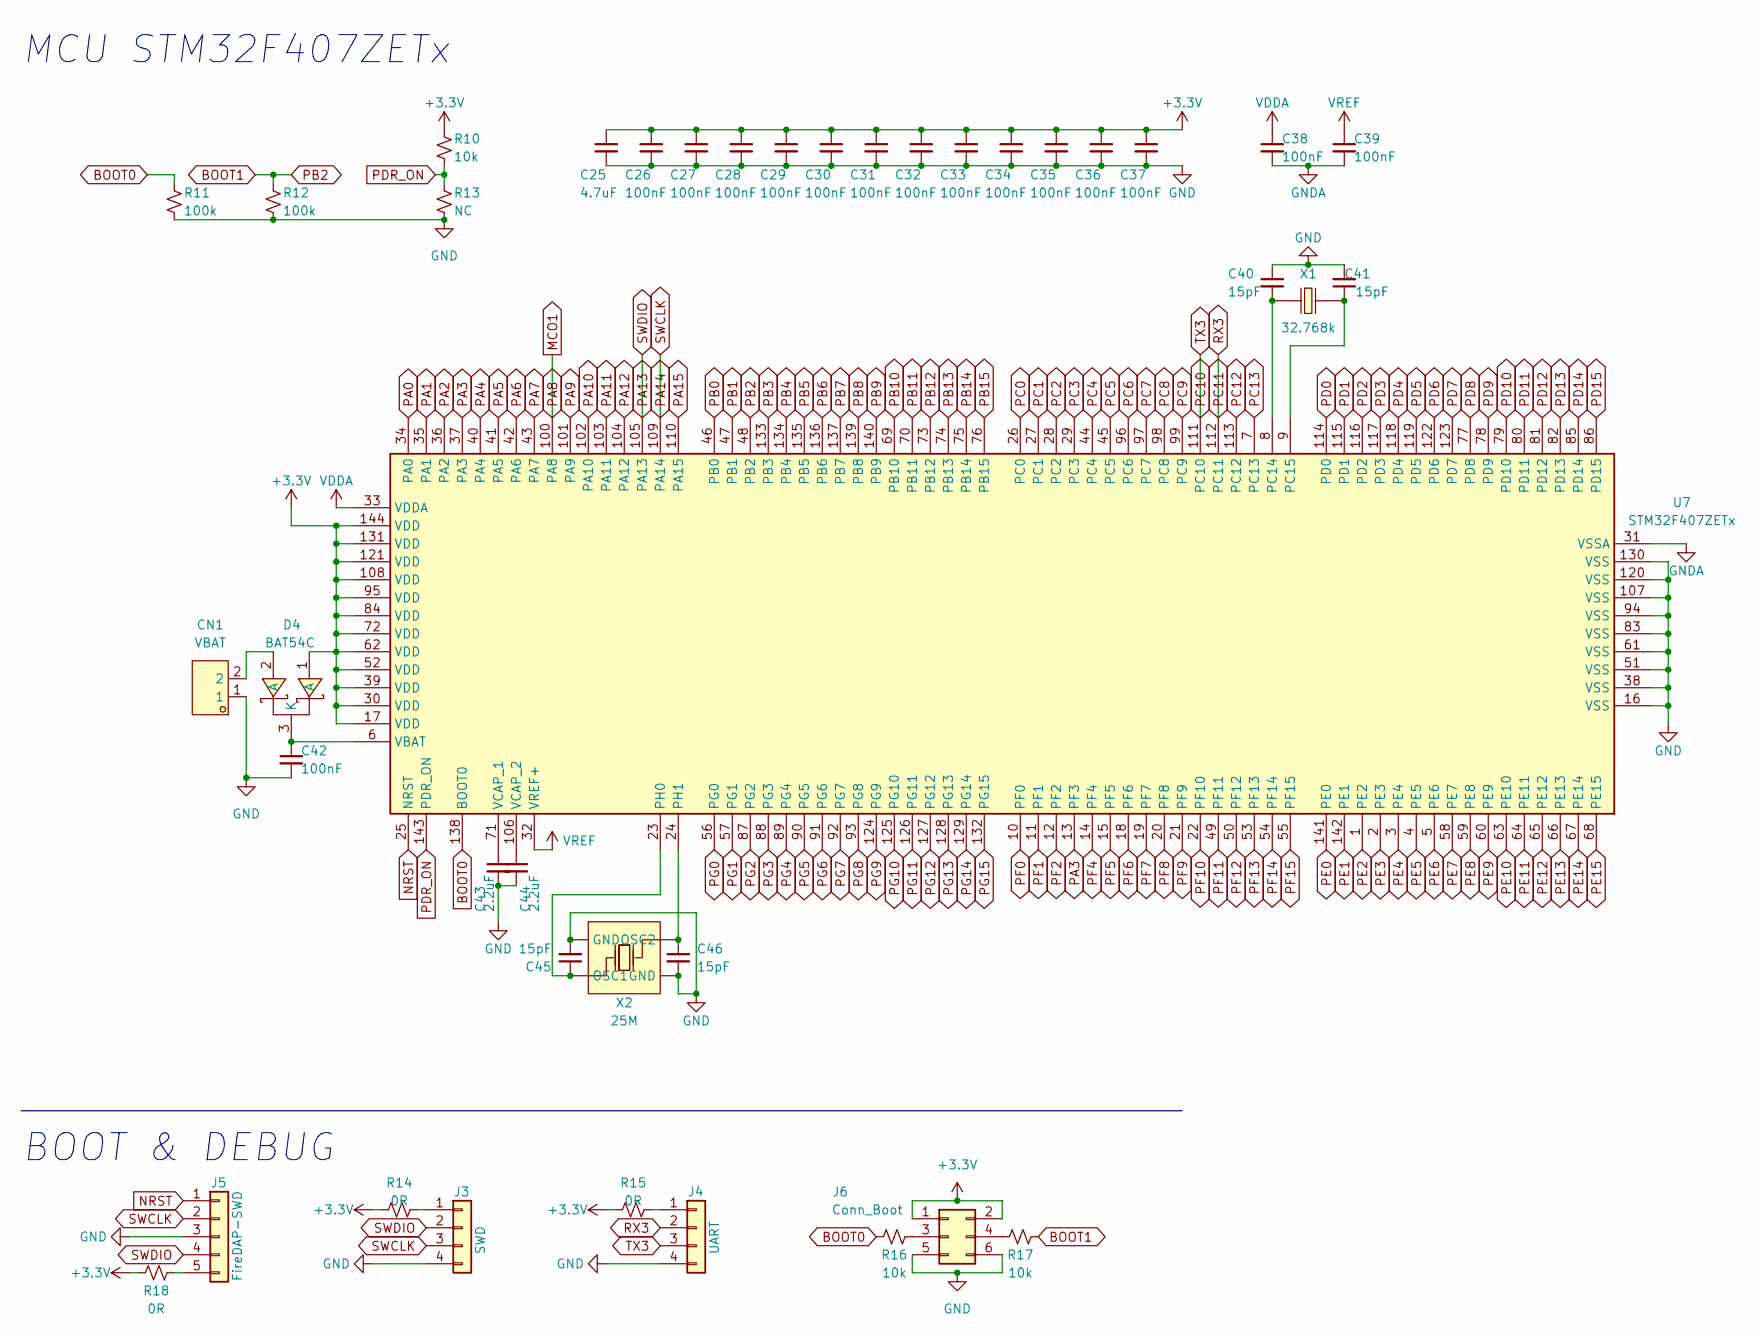
[picture p33: schematic mcu.kicad_sch, MCU,SWD,UART,BOOT]

Parts:
C25: 4.7uF; C0603; Voltage 16V; LCSC Part TBD
C26, C27, C28, C29, C30, C31, C32, C33, C34, C35, C36, C37: 100nF; C0603; Voltage 50V; LCSC Part TBD
C38, C39, C42: 100nF; C0603; Voltage 25V; LCSC Part TBD
C40, C41: 15pF; C0603; Voltage 16V; LCSC Part TBD
C43, C44: 2.2uF; C0603; Voltage 16V; LCSC Part TBD
C45, C46: 15pF; C0603; Voltage 50V; LCSC Part TBD
CN1: VBAT; CONN-TH_0530470210; LCSC Part C114130
D4: BAT54C; SOT-23-3_L2.9-W1.6-P1.90-LS2.8-BR; LCSC Part C37704
J3: SWD; PinHeader_1x04_P2.54mm_Vertical
J4: UART; PinHeader_1x04_P2.54mm_Vertical
J5: FireDAP-SWD; PinHeader_1x05_P2.54mm_Vertical
J6: Conn_Boot; PinHeader_2x03_P2.54mm_Vertical
R10, R16, R17: 10k; R0603; LCSC Part TBD
R11, R12: 100k; R0603; LCSC Part TBD
R13: NC; R0603; LCSC Part TBD
R14, R15, R18: 0R; R0603; LCSC Part TBD
U7: STM32F407ZETx; LQFP-144_20x20mm_P0.5mm
X1: 32.768k; FC-135R_L3.2-W1.5; LCSC Part C32346
X2: 25M; OSC-SMD_4P-L3.2-W2.5-BL; LCSC Part C9006

Connections:
+2V5: C39.1, U7.32 (VREF+); also elsewhere on the board
+3.3V: C25.1, C26.1, C27.1, C28.1, C29.1, C30.1, C31.1, C32.1, C33.1, C34.1, C35.1, C36.1, C37.1, D4.1 (A), J6.1, J6.2, R10.1, R14.2, R15.2, R18.2, U7.17 (VDD), U7.30 (VDD), U7.39 (VDD), U7.52 (VDD), U7.62 (VDD), U7.72 (VDD), U7.84 (VDD), U7.95 (VDD), U7.108 (VDD), U7.121 (VDD), U7.131 (VDD), U7.144 (VDD); also elsewhere on the board
BOOT0: R11.1, R16.2, U7.138 (BOOT0)
BOOT1: R12.1, R17.1, U7.48 (PB2)
GND: C25.2, C26.2, C27.2, C28.2, C29.2, C30.2, C31.2, C32.2, C33.2, C34.2, C35.2, C36.2, C37.2, C40.1, C41.2, C42.2, C43.2, C44.2, C45.2, C46.2, CN1.1, J3.4, J4.4, J5.3, J6.5, J6.6, R11.2, R12.2, R13.2, U7.16 (VSS), U7.38 (VSS), U7.51 (VSS), U7.61 (VSS), U7.83 (VSS), U7.94 (VSS), U7.107 (VSS), U7.120 (VSS), U7.130 (VSS), X2.2 (GND), X2.4 (GND); also elsewhere on the board
MCO1: U7.100 (PA8); also elsewhere on the board
NRST: J5.1, U7.25 (NRST); also elsewhere on the board
unnamed: C40.2, U7.8 (PC14), X1.1
unnamed: C41.1, U7.9 (PC15), X1.2
unnamed: C42.1, D4.3 (K), U7.6 (VBAT)
unnamed: C43.1, U7.71 (VCAP_1)
unnamed: C44.1, U7.106 (VCAP_2)
unnamed: C45.1, U7.23 (PH0), X2.1 (OSC1)
unnamed: C46.1, U7.24 (PH1), X2.3 (OSC2)
unnamed: CN1.2, D4.2 (A)
unnamed: J3.1, R14.1
unnamed: J4.1, R15.1
unnamed: J5.5, R18.1
unnamed: J6.3, R16.1
unnamed: J6.4, R17.2
PA0: U7.34 (PA0); also elsewhere on the board
PA1: U7.35 (PA1); also elsewhere on the board
PA2: U7.36 (PA2); also elsewhere on the board
PA3: U7.13 (PF3), U7.37 (PA3); also elsewhere on the board
PA4: U7.40 (PA4); also elsewhere on the board
PA5: U7.41 (PA5)
PA6: U7.42 (PA6); also elsewhere on the board
PA7: U7.43 (PA7); also elsewhere on the board
PA9: U7.101 (PA9); also elsewhere on the board
PA10: U7.102 (PA10); also elsewhere on the board
PA11: U7.103 (PA11); also elsewhere on the board
PA12: U7.104 (PA12); also elsewhere on the board
PA13: J3.2, J5.4, U7.105 (PA13)
PA14: J3.3, J5.2, U7.109 (PA14)
PA15: U7.110 (PA15)
PB0: U7.46 (PB0)
PB1: U7.47 (PB1)
PB3: U7.133 (PB3)
PB4: U7.134 (PB4)
PB5: U7.135 (PB5)
PB6: U7.136 (PB6); also elsewhere on the board
PB7: U7.137 (PB7); also elsewhere on the board
PB8: U7.139 (PB8); also elsewhere on the board
PB9: U7.140 (PB9); also elsewhere on the board
PB10: U7.69 (PB10)
PB11: U7.70 (PB11)
PB12: U7.73 (PB12); also elsewhere on the board
PB13: U7.74 (PB13); also elsewhere on the board
PB14: U7.75 (PB14); also elsewhere on the board
PB15: U7.76 (PB15); also elsewhere on the board
PC0: U7.26 (PC0)
PC1: U7.27 (PC1); also elsewhere on the board
PC2: U7.28 (PC2)
PC3: U7.29 (PC3)
PC4: U7.44 (PC4); also elsewhere on the board
PC5: U7.45 (PC5); also elsewhere on the board
PC6: U7.96 (PC6)
PC7: U7.97 (PC7); also elsewhere on the board
PC8: U7.98 (PC8); also elsewhere on the board
PC9: U7.99 (PC9); also elsewhere on the board
PC10: J4.3, U7.111 (PC10)
PC11: J4.2, U7.112 (PC11)
PC12: U7.113 (PC12)
PC13: U7.7 (PC13)
PD0: U7.114 (PD0); also elsewhere on the board
PD1: U7.115 (PD1); also elsewhere on the board
PD2: U7.116 (PD2)
PD3: U7.117 (PD3)
PD4: U7.118 (PD4); also elsewhere on the board
PD5: U7.119 (PD5); also elsewhere on the board
PD6: U7.122 (PD6)
PD7: U7.123 (PD7)
PD8: U7.77 (PD8); also elsewhere on the board
PD9: U7.78 (PD9); also elsewhere on the board
PD10: U7.79 (PD10); also elsewhere on the board
PD11: U7.80 (PD11); also elsewhere on the board
PD12: U7.81 (PD12); also elsewhere on the board
PD13: U7.82 (PD13)
PD14: U7.85 (PD14); also elsewhere on the board
PD15: U7.86 (PD15); also elsewhere on the board
PDR_ON: R10.2, R13.1, U7.143 (PDR_ON)
PE0: U7.141 (PE0); also elsewhere on the board
PE1: U7.142 (PE1); also elsewhere on the board
PE2: U7.1 (PE2); also elsewhere on the board
PE3: U7.2 (PE3); also elsewhere on the board
PE4: U7.3 (PE4); also elsewhere on the board
PE5: U7.4 (PE5); also elsewhere on the board
PE6: U7.5 (PE6); also elsewhere on the board
PE7: U7.58 (PE7); also elsewhere on the board
PE8: U7.59 (PE8); also elsewhere on the board
PE9: U7.60 (PE9); also elsewhere on the board
PE10: U7.63 (PE10); also elsewhere on the board
PE11: U7.64 (PE11); also elsewhere on the board
PE12: U7.65 (PE12); also elsewhere on the board
PE13: U7.66 (PE13); also elsewhere on the board
PE14: U7.67 (PE14); also elsewhere on the board
PE15: U7.68 (PE15); also elsewhere on the board
PF0: U7.10 (PF0); also elsewhere on the board
PF1: U7.11 (PF1); also elsewhere on the board
PF2: U7.12 (PF2); also elsewhere on the board
PF4: U7.14 (PF4); also elsewhere on the board
PF5: U7.15 (PF5); also elsewhere on the board
PF6: U7.18 (PF6); also elsewhere on the board
PF7: U7.19 (PF7); also elsewhere on the board
PF8: U7.20 (PF8); also elsewhere on the board
PF9: U7.21 (PF9)
PF10: U7.22 (PF10)
PF11: U7.49 (PF11); also elsewhere on the board
PF12: U7.50 (PF12); also elsewhere on the board
PF13: U7.53 (PF13); also elsewhere on the board
PF14: U7.54 (PF14); also elsewhere on the board
PF15: U7.55 (PF15); also elsewhere on the board
PG0: U7.56 (PG0); also elsewhere on the board
PG1: U7.57 (PG1); also elsewhere on the board
PG2: U7.87 (PG2); also elsewhere on the board
PG3: U7.88 (PG3); also elsewhere on the board
PG4: U7.89 (PG4); also elsewhere on the board
PG5: U7.90 (PG5); also elsewhere on the board
PG6: U7.91 (PG6)
PG7: U7.92 (PG7)
PG8: U7.93 (PG8)
PG9: U7.124 (PG9)
PG10: U7.125 (PG10)
PG11: U7.126 (PG11); also elsewhere on the board
PG12: U7.127 (PG12); also elsewhere on the board
PG13: U7.128 (PG13); also elsewhere on the board
PG14: U7.129 (PG14); also elsewhere on the board
PG15: U7.132 (PG15); also elsewhere on the board

Notes on the sheet:
BOOT & DEBUG
MCU STM32F407ZETx
