aiex718/CCTV3.0-F407/PCB/CCTV3_F407_REV100/CCTV3_F407_REV100.kicad_pcb

## KiCad design PCB/CCTV3_F407_REV100/CCTV3_F407_REV100.kicad_pcb (continued)

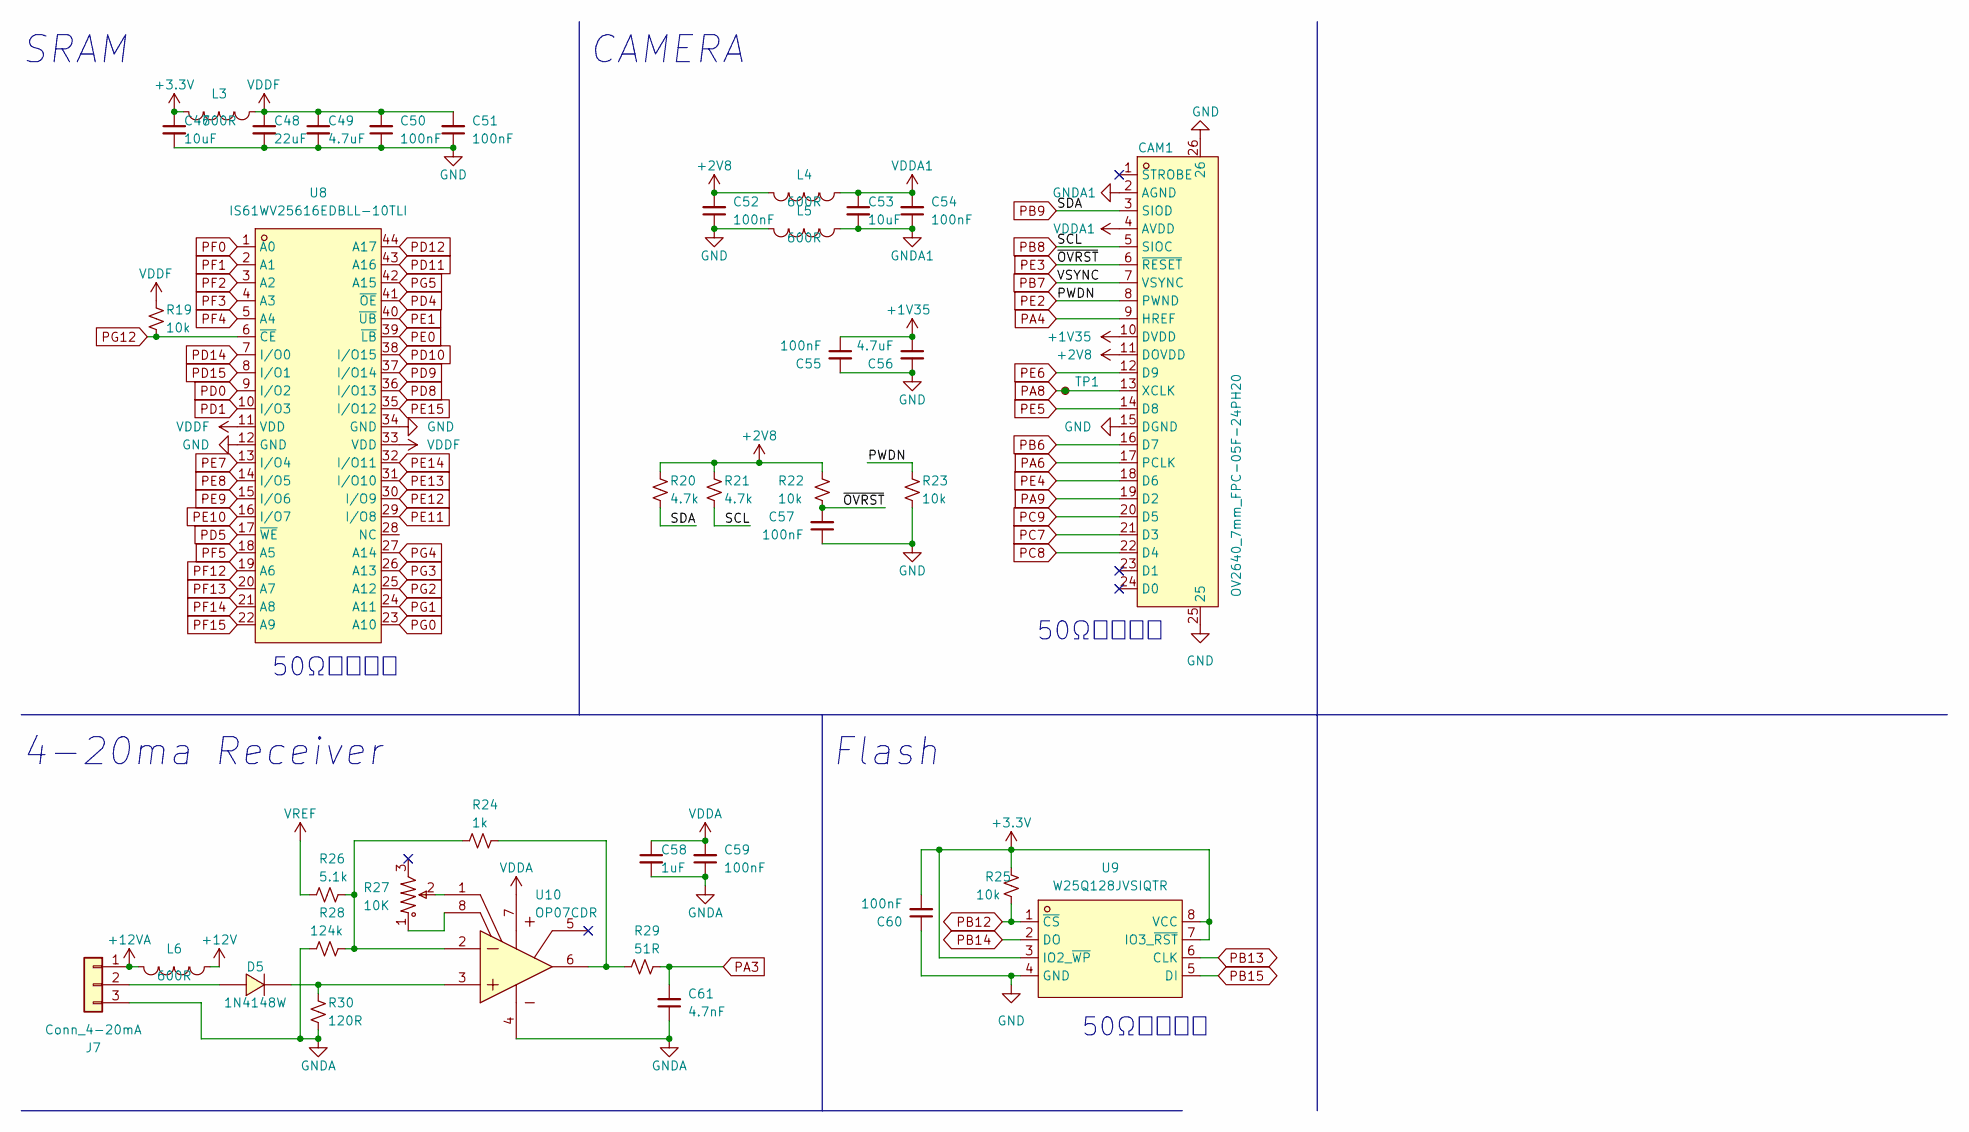
[picture p34: schematic highspeed_peripheral.kicad_sch, SRAM,Flash,Camera,4-20mA Receiver]

Parts:
C47, C53: 10uF; C0603; Voltage 16V; LCSC Part TBD
C48: 22uF; C0603; Voltage 6.3V; LCSC Part TBD
C49, C56: 4.7uF; C0603; Voltage 16V; LCSC Part TBD
C50, C51, C52, C54, C55, C57, C59, C60: 100nF; C0603; Voltage 50V; LCSC Part TBD
C58: 1uF; C0603; Voltage 50V; LCSC Part TBD
C61: 4.7nF; C0603; Voltage 50V; LCSC Part TBD
CAM1: OV2640_7mm_FPC-05F-24PH20; LCSC Part C2856805
D5: 1N4148W; SOD-123F_L2.7-W1.6-LS3.8-RD; LCSC Part C81598
J7: Conn_4-20mA; PhoenixContact_MSTBA_2,5_3-G_1x03_P5.00mm_Horizontal
L3, L4, L5, L6: 600R; L0603; LCSC Part C1002
R19, R22, R23, R25: 10k; R0603; LCSC Part TBD
R20, R21: 4.7k; R0603; LCSC Part TBD
R24: 1k; R0603; Tolerance 1%; LCSC Part TBD
R26: 5.1k; R0603; Tolerance 1%; LCSC Part TBD
R27: 10K; RES-ADJ-TH_3P-L10.0-W10.0-P2.50-L; LCSC Part C118954
R28: 124k; R0603; Tolerance 1%; LCSC Part TBD
R29: 51R; R0603; LCSC Part TBD
R30: 120R; R0603; Tolerance 0.1%; LCSC Part TBD
TP1: TestPoint_Small; TestPoint_Pad_D1.0mm
U8: IS61WV25616EDBLL-10TLI; TSOP-44_L18.4-W10.2-P0.80-LS11.8-BL; LCSC Part C883296
U9: W25Q128JVSIQTR; SOIC-8_L5.3-W5.3-P1.27-LS8.0-BL; LCSC Part C97521
U10: OP07CDR; SOIC-8_L4.9-W3.9-P1.27-LS6.0-BL; LCSC Part C7433

Connections:
+1V35: C55.1, C56.1, CAM1.10 (DVDD)
+2V5: R26.2; also elsewhere on the board
+2V8: C52.2, CAM1.11 (DOVDD), L4.1, R20.1, R21.1, R22.1; also elsewhere on the board
+3.3V: C47.1, C60.2, L3.1, R25.1, U9.3 (IO2_~WP), U9.7 (IO3_~RST), U9.8 (VCC); also elsewhere on the board
+12VA: J7.1, L6.1
GND: C47.2, C48.2, C49.2, C50.1, C51.1, C52.1, C55.2, C56.2, C57.1, C60.1, CAM1.15 (DGND), CAM1.25, CAM1.26, L5.1, R23.2, U8.12 (GND), U8.34 (GND), U9.4 (GND); also elsewhere on the board
MCO1: CAM1.13 (XCLK), TP1.1; also elsewhere on the board
unnamed: D5.1 (K), R30.1, U10.3 (IN+)
unnamed: D5.2 (A), J7.2
unnamed: R24.1, R29.2, U10.6 (OUT)
unnamed: R24.2, R26.1, R28.1, U10.2 (IN-)
unnamed: R27.1, U10.8 (OFFSETN2)
unnamed: R27.2, U10.1 (OFFSETN1)
PA3: C61.2, R29.1; also elsewhere on the board
PA4: CAM1.9 (HREF); also elsewhere on the board
PA6: CAM1.17 (PCLK); also elsewhere on the board
PA9: CAM1.19 (D2); also elsewhere on the board
PB6: CAM1.16 (D7); also elsewhere on the board
PB7: CAM1.7 (VSYNC); also elsewhere on the board
PB8: CAM1.5 (SIOC), R21.2; also elsewhere on the board
PB9: CAM1.3 (SIOD), R20.2; also elsewhere on the board
PB12: R25.2, U9.1 (~CS); also elsewhere on the board
PB13: U9.6 (CLK); also elsewhere on the board
PB14: U9.2 (DO); also elsewhere on the board
PB15: U9.5 (DI); also elsewhere on the board
PC7: CAM1.21 (D3); also elsewhere on the board
PC8: CAM1.22 (D4); also elsewhere on the board
PC9: CAM1.20 (D5); also elsewhere on the board
PD0: U8.9 (I/O2); also elsewhere on the board
PD1: U8.10 (I/O3); also elsewhere on the board
PD4: U8.41 (~OE); also elsewhere on the board
PD5: U8.17 (~WE); also elsewhere on the board
PD8: U8.36 (I/O13); also elsewhere on the board
PD9: U8.37 (I/O14); also elsewhere on the board
PD10: U8.38 (I/O15); also elsewhere on the board
PD11: U8.43 (A16); also elsewhere on the board
PD12: U8.44 (A17); also elsewhere on the board
PD14: U8.7 (I/O0); also elsewhere on the board
PD15: U8.8 (I/O1); also elsewhere on the board
PE0: U8.39 (~LB); also elsewhere on the board
PE1: U8.40 (~UB); also elsewhere on the board
PE2: CAM1.8 (PWND), R23.1; also elsewhere on the board
PE3: C57.2, CAM1.6 (~RESET), R22.2; also elsewhere on the board
PE4: CAM1.18 (D6); also elsewhere on the board
PE5: CAM1.14 (D8); also elsewhere on the board
PE6: CAM1.12 (D9); also elsewhere on the board
PE7: U8.13 (I/O4); also elsewhere on the board
PE8: U8.14 (I/O5); also elsewhere on the board
PE9: U8.15 (I/O6); also elsewhere on the board
PE10: U8.16 (I/O7); also elsewhere on the board
PE11: U8.29 (I/O8); also elsewhere on the board
PE12: U8.30 (I/O9); also elsewhere on the board
PE13: U8.31 (I/O10); also elsewhere on the board
PE14: U8.32 (I/O11); also elsewhere on the board
PE15: U8.35 (I/O12); also elsewhere on the board
PF0: U8.1 (A0); also elsewhere on the board
PF1: U8.2 (A1); also elsewhere on the board
PF2: U8.3 (A2); also elsewhere on the board
PF3: U8.4 (A3)
PF4: U8.5 (A4); also elsewhere on the board
PF5: U8.18 (A5); also elsewhere on the board
PF12: U8.19 (A6); also elsewhere on the board
PF13: U8.20 (A7); also elsewhere on the board
PF14: U8.21 (A8); also elsewhere on the board
PF15: U8.22 (A9); also elsewhere on the board
PG0: U8.23 (A10); also elsewhere on the board
PG1: U8.24 (A11); also elsewhere on the board
PG2: U8.25 (A12); also elsewhere on the board
PG3: U8.26 (A13); also elsewhere on the board
PG4: U8.27 (A14); also elsewhere on the board
PG5: U8.42 (A15); also elsewhere on the board
PG12: R19.2, U8.6 (~CE); also elsewhere on the board
VDDF: C48.1, C49.1, C50.2, C51.2, L3.2, R19.1, U8.11 (VDD), U8.33 (VDD)

Notes on the sheet:
4-20ma Receiver
CAMERA
Flash
50Ω等長走線
SRAM

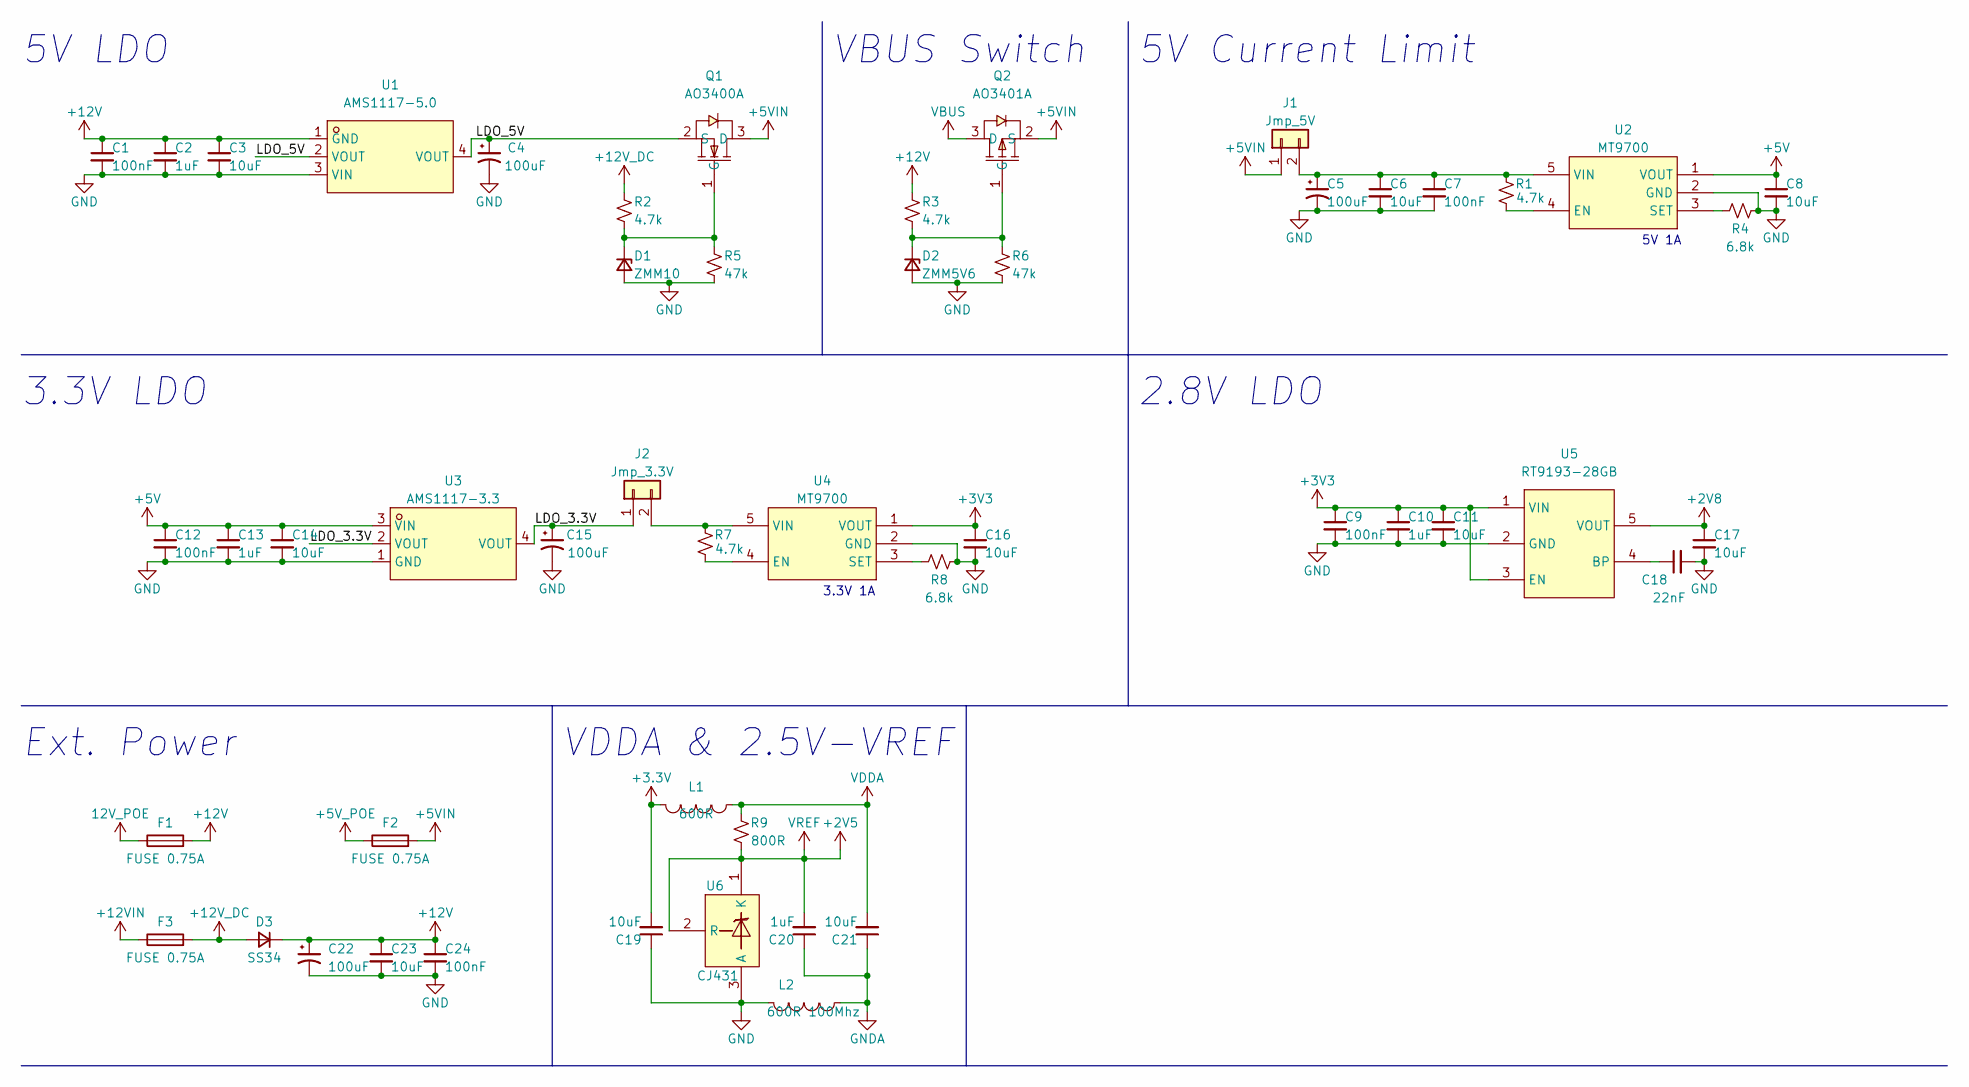
[picture p35: schematic power.kicad_sch]

Parts:
C1, C7, C12, C24: 100nF; C0603; Voltage 50V; LCSC Part TBD
C2, C13: 1uF; C0603; Voltage 25V; LCSC Part TBD
C3, C6, C8, C14, C16: 10uF; C0603; Voltage 25V; LCSC Part TBD
C4, C15: 100uF; CAP-SMD_L3.5-W2.8; Voltage 6.3V Tantalum; LCSC Part TBD
C5, C22: 100uF; CP_Radial_D8.0mm_P3.50mm; Voltage 50V; LCSC Part C350209
C9: 100nF; C0603; Voltage 25V; LCSC Part TBD
C10, C20: 1uF; C0603; Voltage 16V; LCSC Part TBD
C11, C17, C19, C21: 10uF; C0603; Voltage 16V; LCSC Part TBD
C18: 22nF; C0603; Voltage 50V; LCSC Part TBD
C23: 10uF; C1206; Voltage 50V; LCSC Part TBD
D1: ZMM10; LL-34_L3.5-W1.5-RD; LCSC Part C707201
D2: ZMM5V6; LL-34_L3.5-W1.5-RD; LCSC Part C8062
D3: SS34; DO-214AC_L4.3-W2.7-LS5.3-RD; LCSC Part C8678
F1, F2, F3: FUSE 0.75A; F1812; Voltage 33V
J1: Jmp_5V; PinHeader_2x01_P2.54mm_Vertical
J2: Jmp_3.3V; PinHeader_2x01_P2.54mm_Vertical
L1: 600R; L0603; LCSC Part C1002
L2: 600R 100Mhz; L0603; LCSC Part C1002
Q1: AO3400A; SOT-23-3_L2.9-W1.6-P1.90-LS2.8-BR; LCSC Part C20917
Q2: AO3401A; SOT-23_L2.9-W1.3-P1.90-LS2.4-BR; LCSC Part C15127
R1, R2, R3, R7: 4.7k; R0603; LCSC Part TBD
R4, R8: 6.8k; R0603; LCSC Part TBD
R5, R6: 47k; R0603; LCSC Part TBD
R9: 800R; R0805; LCSC Part TBD
U1: AMS1117-5.0; SOT-223_L6.5-W3.5-P2.30-LS7.0-BR; LCSC Part C6187
U2, U4: MT9700; SOT-23-5_L3.0-W1.7-P0.95-LS2.8-BR; LCSC Part C89855
U3: AMS1117-3.3; SOT-223-3_L6.5-W3.4-P2.30-LS7.0-BR; LCSC Part C6186
U5: RT9193-28GB; SOT-23-5_L3.0-W1.7-P0.95-LS2.8-BR; LCSC Part C56731
U6: CJ431; SOT-23-3_L2.9-W1.6-P1.90-LS2.8-BR; LCSC Part C3113

Connections:
+2V5: C20.2, R9.1, U6.1 (K), U6.2 (R); also elsewhere on the board
+2V8: C17.1, U5.5 (VOUT); also elsewhere on the board
+3.3V: C19.2, L1.1; also elsewhere on the board
+3V3: C9.1, C10.1, C11.1, C16.1, U4.1 (VOUT), U5.1 (VIN), U5.3 (EN)
/POWER/LDO_3.3V: C15.1, J2.1, U3.2 (VOUT), U3.4 (VOUT)
/POWER/LDO_5V: C4.1, Q1.2 (S), U1.2 (VOUT), U1.4 (VOUT)
GND: C1.2, C2.2, C3.2, C4.2, C5.2, C6.2, C7.2, C8.2, C9.2, C10.2, C11.2, C12.2, C13.2, C14.2, C15.2, C16.2, C17.2, C18.2, C19.1, C22.2, C23.2, C24.2, D1.2 (A), D2.2 (A), L2.1, R4.2, R5.1, R6.1, R8.2, U1.3 (VIN), U2.2 (GND), U3.1 (GND), U4.2 (GND), U5.2 (GND), U6.3 (A); also elsewhere on the board
unnamed: C5.1, C6.1, C7.1, J1.2, R1.1, U2.5 (VIN)
unnamed: C18.1, U5.4 (BP)
unnamed: D1.1 (K), Q1.1 (G), R2.1, R5.2
unnamed: D2.1 (K), Q2.1 (G), R3.1, R6.2
unnamed: J2.2, R7.1, U4.5 (VIN)
unnamed: R1.2, U2.4 (EN)
unnamed: R4.1, U2.3 (SET)
unnamed: R7.2, U4.4 (EN)
unnamed: R8.1, U4.3 (SET)
VBUS: Q2.3 (D); also elsewhere on the board

Notes on the sheet:
5V Current Limit
2.8V LDO
3.3V 1A
5V LDO
VBUS Switch
VDDA & 2.5V-VREF
3.3V LDO
Ext. Power
5V 1A

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
Board: 4 copper layers, 224 parts (1 on the bottom side), 171 nets, no tracks yet.
