aiex718/CCTV3.0-F407/PCB/CCTV3_POE_REV100/CCTV3_POE_REV100.kicad_pcb

## KiCad design PCB/CCTV3_POE_REV100/CCTV3_POE_REV100.kicad_pcb (2023-03-06)

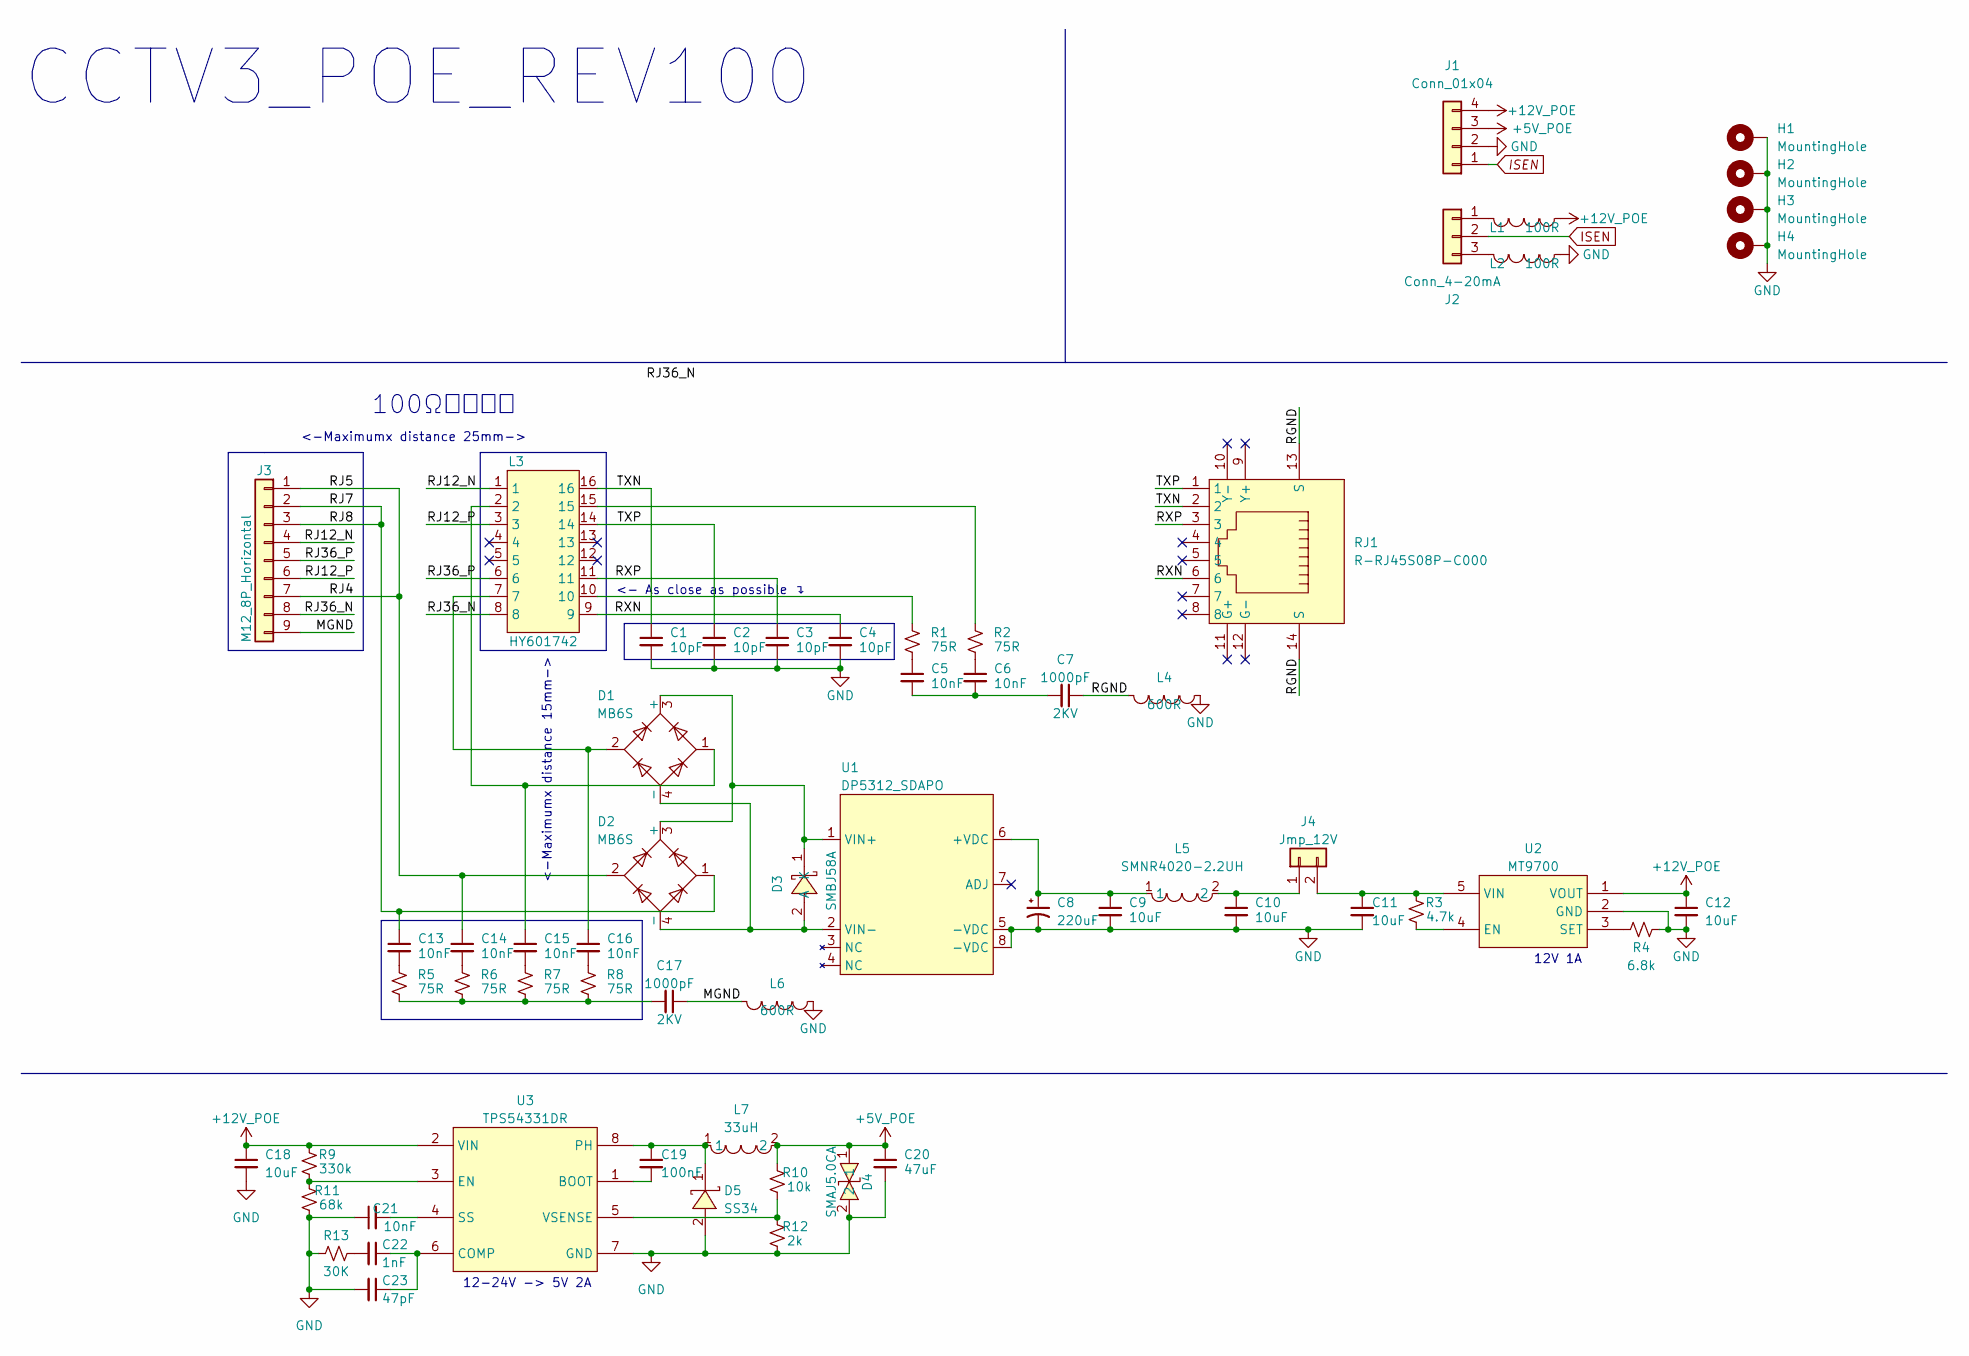
[picture p36: schematic CCTV3_POE_REV100.kicad_sch, POE]

Parts:
C1, C2, C3, C4: 10pF; C_0402_1005Metric; Voltage 50V; LCSC Part TBD
C5, C6, C13, C14, C15, C16: 10nF; C_0603_1608Metric; Voltage 250V; LCSC Part TBD
C7, C17: 1000pF; C_1206_3216Metric; Voltage 2KV; LCSC Part TBD
C8: 220uF; CP_Elec_6.3x7.7; Voltage 25V; LCSC Part C371974
C9, C10: 10uF; C_0805_2012Metric; Voltage 25V; LCSC Part TBD
C11: 10uF; C_0603_1608Metric; Voltage 25V; LCSC Part TBD
C12, C18: 10uF; C_1206_3216Metric; Voltage 50V; LCSC Part TBD
C19: 100nF; C_0603_1608Metric; Voltage 50V; LCSC Part TBD
C20: 47uF; C_1206_3216Metric; Voltage 10V; LCSC Part TBD
C21: 10nF; C_0603_1608Metric; Voltage 50; LCSC Part TBD
C22: 1nF; C_0603_1608Metric; Voltage 50V; LCSC Part TBD
C23: 47pF; C_0603_1608Metric; Voltage 50V; LCSC Part TBD
D1, D2: MB6S; TO-269AA
D3: SMBJ58A; D_SMB; LCSC Part C707476
D4: SMAJ5.0CA; D_SMA; LCSC Part C83324
D5: SS34; D_SMA; LCSC Part C8678
H1, H2, H3, H4: MountingHole; MountingHole_2.2mm_M2_Pad
J1: Conn_01x04; PinHeader_1x04_P2.54mm_Vertical
J2: Conn_4-20mA; PhoenixContact_MSTBA_2,5_3-G_1x03_P5.00mm_Horizontal
J3: M12_8P_Horizontal
J4: Jmp_12V; PinHeader_2x01_P2.54mm_Vertical
L1, L2: 100R; L_0805_2012Metric; LCSC Part C1015
L3: HY601742; RJ45-SMD_HY601742; LCSC Part C55684
L4, L6: 600R; L_0603_1608Metric; LCSC Part C1002
L5: SMNR4020-2.2UH; IND-SMD_L4.0-W4.0_SMNR4020; LCSC Part C135262
L7: 33uH; IND-SMD_L6.0-W6.0; LCSC Part C285825
R1, R2, R5, R6, R7, R8: 75R; R_0603_1608Metric; LCSC Part TBD
R3: 4.7k; R_0603_1608Metric; LCSC Part TBD
R4: 6.8k; R_0603_1608Metric; LCSC Part TBD
R9: 330k; R_0603_1608Metric; LCSC Part TBD
R10: 10k; R_0603_1608Metric; LCSC Part TBD
R11: 68k; R_0603_1608Metric; LCSC Part TBD
R12: 2k; R_0603_1608Metric; LCSC Part TBD
R13: 30K; R_0603_1608Metric; LCSC Part TBD
RJ1: R-RJ45S08P-C000; RJ45-TH_R-RJ45S08P-C000; LCSC Part C386764
U1: DP5312_SDAPO
U2: MT9700; SOT-23-5; LCSC Part C89855
U3: TPS54331DR; SOIC-8_3.9x4.9mm_P1.27mm; LCSC Part C9865

Connections:
+5V_POE: C20.1, D4.1, J1.3, L7.2, R10.1
+12V_POE: C12.1, C18.1, J1.4, L1.2, R9.1, U2.1 (VOUT), U3.2 (VIN)
/MGND: C17.1, J3.9, L6.1
/RGND: C7.1, L4.1, RJ1.13 (S), RJ1.14 (S)
/RJ5: C14.1, D2.2, J3.1, J3.7
/RJ7: C13.1, D2.1, J3.2, J3.3
/RJ12_N: J3.4, L3.1
/RJ12_P: J3.6, L3.3
/RJ36_N: J3.8, L3.8
/RJ36_P: J3.5, L3.6
/RXN: C4.1, L3.9, RJ1.6
/RXP: C3.1, L3.11, RJ1.3
/TXN: C1.1, L3.16, RJ1.2
/TXP: C2.1, L3.14, RJ1.1
GND: C1.2, C2.2, C3.2, C4.2, C8.2, C9.2, C10.2, C11.2, C12.2, C18.2, C20.2, C21.1, C23.2, D4.2, D5.2 (A), H1.1, H2.1, H3.1, H4.1, J1.2, L2.2, L4.2, L6.2, R4.2, R11.2, R12.2, R13.2, U1.5 (-VDC), U1.8 (-VDC), U2.2 (GND), U3.7 (GND)
ISEN: J1.1, J2.2
unnamed: C5.1, R1.2
unnamed: C5.2, C6.2, C7.2
unnamed: C6.1, R2.2
unnamed: C8.1, C9.1, L5.1, U1.6 (+VDC)
unnamed: C10.1, J4.1, L5.2
unnamed: C11.1, J4.2, R3.1, U2.5 (VIN)
unnamed: C13.2, R5.1
unnamed: C14.2, R6.1
unnamed: C15.1, D1.1, L3.2
unnamed: C15.2, R7.1
unnamed: C16.1, D1.2, L3.7
unnamed: C16.2, R8.1
unnamed: C17.2, R5.2, R6.2, R7.2, R8.2
unnamed: C19.1, D5.1 (K), L7.1, U3.8 (PH)
unnamed: C19.2, U3.1 (BOOT)
unnamed: C21.2, U3.4 (SS)
unnamed: C22.1, C23.1, U3.6 (COMP)
unnamed: C22.2, R13.1
unnamed: D1.3 (+), D2.3 (+), D3.1 (K), U1.1 (VIN+)
unnamed: D1.4 (-), D2.4 (-), D3.2 (A), U1.2 (VIN-)
unnamed: J2.1, L1.1
unnamed: J2.3, L2.1
unnamed: L3.10, R1.1
unnamed: L3.15, R2.1
unnamed: R3.2, U2.4 (EN)
unnamed: R4.1, U2.3 (SET)
unnamed: R10.2, R12.1, U3.5 (VSENSE)
unnamed: R9.2, R11.1, U3.3 (EN)

Notes on the sheet:
100Ω差動走線
CCTV3_POE_REV100
<- As close as possible ↴
12V 1A
12-24V -> 5V 2A
<-Maximumx distance 15mm->
<-Maximumx distance 25mm->

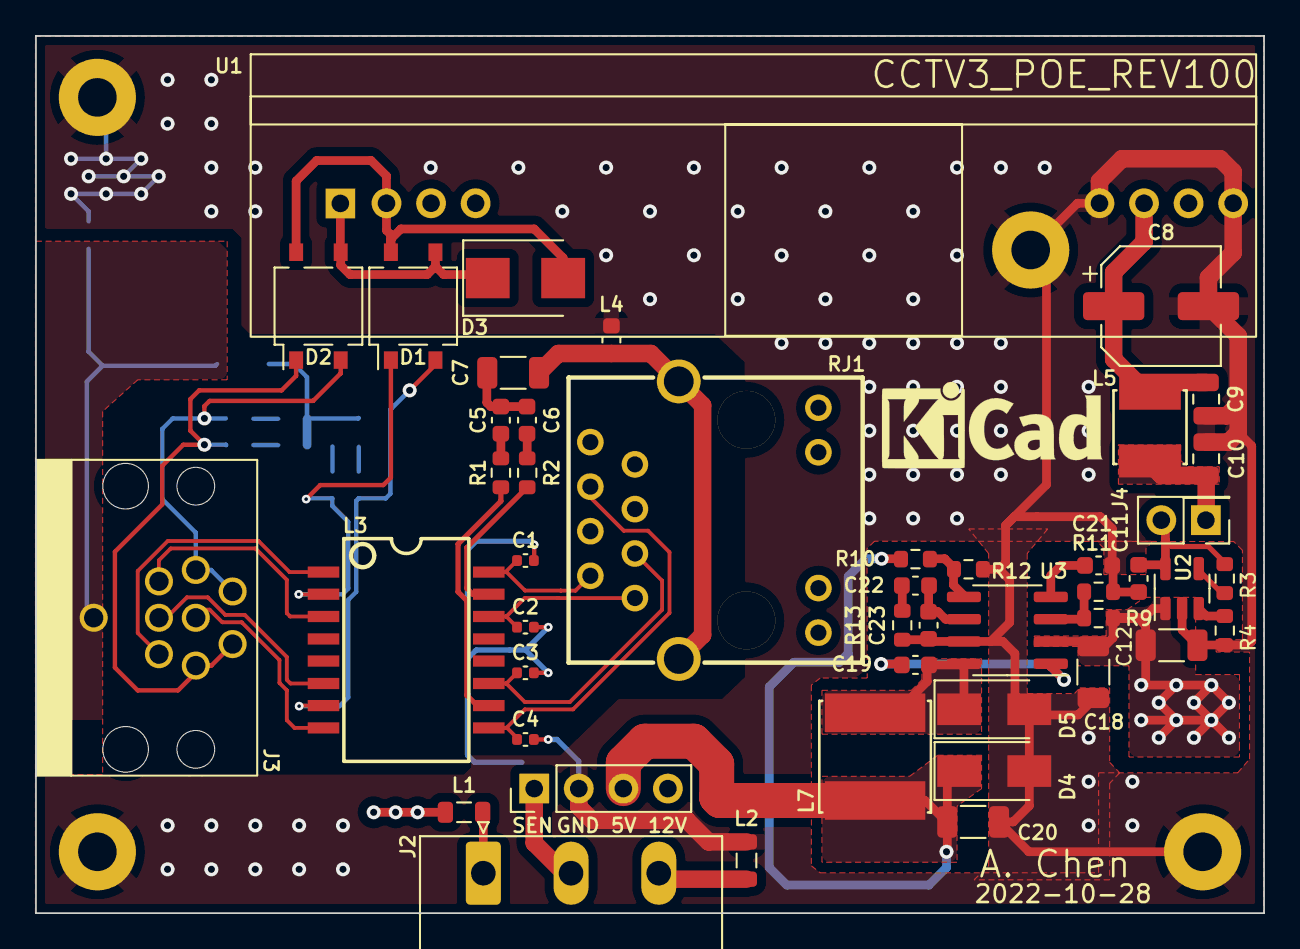
[picture p37: board CCTV3_POE_REV100.kicad_pcb from above]

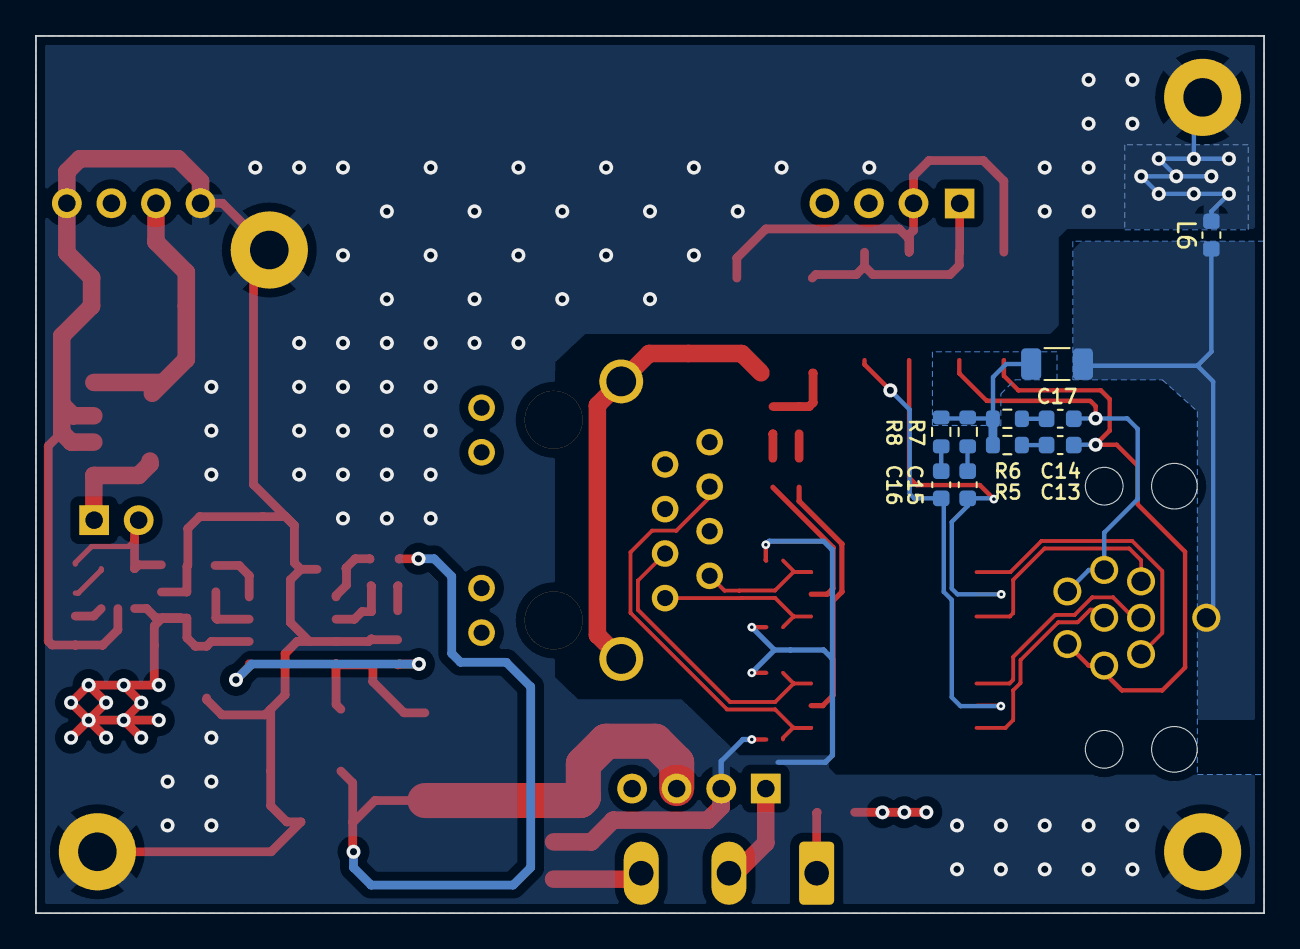
[picture p38: board CCTV3_POE_REV100.kicad_pcb from below]

Board: 4 copper layers, 70.0 x 50.0 mm, 60 parts (10 on the bottom side), 44 nets.
