aiex718/CCTV3.0-F407/PCB/CCTV3_F407_REV200/CubeMX/CCTV3_F407_REV200.ioc

Mcu.UserName=STM32F407VETx
PA0-WKUP.GPIO_Label=BTN_WKUP
PA0-WKUP.Signal=GPIO_Input
PA1.Signal=ETH_REF_CLK
PA10.GPIO_Label=USB_OTG_FS_ID
PA10.Signal=GPIO_Input
PA11.Signal=USB_OTG_FS_DM
PA12.Signal=USB_OTG_FS_DP
PA13.Signal=SYS_JTMS-SWDIO
PA14.Signal=SYS_JTCK-SWCLK
PA15.GPIO_Label=W25_CS
PA15.Signal=SPI3_NSS
PA2.Signal=ETH_MDIO
PA3.GPIO_Label=PWM_BUZZ
PA3.Signal=S_TIM9_CH2
PA4.Signal=DCMI_HSYNC
PA6.Signal=DCMI_PIXCLK
PA7.Signal=ETH_CRS_DV
PA8.Signal=RCC_MCO_1
PB11.Signal=ETH_TX_EN
PB12.Signal=ETH_TXD0
PB13.Signal=ETH_TXD1
PB14.GPIO_Label=PWM_LED_CH1
PB14.Signal=S_TIM12_CH1
PB15.GPIO_Label=PWM_LED_CH2
PB15.Signal=S_TIM12_CH2
PB2.GPIO_Label=BOOT1
PB2.Signal=GPIO_Input
PB6.Signal=DCMI_D5
PB7.Signal=DCMI_VSYNC
PB8.GPIO_Label=SCCB_SCL
PB8.Signal=I2C1_SCL
PB9.GPIO_Label=SCCB_SDA
PB9.Signal=I2C1_SDA
PC0.GPIO_Label=LED_LOAD
PC0.Signal=GPIO_Output
PC1.Signal=ETH_MDC
PC10.GPIO_Label=W25_SCK
PC10.Signal=SPI3_SCK
PC11.GPIO_Label=W25_MISO
PC11.Signal=SPI3_MISO
PC12.GPIO_Label=W25_MOSI
PC12.Signal=SPI3_MOSI
PC13-ANTI_TAMP.GPIO_Label=BTN_TAMP
PC13-ANTI_TAMP.Signal=GPIO_Input
PC14-OSC32_IN.Signal=RCC_OSC32_IN
PC15-OSC32_OUT.Signal=RCC_OSC32_OUT
PC2.GPIO_Label=LED_STAT
PC2.Signal=GPIO_Output
PC3.Signal=ADCx_IN13
PC4.Signal=ETH_RXD0
PC5.Signal=ETH_RXD1
PC6.Signal=DCMI_D0
PC7.Signal=DCMI_D1
PC9.Signal=RCC_MCO_2
PD8.Signal=USART3_TX
PD9.Signal=USART3_RX
PE0.Signal=DCMI_D2
PE1.Signal=DCMI_D3
PE2.GPIO_Label=OV_PWDN
PE2.Signal=GPIO_Output
PE3.GPIO_Label=OV_RESET
PE3.Signal=GPIO_Output
PE4.Signal=DCMI_D4
PE5.Signal=DCMI_D6
PE6.Signal=DCMI_D7
PH0-OSC_IN.Signal=RCC_OSC_IN
PH1-OSC_OUT.Signal=RCC_OSC_OUT
