aiex718/CCTV3.0-F407/MDK/CCTV3_F407_MDK_REV200/User/bsp/sys/sysctrl.c

#include "bsp/sys/sysctrl.h"
#include "bsp/sys/systime.h"

__IO SysTime_t ResetTime=0;

void SysCtrl_ResetAfter(uint16_t ms)
{
    ResetTime = SysTime_Get() + ms;
}

void SysCtrl_RaiseHardFault(void)
{
    void (*func)(int)  = (void(*)(int))0xFFFFFFFF;
    func(0);
}

void SysCtrl_Service(void)
{
    if(ResetTime && SysTime_Get() > ResetTime)
        SysCtrl_Reset();
}
