aiex718/CCTV3.0-F407/MDK/CCTV3_F407_MDK_REV200/User/bsp/sys/sysctrl.h

#ifndef __SYSCTRL_H__
#define __SYSCTRL_H__

#include "bsp/platform/platform_defs.h"

#define SysCtrl_EnterSleep  __WFI
#define SysCtrl_IsThreadInIRq() (SCB->ICSR & SCB_ICSR_VECTACTIVE_Msk > 0)
#define SysCtrl_Reset   NVIC_SystemReset

void SysCtrl_ResetAfter(uint16_t ms);
void SysCtrl_RaiseHardFault(void);
void SysCtrl_Service(void);

#endif
