aiex718/CCTV3.0-F407/MDK/CCTV3_F407_MDK_REV200/User/bsp/platform/device/dev_cam_ov2640.c

#include "bsp/platform/device/dev_cam_ov2640.h"

Device_CamOV2640_t Dev_Cam_OV2640_Inst  = {
	.CamOV2640_DCMI = __VAR_CAST_VAR(HAL_DCMI_t){
		.DCMIx = DCMI,
		.DCMI_RCC_Cmd = __CONST_CAST_VAR(HAL_RCC_Cmd_t){
			.RCC_AHB2Periph = RCC_AHB2Periph_DCMI,
		},
		.DCMI_Pins = __CONST_ARRAY_CAST_VAR(HAL_GPIO_pin_t*){
			__CONST_CAST_VAR(HAL_GPIO_pin_t){
				.GPIOx = GPIOC, //DCMI_D0 - PC6
				.GPIO_RCC_cmd = __CONST_CAST_VAR(HAL_RCC_Cmd_t){
					.RCC_AHB1Periph = RCC_AHB1Periph_GPIOC,
				},
				.GPIO_InitCfg = __CONST_CAST_VAR(GPIO_InitTypeDef){		
					.GPIO_Pin = GPIO_Pin_6,
					.GPIO_Mode = GPIO_Mode_AF,
					.GPIO_Speed = GPIO_Speed_50MHz,
					.GPIO_OType = GPIO_OType_PP,
					.GPIO_PuPd = GPIO_PuPd_NOPULL
				},
				.GPIO_AF_PinSource = GPIO_PinSource6,
				.GPIO_AF_Mapping = GPIO_AF_DCMI,
			},
			__CONST_CAST_VAR(HAL_GPIO_pin_t){
				.GPIOx = GPIOC, //DCMI_D1 - PC7
				.GPIO_RCC_cmd = __CONST_CAST_VAR(HAL_RCC_Cmd_t){
					.RCC_AHB1Periph = RCC_AHB1Periph_GPIOC,
				},
				.GPIO_InitCfg = __CONST_CAST_VAR(GPIO_InitTypeDef){		
					.GPIO_Pin = GPIO_Pin_7,
					.GPIO_Mode = GPIO_Mode_AF,
					.GPIO_Speed = GPIO_Speed_50MHz,
					.GPIO_OType = GPIO_OType_PP,
					.GPIO_PuPd = GPIO_PuPd_NOPULL
				},
				.GPIO_AF_PinSource = GPIO_PinSource7,
				.GPIO_AF_Mapping = GPIO_AF_DCMI,
			},
			__CONST_CAST_VAR(HAL_GPIO_pin_t){
				.GPIOx = GPIOE, //DCMI_D2 - PE0
				.GPIO_RCC_cmd = __CONST_CAST_VAR(HAL_RCC_Cmd_t){
					.RCC_AHB1Periph = RCC_AHB1Periph_GPIOE,
				},
				.GPIO_InitCfg = __CONST_CAST_VAR(GPIO_InitTypeDef){		
					.GPIO_Pin = GPIO_Pin_0,
					.GPIO_Mode = GPIO_Mode_AF,
					.GPIO_Speed = GPIO_Speed_50MHz,
					.GPIO_OType = GPIO_OType_PP,
					.GPIO_PuPd = GPIO_PuPd_NOPULL
				},
				.GPIO_AF_PinSource = GPIO_PinSource0,
				.GPIO_AF_Mapping = GPIO_AF_DCMI,
			},
			__CONST_CAST_VAR(HAL_GPIO_pin_t){
				.GPIOx = GPIOE, //DCMI_D3 - PE1
				.GPIO_RCC_cmd = __CONST_CAST_VAR(HAL_RCC_Cmd_t){
					.RCC_AHB1Periph = RCC_AHB1Periph_GPIOE,
				},
				.GPIO_InitCfg = __CONST_CAST_VAR(GPIO_InitTypeDef){		
					.GPIO_Pin = GPIO_Pin_1,
					.GPIO_Mode = GPIO_Mode_AF,
					.GPIO_Speed = GPIO_Speed_50MHz,
					.GPIO_OType = GPIO_OType_PP,
					.GPIO_PuPd = GPIO_PuPd_NOPULL
				},
				.GPIO_AF_PinSource = GPIO_PinSource1,
				.GPIO_AF_Mapping = GPIO_AF_DCMI,
			},
			__CONST_CAST_VAR(HAL_GPIO_pin_t){
				.GPIOx = GPIOE, //DCMI_D4 - PE4
				.GPIO_RCC_cmd = __CONST_CAST_VAR(HAL_RCC_Cmd_t){
					.RCC_AHB1Periph = RCC_AHB1Periph_GPIOE,
				},
				.GPIO_InitCfg = __CONST_CAST_VAR(GPIO_InitTypeDef){		
					.GPIO_Pin = GPIO_Pin_4,
					.GPIO_Mode = GPIO_Mode_AF,
					.GPIO_Speed = GPIO_Speed_50MHz,
					.GPIO_OType = GPIO_OType_PP,
					.GPIO_PuPd = GPIO_PuPd_NOPULL
				},
				.GPIO_AF_PinSource = GPIO_PinSource4,
				.GPIO_AF_Mapping = GPIO_AF_DCMI,
			},
			__CONST_CAST_VAR(HAL_GPIO_pin_t){
				.GPIOx = GPIOB, //DCMI_D5 - PB6
				.GPIO_RCC_cmd = __CONST_CAST_VAR(HAL_RCC_Cmd_t){
					.RCC_AHB1Periph = RCC_AHB1Periph_GPIOB,
				},
				.GPIO_InitCfg = __CONST_CAST_VAR(GPIO_InitTypeDef){		
					.GPIO_Pin = GPIO_Pin_6,
					.GPIO_Mode = GPIO_Mode_AF,
					.GPIO_Speed = GPIO_Speed_50MHz,
					.GPIO_OType = GPIO_OType_PP,
					.GPIO_PuPd = GPIO_PuPd_NOPULL
				},
				.GPIO_AF_PinSource = GPIO_PinSource6,
				.GPIO_AF_Mapping = GPIO_AF_DCMI,
			},
			__CONST_CAST_VAR(HAL_GPIO_pin_t){
				.GPIOx = GPIOE, //DCMI_D6 - PE5
				.GPIO_RCC_cmd = __CONST_CAST_VAR(HAL_RCC_Cmd_t){
					.RCC_AHB1Periph = RCC_AHB1Periph_GPIOE,
				},
				.GPIO_InitCfg = __CONST_CAST_VAR(GPIO_InitTypeDef){		
					.GPIO_Pin = GPIO_Pin_5,
					.GPIO_Mode = GPIO_Mode_AF,
					.GPIO_Speed = GPIO_Speed_50MHz,
					.GPIO_OType = GPIO_OType_PP,
					.GPIO_PuPd = GPIO_PuPd_NOPULL
				},
				.GPIO_AF_PinSource = GPIO_PinSource5,
				.GPIO_AF_Mapping = GPIO_AF_DCMI,
			},
			__CONST_CAST_VAR(HAL_GPIO_pin_t){
				.GPIOx = GPIOE, //DCMI_D7 - PE6
				.GPIO_RCC_cmd = __CONST_CAST_VAR(HAL_RCC_Cmd_t){
					.RCC_AHB1Periph = RCC_AHB1Periph_GPIOE,
				},
				.GPIO_InitCfg = __CONST_CAST_VAR(GPIO_InitTypeDef){		
					.GPIO_Pin = GPIO_Pin_6,
					.GPIO_Mode = GPIO_Mode_AF,
					.GPIO_Speed = GPIO_Speed_50MHz,
					.GPIO_OType = GPIO_OType_PP,
					.GPIO_PuPd = GPIO_PuPd_NOPULL
				},
				.GPIO_AF_PinSource = GPIO_PinSource6,
				.GPIO_AF_Mapping = GPIO_AF_DCMI,
			},
			__CONST_CAST_VAR(HAL_GPIO_pin_t){
				.GPIOx = GPIOA, //DCMI_HSYNC - PA4
				.GPIO_RCC_cmd = __CONST_CAST_VAR(HAL_RCC_Cmd_t){
					.RCC_AHB1Periph = RCC_AHB1Periph_GPIOA,
				},
				.GPIO_InitCfg = __CONST_CAST_VAR(GPIO_InitTypeDef){		
					.GPIO_Pin = GPIO_Pin_4,
					.GPIO_Mode = GPIO_Mode_AF,
					.GPIO_Speed = GPIO_Speed_50MHz,
					.GPIO_OType = GPIO_OType_PP,
					.GPIO_PuPd = GPIO_PuPd_NOPULL
				},
				.GPIO_AF_PinSource = GPIO_PinSource4,
				.GPIO_AF_Mapping = GPIO_AF_DCMI,
			},
			__CONST_CAST_VAR(HAL_GPIO_pin_t){
				.GPIOx = GPIOA, //DCMI_PIXCLK - PA6
				.GPIO_RCC_cmd = __CONST_CAST_VAR(HAL_RCC_Cmd_t){
					.RCC_AHB1Periph = RCC_AHB1Periph_GPIOA,
				},
				.GPIO_InitCfg = __CONST_CAST_VAR(GPIO_InitTypeDef){		
					.GPIO_Pin = GPIO_Pin_6,
					.GPIO_Mode = GPIO_Mode_AF,
					.GPIO_Speed = GPIO_Speed_50MHz,
					.GPIO_OType = GPIO_OType_PP,
					.GPIO_PuPd = GPIO_PuPd_NOPULL
				},
				.GPIO_AF_PinSource = GPIO_PinSource6,
				.GPIO_AF_Mapping = GPIO_AF_DCMI,
			},
			__CONST_CAST_VAR(HAL_GPIO_pin_t){
				.GPIOx = GPIOB, //DCMI_VSYNC - PB7
				.GPIO_RCC_cmd = __CONST_CAST_VAR(HAL_RCC_Cmd_t){
					.RCC_AHB1Periph = RCC_AHB1Periph_GPIOB,
				},
				.GPIO_InitCfg = __CONST_CAST_VAR(GPIO_InitTypeDef){		
					.GPIO_Pin = GPIO_Pin_7,
					.GPIO_Mode = GPIO_Mode_AF,
					.GPIO_Speed = GPIO_Speed_50MHz,
					.GPIO_OType = GPIO_OType_PP,
					.GPIO_PuPd = GPIO_PuPd_NOPULL
				},
				.GPIO_AF_PinSource = GPIO_PinSource7,
				.GPIO_AF_Mapping = GPIO_AF_DCMI,
			},
			NULL,//GPIO must null terminated
		},
		.DCMI_InitCfg = __CONST_CAST_VAR(DCMI_InitTypeDef){
			.DCMI_CaptureMode = DCMI_CaptureMode_SnapShot,
			.DCMI_SynchroMode = DCMI_SynchroMode_Hardware,
			.DCMI_PCKPolarity = DCMI_PCKPolarity_Rising,
			.DCMI_VSPolarity = DCMI_VSPolarity_Low,
			.DCMI_HSPolarity = DCMI_HSPolarity_Low,
			.DCMI_CaptureRate = DCMI_CaptureRate_All_Frame,
			.DCMI_ExtendedDataMode = DCMI_ExtendedDataMode_8b,
		},
		.DCMI_NVIC_InitCfg = __CONST_CAST_VAR(NVIC_InitTypeDef){
			.NVIC_IRQChannel = DCMI_IRQn,
			.NVIC_IRQChannelPreemptionPriority = 2,
			.NVIC_IRQChannelSubPriority = 2,
			.NVIC_IRQChannelCmd = ENABLE,
		},
		.DCMI_RxDma_Cfg = __VAR_CAST_VAR(HAL_DMA_t){
			.DMA_RCC_Cmd = __CONST_CAST_VAR(HAL_RCC_Cmd_t){
				.RCC_AHB1Periph = RCC_AHB1Periph_DMA2,
			},
			.DMA_Streamx = DMA2_Stream1,
			.DMA_InitCfg = __CONST_CAST_VAR(DMA_InitTypeDef){
				.DMA_Channel = DMA_Channel_1,
				.DMA_PeripheralBaseAddr = 0,
				.DMA_Memory0BaseAddr = 0,
				.DMA_DIR = DMA_DIR_PeripheralToMemory,
				.DMA_BufferSize = 0, 
				.DMA_PeripheralInc = DMA_PeripheralInc_Disable,
				.DMA_MemoryInc = DMA_MemoryInc_Enable,
				.DMA_PeripheralDataSize = DMA_PeripheralDataSize_Word,
				.DMA_MemoryDataSize = DMA_PeripheralDataSize_Word,
				.DMA_Mode = DMA_Mode_Normal,
				.DMA_Priority = DMA_Priority_High,
				.DMA_FIFOMode = DMA_FIFOMode_Enable,
				.DMA_FIFOThreshold = DMA_FIFOThreshold_Full,
				.DMA_MemoryBurst = DMA_MemoryBurst_INC4,
				.DMA_PeripheralBurst = DMA_PeripheralBurst_Single,
			},
			.DMA_NVIC_InitCfg = __CONST_CAST_VAR(NVIC_InitTypeDef){
				.NVIC_IRQChannel = DMA2_Stream1_IRQn,
				.NVIC_IRQChannelPreemptionPriority = 2,
				.NVIC_IRQChannelSubPriority = 2,
				.NVIC_IRQChannelCmd = ENABLE,
			},
		},
	},//dcmi
	.CamOV2640_I2C = __CONST_CAST_VAR(HAL_I2C_t){
		.I2Cx = I2C1,
		.I2C_RCC_Cmd = __CONST_CAST_VAR(HAL_RCC_Cmd_t){
			.RCC_APB1Periph = RCC_APB1Periph_I2C1,
		},
		.I2C_InitCfg = __CONST_CAST_VAR(I2C_InitTypeDef){
			.I2C_Mode = I2C_Mode_I2C,
			.I2C_DutyCycle = I2C_DutyCycle_2,
			.I2C_OwnAddress1 =0x0A, 
			.I2C_Ack = I2C_Ack_Enable,
			.I2C_AcknowledgedAddress = I2C_AcknowledgedAddress_7bit,	
			.I2C_ClockSpeed = 400000, //400k
		},
		.I2C_SCL_pin = __CONST_CAST_VAR(HAL_GPIO_pin_t){
			.GPIOx = GPIOB, //I2C1_SCL - PB8
			.GPIO_RCC_cmd = __CONST_CAST_VAR(HAL_RCC_Cmd_t){
				.RCC_AHB1Periph = RCC_AHB1Periph_GPIOB,
			},
			.GPIO_InitCfg = __CONST_CAST_VAR(GPIO_InitTypeDef){		
				.GPIO_Pin = GPIO_Pin_8,
				.GPIO_Mode = GPIO_Mode_AF,
				.GPIO_Speed = GPIO_Speed_2MHz,
				.GPIO_OType = GPIO_OType_OD,
				.GPIO_PuPd = GPIO_PuPd_NOPULL
			},
			.GPIO_AF_PinSource = GPIO_PinSource8,
			.GPIO_AF_Mapping = GPIO_AF_I2C1,
		},
		.I2C_SDA_pin = __CONST_CAST_VAR(HAL_GPIO_pin_t){
			.GPIOx = GPIOB, //I2C1_SCL - PB9
			.GPIO_RCC_cmd = __CONST_CAST_VAR(HAL_RCC_Cmd_t){
				.RCC_AHB1Periph = RCC_AHB1Periph_GPIOB,
			},
			.GPIO_InitCfg = __CONST_CAST_VAR(GPIO_InitTypeDef){		
				.GPIO_Pin = GPIO_Pin_9,
				.GPIO_Mode = GPIO_Mode_AF,
				.GPIO_Speed = GPIO_Speed_2MHz,
				.GPIO_OType = GPIO_OType_OD,
				.GPIO_PuPd = GPIO_PuPd_NOPULL
			},
			.GPIO_AF_PinSource = GPIO_PinSource9,
			.GPIO_AF_Mapping = GPIO_AF_I2C1,
		}
	},//I2C
	.CamOV2640_PWDN_pin = __CONST_CAST_VAR(HAL_GPIO_pin_t){
		.GPIOx = GPIOE, //PWDN - PE2 - active high
		.GPIO_RCC_cmd = __CONST_CAST_VAR(HAL_RCC_Cmd_t){
			.RCC_AHB1Periph = RCC_AHB1Periph_GPIOE,
		},
		.GPIO_InitCfg = __CONST_CAST_VAR(GPIO_InitTypeDef){		
			.GPIO_Pin = GPIO_Pin_2,
			.GPIO_Mode = GPIO_Mode_OUT,
			.GPIO_Speed = GPIO_Speed_2MHz,
			.GPIO_OType = GPIO_OType_PP,
			.GPIO_PuPd = GPIO_PuPd_NOPULL, //external pulldown
		},
	},//PWDN_Pin
	.CamOV2640_Config = __VAR_CAST_VAR(Device_CamOV2640_ConfigFile_t){
		.CamOV2640_JpegFormat = JPEG_320x240,
		.CamOV2640_Qs = 0x0C,
		.CamOV2640_Brightness = BRIGHTNESS_NORMAL,
		.CamOV2640_Contrast = CONTRAST_NORMAL,
		.CamOV2640_LightMode = LIGHTMODE_OFFICE,
		.CamOV2640_Mirror = false,
		.CamOV2640_Flip = false,
	},
	.CamOV2640_Buffer = NULL,
	.CamOV2640_Buffer_Len = 0,
    // buffer using frame pool
	// .CamOV2640_Buffer = __VAR_ARRAY_CAST_VAR(uint8_t,1024*12){0},
	// .CamOV2640_Buffer_Len = 1024*12,
};

Device_CamOV2640_t* Dev_Cam_OV2640 = &Dev_Cam_OV2640_Inst;
