aiex718/CCTV3.0-F407/MDK/CCTV3_F407_MDK_REV200/User/bsp/platform/device/dev_current_trig.h

#ifndef DEV_CURRENT_TRIG_H
#define DEV_CURRENT_TRIG_H

#include "bsp/platform/platform_defs.h"
#include "device/current_trig.h"

extern Device_CurrentTrig_t Dev_CurrentTrig_Inst;
extern Device_CurrentTrig_t *Dev_CurrentTrig;

#endif
