aiex718/CCTV3.0-F407/MDK/CCTV3_F407_MDK_REV200/User/device/cam_ov2640/cam_ov2640_configs.c

#include "device/cam_ov2640/cam_ov2640_configs.h"

const uint8_t CAM_OV2640_JPEG_INIT[190][2] =
    {
        0xff,
        0x00, // BANK0
        0x2c,
        0xff,
        0x2e,
        0xdf,
        0xff,
        0x01, // BANK1
        0x3c,
        0x32,
        0x11,
        0x00, // 7th(highest bit)for freq doubler, last 5 bit for CLKDIV
        0x09,
        0x02,
        0x04,
        0x28,
        0x13,
        0xe5,
        0x14,
        0x48,
        0x2c,
        0x0c,
        0x33,
        0x78,
        0x3a,
        0x33,
        0x3b,
        0xfB,
        0x3e,
        0x00,
        0x43,
        0x11,
        0x16,
        0x10,
        0x39,
        0x92,
        0x35,
        0xda,
        0x22,
        0x1a,
        0x37,
        0xc3,
        0x23,
        0x00,
        0x34,
        0xc0,
        0x36,
        0x1a,
        0x06,
        0x88,
        0x07,
        0xc0,
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
        0x00, // BANK0
        0xe5,
        0x7f,
        0xf9,
        0xc0,
        0x41,
        0x24,
        0xe0,
        0x14,
        0x76,
        0xff,
        0x33,
        0xa0,
        0x42,
        0x20,
        0x43,
        0x18,
        0x4c,
        0x00,
        0x87,
        0xd5,
        0x88,
        0x3f,
        0xd7,
        0x03,
        0xd9,
        0x10,
        0xd3,
        0x82,
        0xc8,
        0x08,
        0xc9,
        0x80,
        0x7c,
        0x00,
        0x7d,
        0x00,
        0x7c,
        0x03,
        0x7d,
        0x48,
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
        0x89,
        0x51,
        0xc8,
        0x52,
        0x96,
        0x53,
        0x00,
        0x54,
        0x00,
        0x55,
        0x00,
        0x57,
        0x00,
        0x5a,
        0x58,
        0x5b,
        0x48,
        0x5c,
        0x00,
        0xe0,
        0x00,
};
