aiex718/CCTV3.0-F407/MDK/CCTV3_F407_MDK_REV200/User/app/uartcmd/uartcmd.h

#ifndef UARTCMD_H
#define UARTCMD_H

#include "bsp/platform/platform_defs.h"

typedef struct UartCmd_s
{
    uint8_t UartCmd_RxBuf[DEBUG_SERIAL_RX_BUFFER_SIZE];
} UartCmd_t;

void UartCmd_Service(UartCmd_t *self);

#endif
