aiex718/CCTV3.0-F407/MDK/CCTV3_F407_MDK_REV200/User/bsp/sys/bitflag.h

#ifndef __BITFLAG_H__
#define __BITFLAG_H__

#include "bsp/platform/platform_defs.h"

//make sure your cpu can read/write BitFlag_t atomically
//otherwise, you should use mutex or cas to protect it
#ifndef BitFlag32_t
typedef __IO uint32_t BitFlag32_t;
#endif

#ifndef BitFlag16_t
typedef __IO uint16_t BitFlag16_t;
#endif

#ifndef BitFlag8_t
typedef __IO uint8_t BitFlag8_t;
#endif

#define BitFlag_IdxToBin(idx) (1<<(idx))

//f must be not zero
__STATIC_INLINE uint8_t BitFlag_BinToIdx(BitFlag32_t f){
    uint8_t result = 0;
    while (f >>= 1)result++;
    return result;
}

#define BitFlag_Clear(flag)         ((flag) = 0)

#define BitFlag_SetBit(flag,bin)    ((flag) |= (bin))
#define BitFlag_ClearBit(flag,bin)  ((flag) &= ~(bin))
#define BitFlag_IsBitSet(flag,bin) ((flag) & (bin))

#define BitFlag_SetIdx(flag,idx)   BitFlag_SetBit((flag),BitFlag_IdxToBin(idx))
#define BitFlag_ClearIdx(flag,idx) BitFlag_ClearBit((flag),BitFlag_IdxToBin(idx))
#define BitFlag_IsIdxSet(flag,idx) BitFlag_IsBitSet((flag),BitFlag_IdxToBin(idx))

#endif
