aiex718/CCTV3.0-F407/MDK/CCTV3_F407_MDK_REV200/User/bsp/platform/platform_opts.h

#ifndef __PLATFORM_OPTS_H__
#define __PLATFORM_OPTS_H__

//sections
#define __HW_BUF_SECTION __attribute__((section("HW_BUF")))

#define DEBUG_SERIAL_USART_TX_BUFFER_SIZE 256
#define DEBUG_SERIAL_USART_RX_BUFFER_SIZE 16
#define DEBUG_SERIAL_TX_BUFFER_SIZE 1024
#define DEBUG_SERIAL_RX_BUFFER_SIZE 16

#define DBG_SERIAL_ENABLE_DMA 1
#define DBG_SERIAL_SHOW_INFO 1

#define ETHERNETIF_SERVICE_PERIOD 200
#define DEVICE_CAM_OV2640_DEBUG 0

//Webapi
#define WEBAPI_RESPONSE_BUFFER_LEN 512

//disks
#define FLASH_W25QX_MODEL 128

//USB FS
#define USE_USB_OTG_FS 
#define USE_EMBEDDED_PHY 
#define USE_DEVICE_MODE 

//Current Trig
#define CURRENT_TRIG_DEBUG_PRINT_EVENT 1
#define CURRENT_TRIG_ADC_BUF_SIZE 128
#define CURRENT_TRIG_VAL_BUF_SIZE 256
#define CURRENT_TRIG_SCAN_WINDOW 128
#define CURRENT_TRIG_SCAN_ROLLBACK (CURRENT_TRIG_SCAN_WINDOW/2)
#define CURRENT_TRIG_ADC_VREF 2.5F
#define CURRENT_TRIG_SENSING_RESISTOR_VAL 100

#endif
