aiex718/CCTV3.0-F407/MDK/CCTV3_F407_MDK_REV200/User/bsp/platform/app/app_list.h

#ifndef __APP_LIST_H__
#define __APP_LIST_H__

#include "bsp/platform/app/app_mjpegd.h"
#include "bsp/platform/app/app_nettime.h"
#include "bsp/platform/app/app_filesys.h"
#include "bsp/platform/app/app_webhook.h"
#include "bsp/platform/app/app_uartcmd.h"

#endif
