aiex718/CCTV3.0-F407/MDK/CCTV3_F407_MDK_REV200/User/bsp/platform/app/app_webhook.h

#ifndef APP_WEBHOOK_H
#define APP_WEBHOOK_H

#include "bsp/platform/platform_defs.h"
#include "app/webhook/webhook.h"

extern Webhook_t App_Webhook_Triggered_Inst;
extern Webhook_t* App_Webhook_Triggered;


#endif
