aiex718/CCTV3.0-F407/MDK/CCTV3_F407_MDK_REV200/User/app/mjpegd/mjpegd_client.h

#ifndef __MJPEGD_CLIENT_H__
#define __MJPEGD_CLIENT_H__

#include "app/mjpegd/mjpegd.h"
#include "app/mjpegd/mjpegd_opts.h"
#include "app/mjpegd/mjpegd_frame.h"


/** Helper macro as function **/
#define client_assign_file(_cs,_file,_len) do{  \
(_cs)->file = (_file);                          \
(_cs)->file_len = (_len);                       \
(_cs)->file_wptr = cs->file;                    \
(_cs)->retries=0;                               \
} while (0)
#define client_file_isvalid(_cs) ((_cs)->file!=NULL && (_cs)->file_wptr!=NULL && (_cs)->file_len>0)
#define client_file_bytestosend(_cs) ((_cs)->file + (_cs)->file_len - (_cs)->file_wptr)


typedef enum 
{
    CS_NONE = 0,
    CS_ACCEPTED,
    CS_RECEIVED,
    CS_CLOSING,
    CS_CLOSED,
    CS_TCP_ERR,
}conn_state_enum;
typedef s8_t conn_state_t;

typedef struct ClientState_s ClientState_t;
struct ClientState_s 
{
    struct tcp_pcb* pcb;
    void* parent_mjpeg;

    const struct Mjpegd_RequestHandler_s *request_handler;

    //file to send
    u8_t *file;
    u8_t *file_wptr;
    u16_t file_len;

    conn_state_t conn_state;
    u8_t retries;

    //callback when eof reached to get next file
    //if NULL, client will be closed
    err_t (*get_nextfile_func)(struct ClientState_s *cs);
    
    Mjpegd_Frame_t* frame;
    MJPEGD_SYSTIME_T previous_frame_time;

    //time_period for fps control
    MJPEGD_SYSTIME_T previous_transfer_time;
    //private linklist
    ClientState_t *_next;
    u16_t fps_period;
};

ClientState_t* Mjpegd_Client_New(Mjpegd_t *mjpegd, struct tcp_pcb *pcb);
void Mjpegd_Client_Free(ClientState_t *cs);


#endif // __MJPEGD_CLIENT_H__
