aiex718/CCTV3.0-F407/MDK/CCTV3_F407_MDK_REV200/User/app/mjpegd/mjpegd_request.h

#ifndef __MJPEGD_REQUEST_H__
#define __MJPEGD_REQUEST_H__

#include "lwip/err.h"
#include "app/mjpegd/mjpegd_client.h"

typedef enum 
{
    REQUEST_NOTFOUND = 0,
    REQUEST_TOOMANY,
    REQUEST_HANDSHAKE,
    REQUEST_VIEW_SNAP,
    REQUEST_VIEW_STREAM,
    REQUEST_VIEW_FPS,
    REQUEST_SNAP,
    REQUEST_STREAM,
    
    __NOT_REQUEST_MAX
} request_enum;
typedef s8_t request_t;

#if MJPEGD_DEBUG
extern const char * const request_strreq[__NOT_REQUEST_MAX];
#define mjpegd_strreq(x) (request_strreq[x])
#else
#define mjpegd_strreq(x) ""
#endif

typedef struct Mjpegd_RequestHandler_s
{
    request_t req;
    u16_t     response_len;
    const char      *url;
    const char      *response;
    err_t (* get_nextfile_func)(struct ClientState_s *cs);
    err_t (* recv_request_func)(struct ClientState_s *cs);
    err_t (* clsd_request_func)(struct ClientState_s *cs);
}Mjpegd_RequestHandler_t;

extern const Mjpegd_RequestHandler_t mjpegd_request_handlers[__NOT_REQUEST_MAX];

err_t Mjpegd_Request_Parse(struct ClientState_s *cs,char* req,u16_t req_len);
err_t Mjpegd_Request_BuildResponse(struct ClientState_s *cs);

#endif // __MJPEGD_REQUEST_H__
