aiex718/CCTV3.0-F407/MDK/CCTV3_F407_MDK_REV200/User/bsp/platform/periph/peri_flash_prog.h

#ifndef PERI_FLASH_PROG_H
#define PERI_FLASH_PROG_H

#include "bsp/platform/platform_defs.h"
#include "bsp/hal/flash_prog.h"

extern HAL_FlashProg_t Peri_FlashProg_Inst;
extern HAL_FlashProg_t* Peri_FlashProg;


#endif
