aiex718/CCTV3.0-F407/MDK/CCTV3_F407_MDK_REV200/User/bsp/platform/device/device_list.h

#ifndef __DEVICE_LIST_H__
#define __DEVICE_LIST_H__

#include "bsp/platform/device/dev_buzzer.h"
#include "bsp/platform/device/dev_cam_ov2640.h"
#include "bsp/platform/device/dev_flashlight.h"
#include "bsp/platform/device/dev_disk.h"
#include "bsp/platform/device/dev_usbotg_fs.h"
#include "bsp/platform/device/dev_current_trig.h"
#include "bsp/platform/device/dev_ethernetif.h"
#include "bsp/platform/device/dev_led_indicator.h"
#include "bsp/platform/device/dev_button.h"
#include "bsp/platform/device/dev_config_storage.h"

#endif
