aiex718/CCTV3.0-F407/MDK/CCTV3_F407_MDK_REV200/User/bsp/platform/periph/periph_list.h

#ifndef PERIPH_LIST_H
#define PERIPH_LIST_H

#include "bsp/platform/periph/peri_dbgserial.h"
#include "bsp/platform/periph/peri_gpio.h"
#include "bsp/platform/periph/peri_rcc.h"
#include "bsp/platform/periph/peri_rng.h"
#include "bsp/platform/periph/peri_uniqueid.h"
#include "bsp/platform/periph/peri_timer_pwm.h"
#include "bsp/platform/periph/peri_rtc.h"
#include "bsp/platform/periph/peri_adc.h"
#include "bsp/platform/periph/peri_flash_prog.h"


#endif
