aiex718/CCTV3.0-F407/MDK/CCTV3_F407_MDK_REV200/User/bsp/platform/device/dev_config_storage.h

#ifndef DEV_CONFIG_STORAGE_H
#define DEV_CONFIG_STORAGE_H


#include "bsp/platform/platform_defs.h"
#include "device/config_storage.h"

extern Config_Storage_t Dev_ConfigStorage_Inst;
extern Config_Storage_t *Dev_ConfigStorage;


#endif
