aiex718/CCTV3.0-F407/MDK/CCTV3_F407_MDK_REV200/User/bsp/platform/device/dev_ethernetif.h

#ifndef DEV_ETHERNETIF_H
#define DEV_ETHERNETIF_H

#include "bsp/platform/platform_defs.h"
#include "Standalone/ethernetif.h"

extern Ethernetif_t Dev_Ethernetif_Default_Inst;
extern Ethernetif_t *Dev_Ethernetif_Default;


#endif
