aiex718/CCTV3.0-F407/MDK/CCTV3_F407_MDK_REV200/User/bsp/platform/device/dev_button.h

#ifndef DEV_BUTTON_H
#define DEV_BUTTON_H

#include "bsp/platform/platform_defs.h"
#include "device/button.h"

extern Device_Button_t Dev_Button_Wkup_Inst;
extern Device_Button_t *Dev_Button_Wkup;

#endif
