aiex718/CCTV3.0-F407/MDK/CCTV3_F407_MDK_REV200/User/bsp/platform/device/dev_led_indicator.h

#ifndef DEV_LED_INDICATOR_H
#define DEV_LED_INDICATOR_H

#include "bsp/platform/platform_defs.h"
#include "device/led_indicator.h"

extern Device_LedIndicator_t Dev_Led_Blink_Inst;
extern Device_LedIndicator_t *Dev_Led_Blink;


#endif
