aiex718/CCTV3.0-F407/MDK/CCTV3_F407_MDK_REV200/User/bsp/hal/systick.c

#include "bsp/hal/systick.h"

void HAL_Systick_Init(void)
{
    RCC_ClocksTypeDef rcc_clocks;
    NVIC_PriorityGroupConfig(NVIC_PriorityGroup_2);
    RCC_GetClocksFreq(&rcc_clocks);
    SysTick_Config((rcc_clocks.HCLK_Frequency / 1000 ));
    NVIC_SetPriority(SysTick_IRQn, 0);
}
