aiex718/CCTV3.0-F407/MDK/CCTV3_F407_MDK_REV200/User/bsp/platform/periph/peri_adc.h

#ifndef PERI_ADC_H
#define PERI_ADC_H

#include "bsp/platform/platform_defs.h"
#include "bsp/hal/adc.h"

extern HAL_ADC_CommonCfg_t Peri_ADC_CommonCfg_Inst;
extern HAL_ADC_CommonCfg_t* Peri_ADC_CommonCfg;

#endif
