aiex718/CCTV3.0-F407/MDK/CCTV3_F407_MDK_REV200/User/bsp/platform/app/app_filesys.c

#include "bsp/platform/app/app_filesys.h"

#include "ff.h"

FileSys_t App_FileSys_Inst = {
    //Alloc mem for fs
    .fs = __VAR_CAST_VAR(FATFS) {
        0 
    },
};


FileSys_t *App_FileSys = &App_FileSys_Inst;
