aiex718/CCTV3.0-F407/MDK/CCTV3_F407_MDK_REV200/User/bsp/platform/device/dev_disk.h

#ifndef DEV_DISK_H
#define DEV_DISK_H

#include "bsp/platform/platform_defs.h"
#include "device/disk.h"

extern Disk_t Dev_Disk_Flash_Inst;
extern Disk_t *Dev_Disk_Flash;


extern Disk_t **Dev_Disk_list;

#endif
