aiex718/CCTV3.0-F407/MDK/CCTV3_F407_MDK_REV200/User/bsp/platform/device/dev_usbotg_fs.h

#ifndef DEV_USBOTG_FS_H
#define DEV_USBOTG_FS_H

#include "bsp/platform/platform_defs.h"
#include "device/usbotg_fs.h"

extern USBOTG_fs_t Dev_USBOTG_fs_Inst;
extern USBOTG_fs_t *Dev_USBOTG_fs;

#endif
