aiex718/CCTV3.0-F407/MDK/CCTV3_F407_MDK_REV200/User/bsp/hal/rtc.h

#ifndef RTC_H
#define RTC_H

#include "bsp/platform/platform_defs.h"
#include "bsp/hal/rcc.h"

#include "time.h"

typedef struct HAL_RTC_s
{
    HAL_RCC_Cmd_t *RTC_RCC_Cmd;
    RTC_InitTypeDef *RTC_InitCfg;
    uint32_t RTC_ClockSource;

    uint16_t RTC_Year_Offset;
    uint8_t RTC_Hour_Offset;
    uint8_t RTC_Minute_Offset;
    uint8_t RTC_WeekDay;
} HAL_RTC_t;

void HAL_RTC_Init(const HAL_RTC_t *self);
time_t HAL_RTC_GetTime(const HAL_RTC_t *self);
void HAL_RTC_GetTime_tm(const HAL_RTC_t *self,struct tm *ptm);
void HAL_RTC_SetTime_tm(const HAL_RTC_t *self,const struct tm *ptm);
void HAL_RTC_PrintTime(const HAL_RTC_t *self);
#endif
