aiex718/CCTV3.0-F407/MDK/CCTV3_F407_MDK_REV200/User/bsp/platform/device/dev_flashlight.h

#ifndef DEV_FLASHLIGHT_H
#define DEV_FLASHLIGHT_H

#include "bsp/platform/platform_defs.h"
#include "device/flashlight.h"

extern Device_FlashLight_t Dev_FlashLight_Top_Inst;
extern Device_FlashLight_t *Dev_FlashLight_Top;

extern Device_FlashLight_t Dev_FlashLight_Bottom_Inst;
extern Device_FlashLight_t *Dev_FlashLight_Bottom;


#endif
