aiex718/CCTV3.0-F407/MDK/CCTV3_F407_MDK_REV200/User/bsp/platform/periph/peri_timer_pwm.h

#ifndef PERI_TIMER_PWM_H
#define PERI_TIMER_PWM_H

#include "bsp/platform/platform_defs.h"
#include "bsp/hal/timer_pwm.h"

extern const HAL_Timer_PWM_t Periph_Timer_PWM_FlashLight_Inst;
extern const HAL_Timer_PWM_t *Periph_Timer_PWM_FlashLight;

#endif
