aiex718/CCTV3.0-F407/MDK/CCTV3_F407_MDK_REV200/User/bsp/hal/rng.c

#include "bsp/hal/rng.h"

void HAL_Rng_Init(const HAL_Rng_t* self)
{
    HAL_RCC_Cmd(self->Rng_RCC_Cmd,ENABLE);
    RNG_Cmd(ENABLE);
}

uint32_t HAL_Rng_Gen(const HAL_Rng_t* self)
{
    while(RNG_GetFlagStatus(RNG_FLAG_DRDY)==RESET);
    return RNG_GetRandomNumber();
}

uint32_t HAL_Rng_Gen_Range(const HAL_Rng_t* self,uint32_t min,uint32_t max)
{
    uint32_t range = max - min;
    uint32_t rand = HAL_Rng_Gen(self);
    return (rand % range) + min;
}

uint32_t HAL_Rng_Gen_Smaller(const HAL_Rng_t* self,uint32_t limit)
{
    uint32_t rand = HAL_Rng_Gen(self);
    return rand % limit;
}

uint32_t HAL_Rng_Gen_Larger(const HAL_Rng_t* self,uint32_t limit)
{
    uint32_t range = 0xffffffff - limit;
    uint32_t rand = HAL_Rng_Gen_Smaller(self,range);
    return limit + range + 1;
}
