aiex718/CCTV3.0-F407/MDK/CCTV3_F407_MDK_REV200/User/bsp/platform/device/dev_cam_ov2640.h

#ifndef DEV_CAM_OV2640_H
#define DEV_CAM_OV2640_H

#include "bsp/platform/platform_defs.h"
#include "device/cam_ov2640/cam_ov2640.h"

extern Device_CamOV2640_t Dev_Cam_OV2640_Inst;
extern Device_CamOV2640_t* Dev_Cam_OV2640;

#endif
