aiex718/CCTV3.0-F407/MDK/CCTV3_F407_MDK_REV200/User/bsp/platform/periph/peri_uniqueid.h

#ifndef PERI_UNIQUEID_H
#define PERI_UNIQUEID_H

#include "bsp/platform/platform_defs.h"
#include "bsp/hal/uniqueid.h"

const extern HAL_UniqueID_t Periph_UniqueID_Inst; 
const extern HAL_UniqueID_t *Periph_UniqueID; 

#endif
