aiex718/CCTV3.0-F407/MDK/CCTV3_F407_MDK_REV200/User/bsp/platform/platform_inst.h

#ifndef __PLATFORM_INST_H__
#define __PLATFORM_INST_H__

#include "bsp/platform/platform_defs.h"

#include "bsp/platform/periph/periph_list.h"
#include "bsp/platform/device/device_list.h"
#include "bsp/platform/app/app_list.h"

#endif
