aiex718/CCTV3.0-F407/MDK/CCTV3_F407_MDK_REV200/User/bsp/platform/periph/peri_dbgserial.h

#ifndef PERI_DBGSERIAL_H
#define PERI_DBGSERIAL_H

#include "bsp/platform/platform_defs.h"
#include "bsp/sys/dbg_serial.h"

//Debug serial
extern DBG_Serial_t Peri_DBG_Serial_Inst;
extern DBG_Serial_t *Peri_DBG_Serial;

#endif
