aiex718/CCTV3.0-F407/MDK/CCTV3_F407_MDK_REV200/User/bsp/sys/boolean.h

#ifndef BOOLEAN_H
#define BOOLEAN_H

#ifdef __STDC_VERSION__
#include <stdbool.h>
//#warning "Using stdbool.h"
#endif

#ifndef bool
typedef enum {
    false=0, true=1
} bool;

// #define bool uint8_t
// #define ture 1
// #define false 0
// #define __bool_true_false_are_defined 1
#endif


#endif
