aiex718/CCTV3.0-F407/(commit log)

2023-03-06 add CCTV3_POE_REV100
    [CCTV3_POE_REV100-B_Cu.gbl, CCTV3_POE_REV100-B_Mask.gbs, CCTV3_POE_REV100-B_Paste.gbp, CCTV3_POE_REV100-B_Silkscreen.gbo, CCTV3_POE_REV100-Edge_Cuts.gm1, CCTV3_POE_REV100-F_Cu.gtl, CCTV3_POE_REV100-F_Mask.gts, CCTV3_POE_REV100-F_Paste.gtp]
2023-03-06 Add CCTV3_F407_REV100
    [CCTV3_F407_REV100.kicad_pcb, CCTV3_F407_REV100.kicad_sch, ethernet.kicad_sch, highspeed_peripheral.kicad_sch, io.kicad_sch, mcu.kicad_sch, power.kicad_sch]
2023-03-06 add CCTV3_F407_REV200.
    [CCTV3_F407_REV200-B_Cu.gbl, CCTV3_F407_REV200-B_Mask.gbs, CCTV3_F407_REV200-B_Paste.gbp, CCTV3_F407_REV200-B_Silkscreen.gbo, CCTV3_F407_REV200-Edge_Cuts.gm1, CCTV3_F407_REV200-F_Cu.gtl, CCTV3_F407_REV200-F_Mask.gts, CCTV3_F407_REV200-F_Paste.gtp]
2023-03-06 Add MDK_REV200, helloworld uart.
2023-03-24 Usart3 hello world interrupt, init ver.
2023-03-25 USART add support for hybrid dma/stream mode.
2023-03-26 Fix rcc clock frequency, adjust systick priority to highest.
    [systick.c]
2023-03-26 Implement DMA init, deinit and cmd.
2023-03-26 USART use bitwise flag instead of callback pending queue to prevent duplicate callback. Change callback regist function.
    [callback.h, periph_list.c, periph_list.h, usart.c, usart.h]
2023-03-26 Add test project BSP-USART3-DMA-Stream-Hybrid
2023-03-28 Rename stm32f4xx_it.c to sysirq.c ,move USART3_IRq from periph_list.c to sysirq.c
2023-03-28 Fix wrong index type.
    [concurrent_queue.c]
2023-03-28 Update test BSP-USART3-DMA-Stream-Hybrid for renamed/moved file.
2023-03-30 Implement DMA IT, not test yet.
2023-03-30 Edit periph config for new implemented DMA
2023-03-30 Move dma init to usart init routine
2023-03-30 Fix Stream mode stress command, now end with '\n'
    [main.c]
2023-03-30 Fix BSP-USART3-DMA-Stream-Hybrid, add non-blocking fputc, will cause data loss when tx buffer full.
    [main.c, periph_list.c]
2023-04-01 Redo dma DMA_Stream_to_ITStatusFlags_Tbl
2023-04-01 Implement SPI, not test yet.
2023-04-01 Implement I2C, not test yet.
2023-04-01 add comment for dma.
2023-04-01 Rename original timer to systimer.
2023-04-01 Implement hardware timer.
2023-04-01 Implement timer_pwm based on timer
2023-04-01 Write a test for timer_pwm, prepare for a new branch for testing.
2023-04-01 Fix timer cmd pipeline issue.
    [timer.c, timer.h, timer_pwm.h]
2023-04-01 Implement device flashlight.
2023-04-01 Fix timer wrong nvic init code.
    [periph_list.c, timer.c, timer_pwm.c]
2023-04-01 Fix FlashLight-CH1-CH2 timer periph config wrong nvic and ITs.
    [periph_list.c]
2023-04-01 Fix BSP-Test main file caused by rename timer to systimer.
    [main.c]
2023-04-01 Fix some omitted naming while rename timer to systimer.
    [i2c.c, main.c, spi.c, systimer.h]
2023-04-01 Fix some omitted naming while rename timer to systimer(refer to 604f0b2).
    [main.c]
2023-04-05 Fix include path for various files and project.
    [ethernetif.c, main.c]
2023-04-06 Seperate Timer_PWM_Channel setting from Timer_PWM
2023-04-06 Edit attach logic, now only set pointer, move init part to Init function.
2023-04-19 Rename DMA callbacks, modify ReloadCfg now will reset callbacks and it flags,
    [dma.c, dma.h]
2023-04-19 change printf to DBG_INFO
2023-04-20 ImplementDevice_CamOV2640_SetBuf and Device_CamOV2640_SetQs, move frame_len from CAMOV2640_CALLBACK_NEWFRAME callback arg to self->CamOV2640_FrameBuf_Len.
2023-04-20 Move comment const string to frame_t
2023-04-20 add eof for frame, let snap can use frame data directly, remove cs->buffer.
    [mjpegd.c, mjpegd_client.c, mjpegd_client.h, mjpegd_frame.c, mjpegd_frame.h]
2023-04-21 Refactor mjpegd, camera not implemented.
2023-04-23 Move show drop to mjpegd.c, fix close client null handler problem, now can disconnect when tcp error.
    [mjpegd.c, mjpegd_client.c, mjpegd_client.h, mjpegd_frameproc.c, mjpegd_stream.c]
2023-04-23 Fix usart disable cmd dma not closed issue.
    [usart.c]
2023-04-24 Change payload_len to frame_len, original payload_len used for indicate plyload available len
2023-04-24 Fix debug function, edit options.
    [lwipopts.h, mjpegd_debug.h, mjpegd_opts.h]
2023-04-24 set ip to 0 when disconnect rj45 cable.
2023-04-27 update cpp props
2023-04-27 Add clock and mco init function to rcc.c/.h Fix debug serial_cmd.
    [dbg_serial.c, gpio.h, main.c, rcc.c, rcc.h]
2023-04-30 Fix rcc init null ref error.
    [rcc.c]
2023-05-02 Port lwip and device Flash_W25Qx.
2023-05-05 Implement adc and current trig, impl peak detection algo.
2023-05-05 Fix BitFlag wrong macro.
    [bitflag.h]
2023-05-05 Fix buf len not match
    [dev_current_trig.c]
2023-05-05 Add reset serial cmd
    [main.c]
2023-05-05 Fix write byte polling.
    [usart.c]
2023-05-09 implement led_indicator and button
2023-05-09 Fix Client_Closing error in Sent callback
    [mjpegd.c]
2023-05-09 Try fix frame leak caused by DoSnap reentrant.
    [dcmi.c, mjpegd_camera.c, mjpegd_framepool.c, mjpegd_memutils.h]
2023-05-09 Impl current_trig_config
2023-05-10 remove frame pool iscleared flag, adjust field order for better mem align.
2023-05-10 Edit adc and val buf len.
2023-05-10 Use malloc for frame sorting.
2023-05-10 Fix wrong debug flag
    [mjpegd_frameproc.c]
2023-05-11 Add current trig webhook.
2023-05-11 change button long press period.
2023-05-11 Make print_ip public.
2023-05-11 Fix long press delay
    [platform_callbacks.c, platform_callbacks.h]
2023-05-11 Make fps counter dont print when camera disabled.
2023-05-11 Fix wrong instance in config_storage
    [dev_config_storage.c]
2023-05-11 Impl uartcmd, move code.
2023-05-12 make current trig can be disable
2023-05-12 add option to not print open error
2023-05-13 edit http_builder, now insert can limit max len.
2023-05-13 Fix not null terminated string bug, add webapi buffer size.
    [platform_opts.h]
2023-05-13 move adc init after lwip
2024-10-22 Let buzzer beep when current trig
    [platform_callbacks.c]
